nasser1245/Imona-Stand-Charger/README.md

# Imona-Stand-Charger
## 
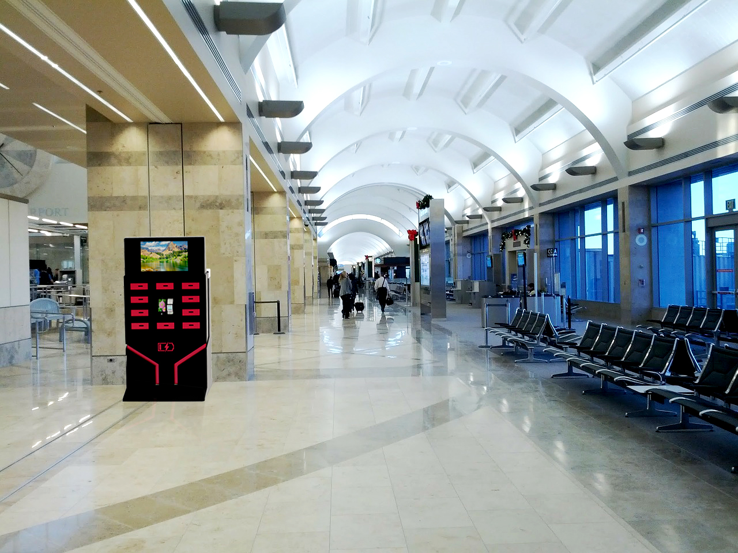
[picture p1: Brochure/123456789/2.jpg]
Imona Stand Charger
