nasser1245/Imona-Stand-Charger/Brochure/Text short.docx

کارا شارژ

دستگاهی برای شارژ امن و سریع گوشی در مکان های عمومی حس می شود. کارا شارژ یک دستگاه شارژ موبایل چند قفسه ای برای مکان های عمومی است. با کارا شارژ مشتریان و مراجعه کنندگان شما این امکان را پیدا می کنند که بدون دغدغه خاموش شدن گوشی شان به کار خود برسند و مطمئن باشند گوشی شان با اطلاعات ارزشمند ذخیره شده در آن در مکان امنی نگه داری می شود.

- احراز هویت مراجعه کنندگان با روش قدرتمند و امن شناسایی اثر انگشت
- امکان تعبیه دستگاه کارتخوان و اخذ هزینه شارژ

کارا شارژ برای چه جاهایی مناسب است

فرودگاه ها، ترمینال های مسافربری، تفرجگاه های بین راهی، مکان های زیارتی و سیاحتی، رستوران ها، مراکز فروش، سینما ها و تماشاخانه ها، باشگاه ها، بیمارستان ها و مراکز درمانی، ادارات و مراکز دولتی، هتل ها و مراکز اقامتی و ... از جمله مشتریان بالقوه کارا شارژ هستند.

ویژگی های کارا شارژ

طراحی منحصر به فرد که به محیط شما زیبایی خاصی می دهد.

بدنه فلزی مستحکم و ماندگار با رنگ الکترواستاتیک مقاوم در برابر خوردگی

قابلیت نگه داری و پشتیبانی بالا همراه با قفسه های ماژولار با قابلیت نصب آسان

ضد سرقت با درجه امنیتی بالا و قفل برقی داخلی مجزا به ازای هر قفسه

مکانیسم باز و بسته کردن اتوماتیک، همراه با درب بازشونده به داخل (ضد خرابکاری)

استفاده از دو جفت سیم جمع شونده به ازای هرقفسه قابل سفارش توسط مشتری (آیفون، اندروید، تایپ سی و ...)

قفل سیم شارژ با قابلیت تعویض آسان

قابلیت شارژ سریع با تکنولوژی Qualcomm Quick Charge 3.0

مکانیسم باز و بسته کردن سخت افزاری و نرم افزاری اضطراری قفسه ها توسط مسئول دستگاه

ضد آب و ضد گرد و خاک

LED های نشان دهنده وضعیت قفسه شارژ

تشخیص هویت با استفاده از سنسور اثر انگشت

باتری داخلی اضطراری

امکان کنترل و ارتباط از راه دور دستگاه با رابط اینترنتی

دوربین تعبیه شده با قابلیت ضبط تصاویر مراجعه کنندگان و ضبط ویدئو از محیط به صورت مدار بسته

گارانتی 18 ماهه و خدمات پس از فروش 5 ساله

ویژگی های قابل سفارش

امکان تعبیه صفحه نمایش جهت مصارف تبلیغاتی و اطلاع رسانی

امکان تعبیه پریز شارژ برای قفسه ها

امکان تعیین میزان هزینه شارژ و دریافت وجه با استفاده از دستگاه کارتخوان

امکان ارتباط با نرم افزار فروش یا نوبت دهی

خنک کنندگی مجزای هر قفسه با فن قدرتمند تعبیه شده برای بالا بردن راندمان شارژ (سفارشی)

امکان پرینت رسید گوشی و دریافت آن توسط رسید

مدل های دستگاه:

ایستاده

دیواری

رومیزی
