nasser1245/Imona-Stand-Charger/Brochure/text- new.docx

مکس شارژ چیست؟

با توجه به ظرفیت محدود باتری ها و پر رنگ شدن نقش تلفن های هوشمند در زندگی امروز نیاز به دستگاهی برای شارژ امن و سریع گوشی در مکان های عمومی حس می شود. مکس شارژ یک دستگاه شارژ موبایل چند قفسه ای برای مکان های عمومی است. با مکس شارژ مشتریان و مراجعه کنندگان شما این امکان را پیدا می کنند که بدون دغدغه خاموش شدن گوشی شان به کار خود برسند و مطمئن باشند گوشی شان با اطلاعات ارزشمند ذخیره شده در آن در مکان امنی نگه داری می شود. در صورت سفارش شما امکان تعبیه دستگاه کارتخوان و اخذ هزینه شارژ وجود دارد که می تواند به منبع درآمد خوبی برای محل کسب شما تبدیل شود.

احراز هویت مراجعه کنندگان

احراز هویت مراجعه کنندگان با روش قدرتمند و امن شناسایی اثر انگشت انجام می پذیرد. البته در صورت سفارش مشتری امکان احراز هویت با پرینت رسید وجود دارد. یک سیستم جانبی ضبط ویدئویی چهره نیز نیز به مسئول دستگاه کمک می کند در موارد نادر عدم تشخیص اثر انگشت؛ با تشخیص چهره مراجعه کننده نسبت به عودت تلفن همراه اقدام کند.

سیستم نرم افزاری قدرتمند آرشیو مراجعات و مدیریت از راه دور

یک سیستم جامع نرم افزاری آمار و تصاویر مراجه کنندگان، مدت زمان شارژ، ویدئوهای دوربین مدار بسته، مبلغ اخذ شده جهت شارژ و غیره را نگه داری و آرشیو می نماید و امکان گزارش گیری را به مسئول سیستم در صورت نیاز می دهد.

مکس شارژ برای چه جاهایی مناسب است؟

فرودگاه ها، ترمینال های مسافربری، تفرجگاه های بین راهی، اماکن های زیارتی و سیاحتی، رستوران ها، مراکز فروش، سینما ها و تماشاخانه ها، باشگاه ها، بیمارستان ها و مراکز درمانی، ادارات و مراکز دولتی، هتل ها و مراکز اقامتی و ... از جمله مشتریان بالقوه مکس شارژ هستند.

ویژگی های مکس شارژ

طراحی منحصر به فرد که به محیط شما زیبایی خاصی می دهد.

بدنه فلزی مستحکم و ماندگار با رنگ الکترواستاتیک مقاوم در برابر خوردگی

قابلیت نگه داری و پشتیبانی بالا همراه با قفسه های ماژولار با قابلیت نصب آسان

ضد سرقت با درجه امنیتی بالا و قفل برقی داخلی مجزا به ازای هر قفسه

مکانیسم باز و بسته کردن اتوماتیک، همراه با درب بازشونده به داخل (ضد خرابکاری)

استفاده از سه نوع رابط پرمصرف (اندرویید یا USB micro، لایتنینگ و USB type-c)

قابلیت شارژ با سیم شارژ گوشی و یا با پریز (شارژ گوشی)

نشانگر میزان شارژ به ازای هر اتصال

قفل سیم شارژ با قابلیت تعویض آسان

قابلیت شارژ سریع با تکنولوژی Qualcomm Quick Charge 3.0

مکانیسم باز و بسته کردن سخت افزاری و نرم افزاری اضطراری قفسه ها توسط مسئول دستگاه

تشخیص هویت با استفاده از سنسور اثر انگشت

باتری داخلی اضطراری

امکان کنترل و ارتباط از راه دور دستگاه با رابط اینترنتی

دوربین تعبیه شده با قابلیت ضبط تصاویر مراجعه کنندگان و ضبط ویدئو از محیط به صورت مدار بسته

گارانتی 18 ماهه و خدمات پس از فروش 5 ساله

ویژگی های قابل سفارش

امکان تعبیه صفحه نمایش جهت مصارف تبلیغاتی و اطلاع رسانی

امکان تعیین میزان هزینه شارژ و دریافت وجه با استفاده از دستگاه کارتخوان

خنک کنندگی مجزای هر قفسه با فن قدرتمند تعبیه شده برای بالا بردن راندمان شارژ

امکان پرینت رسید گوشی و دریافت آن توسط رسید

مدل های دستگاه:

ایستاده

دیواری

رومیزی

آدرس: تهران- چهارراه ولیعصر- جنب بازار کامپیوتر رضا- ساختمان 1504- طبقه 3- واحد 6

تلفن: 021-66402940

شرکت تجهیزات سها نوین
