nasser1245/Imona-Stand-Charger/Brochure/42x29.7-min.pdf

## و﹬︥_﹩\︀ی[︋︀_︨〉︀رش

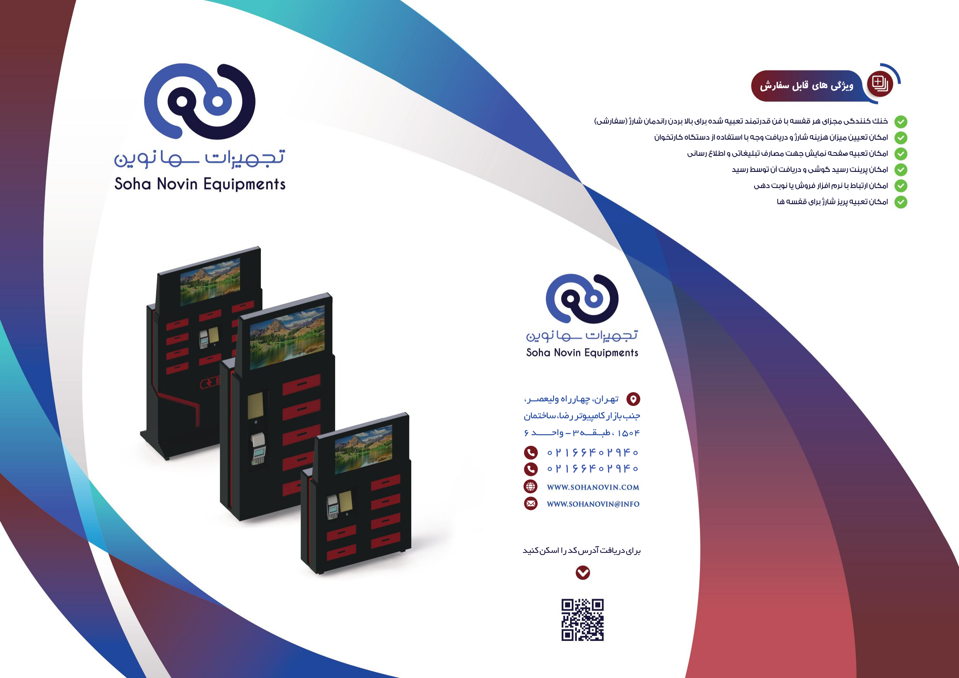
[picture p2: page 1]

### تهـران،چهـارراهولیعصــر، جنببازارکامپیوتررضا،ساختمان ،1504طبــقـــه-3واحــــــد6

02166402940
02166402940

براىدریافتآدرسکدرااسکنکنید

خنککنندگىمجزاىهرقفسهبافنقدرتمندتعبیهشدهبراىبالابردنراندمانشارژ(سفارشى) امکانتعیینمیزانهزینهشارژودریافتوجهبااستفادهازدستگاهکارتخوان امکانتعبیهصفحهنمای شجهتمصارفتبلیغاتىواطلاعرسانى امکانپرینترسیدگوشىودریافتآنتوسطرسید امکانارتباطبانرمافزارفرو شیانوبتدهى امکانتعبیهپریزشارژبراىقفسهها
