nasser1245/Imona-Stand-Charger/Brochure/02-01.jpg

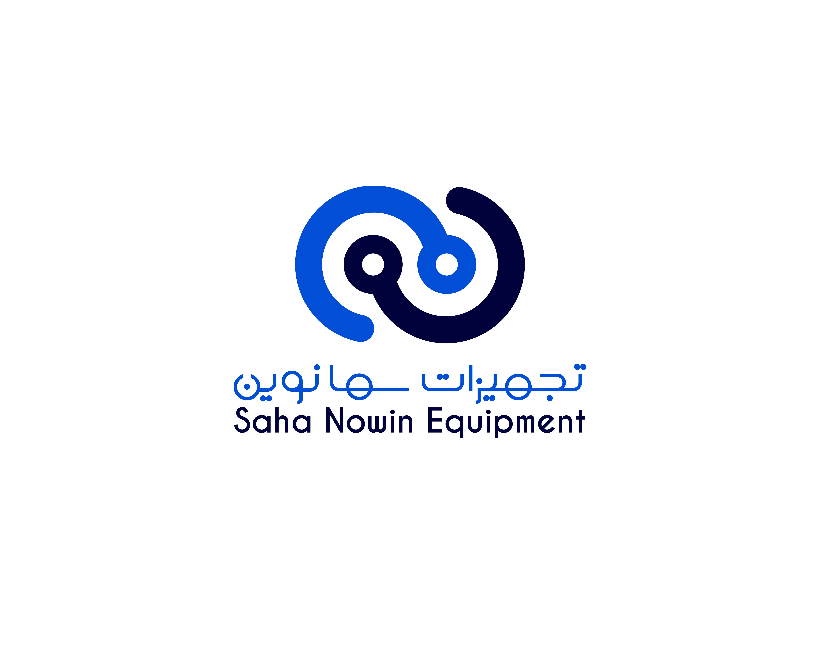
Brochure/02-01.jpg
