nasser1245/Imona-Stand-Charger/Brochure/00020.png

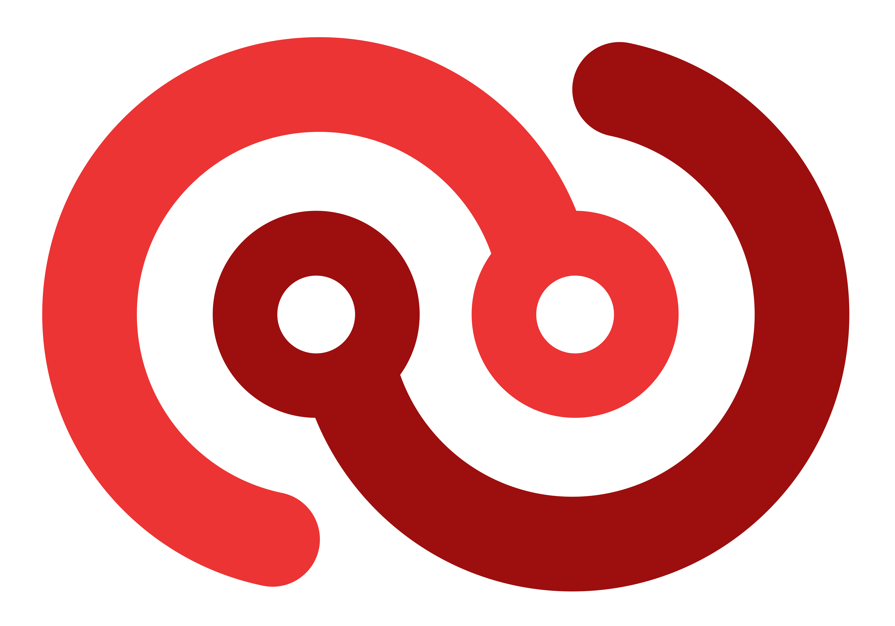
Brochure/00020.png
