nasser1245/Imona-Stand-Charger/Brochure/123456789/3.jpg

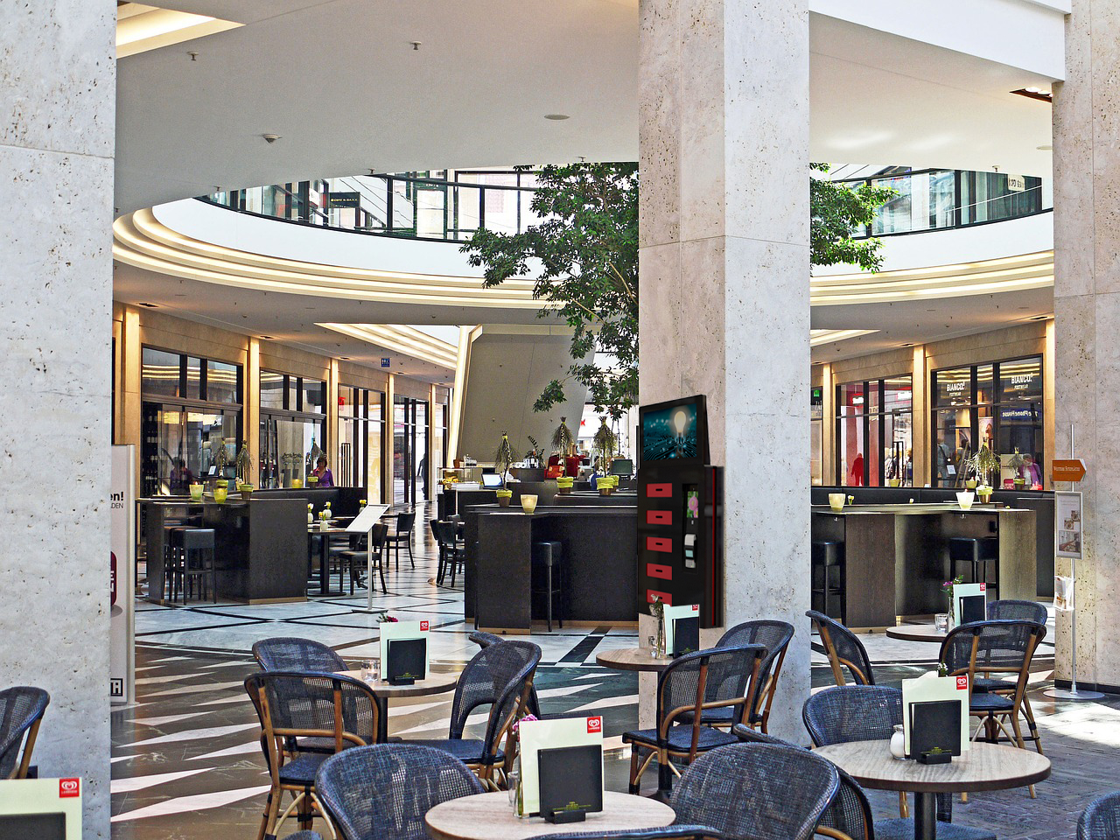
Brochure/123456789/3.jpg
