nasser1245/Imona-Stand-Charger/Brochure/123456789/4.jpg

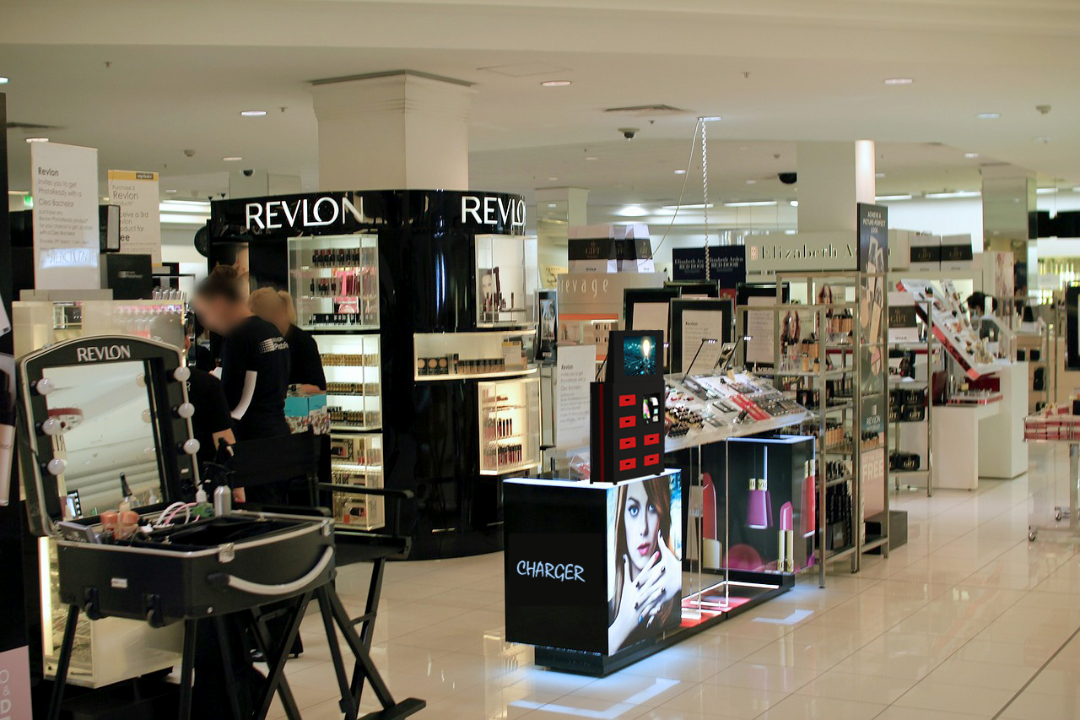
Brochure/123456789/4.jpg
