nasser1245/Imona-Stand-Charger/Brochure/airport-1659008_1280.jpg

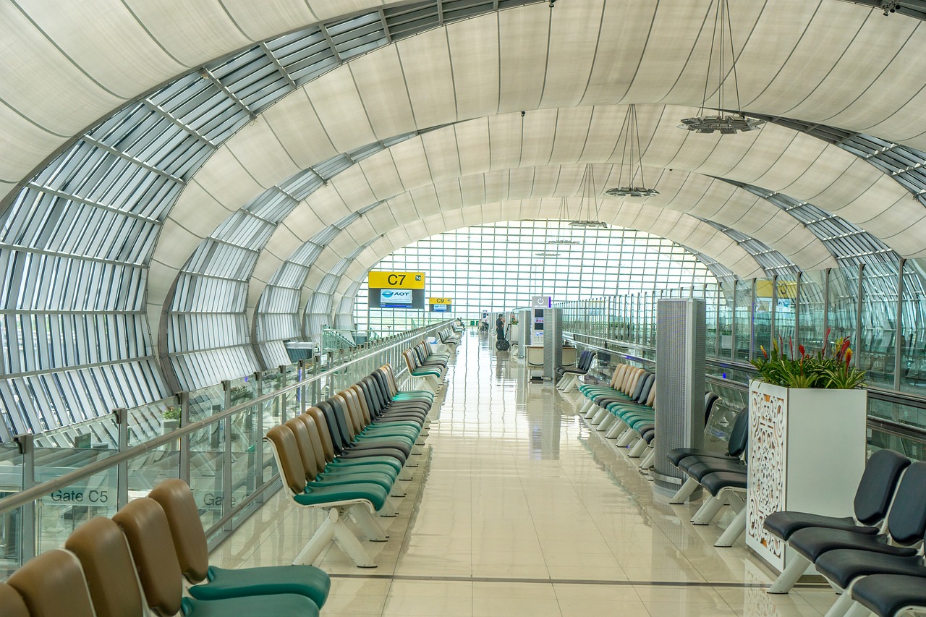
Brochure/airport-1659008_1280.jpg
