nasser1245/Imona-Stand-Charger/Brochure/airport-1807610_1280.jpg

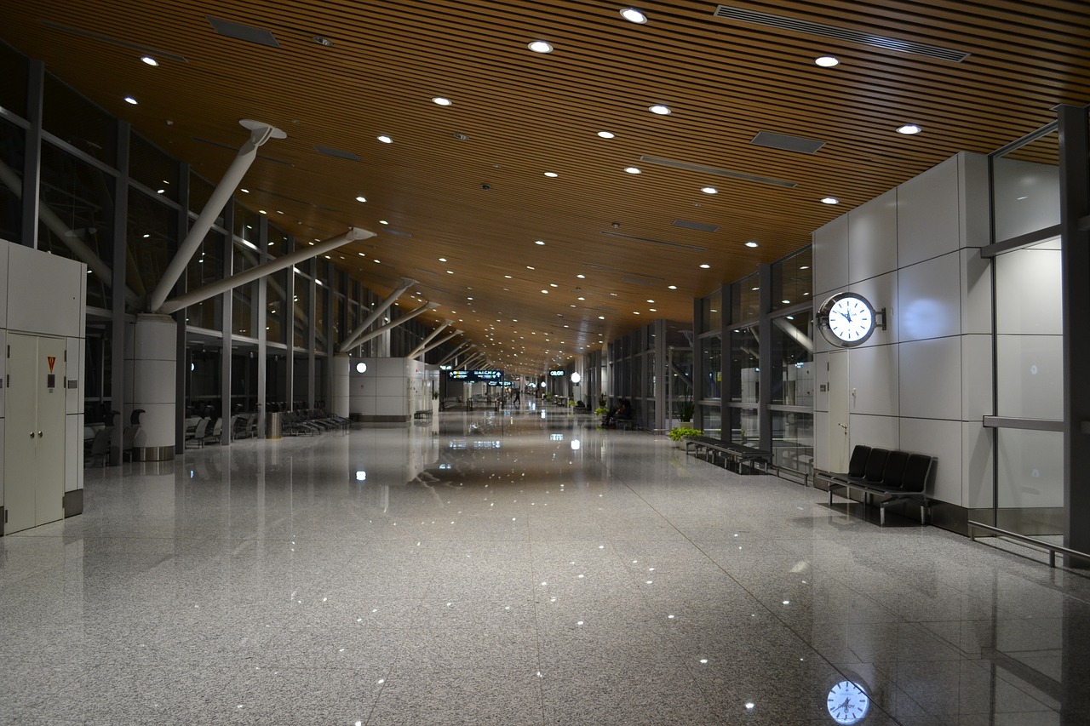
Brochure/airport-1807610_1280.jpg
