nasser1245/Imona-Stand-Charger/Brochure/baggage-hall-775540_1280.jpg

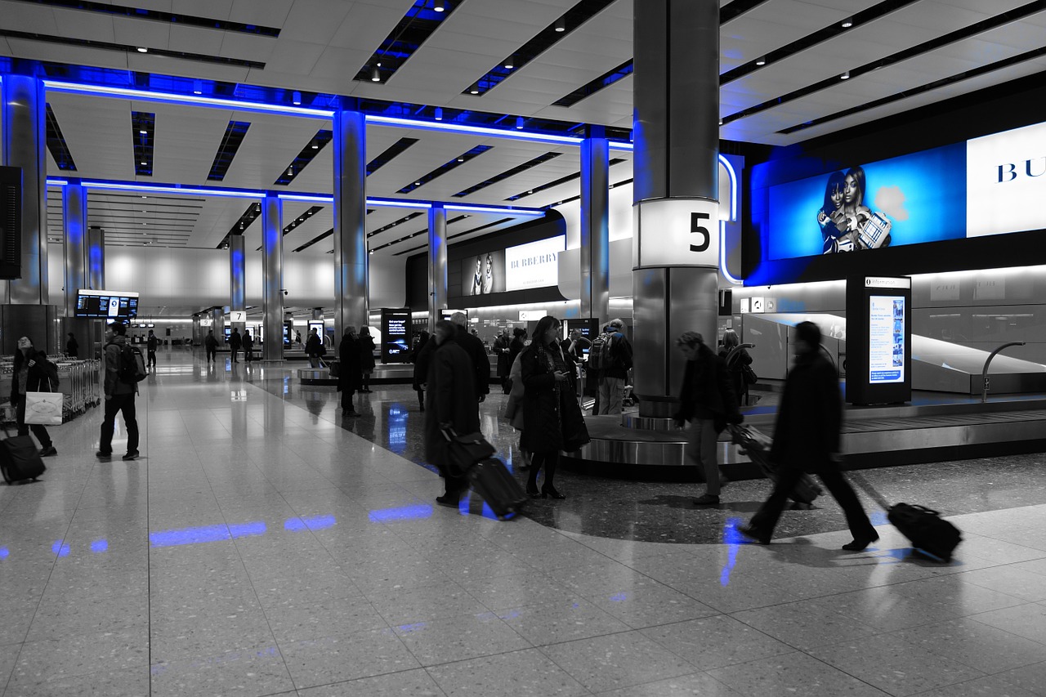
Brochure/baggage-hall-775540_1280.jpg
