nasser1245/Imona-Stand-Charger/Brochure/department-store-265135_1280.jpg

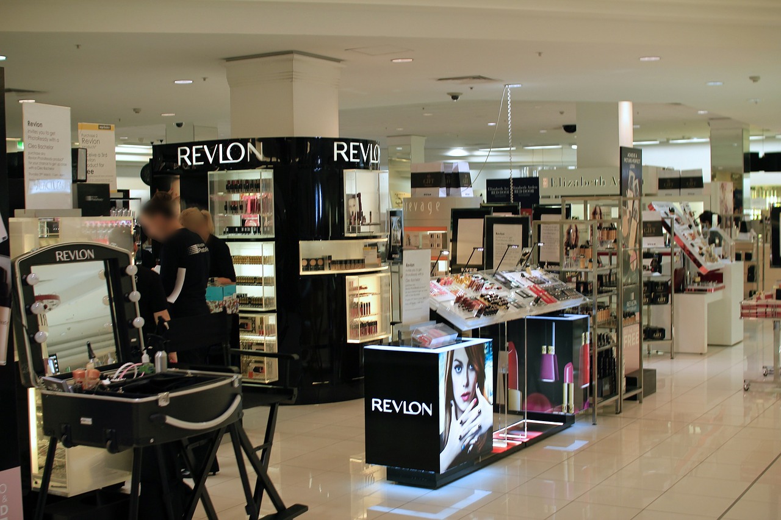
Brochure/department-store-265135_1280.jpg
