nasser1245/Imona-Stand-Charger/Brochure/galleon-1666084_1280.jpg

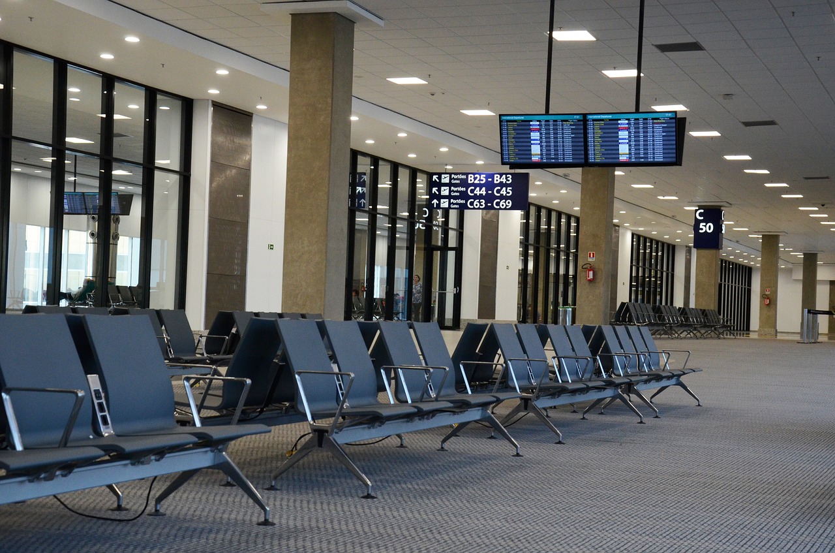
Brochure/galleon-1666084_1280.jpg
