nasser1245/Imona-Stand-Charger/Brochure/index1.png

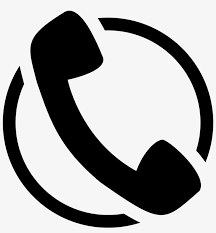
Brochure/index1.png
