nasser1245/Imona-Stand-Charger/Brochure/index.png

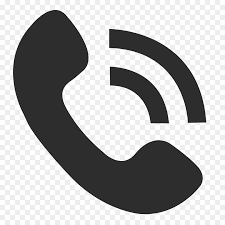
Brochure/index.png
