nasser1245/Imona-Stand-Charger/Brochure/mall-3157832_1280.jpg

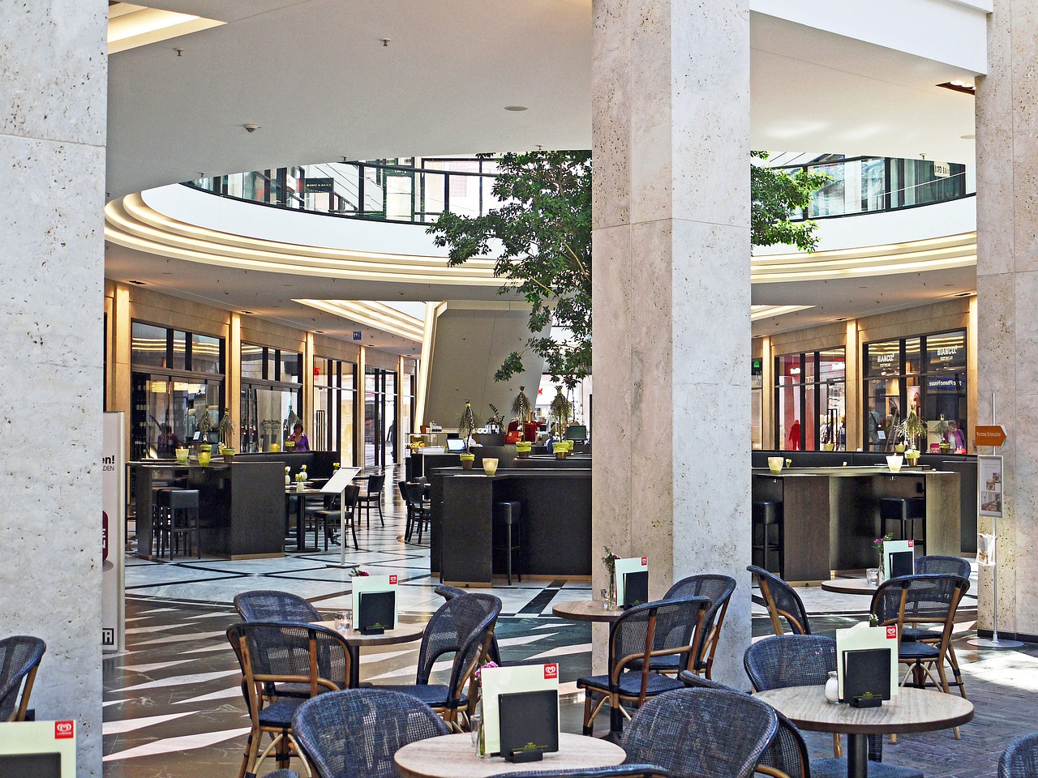
Brochure/mall-3157832_1280.jpg
