nasser1245/Imona-Stand-Charger/Brochure/new renders/stand1.png

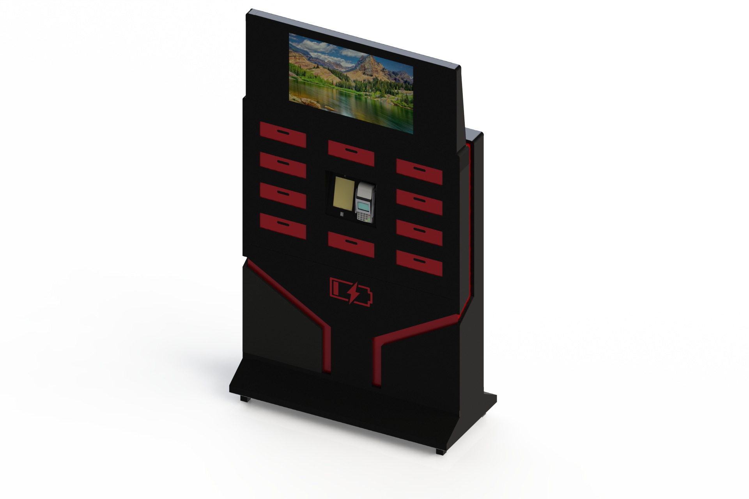
Brochure/new renders/stand1.png
