nasser1245/Imona-Stand-Charger/Brochure/new renders/stand2.png

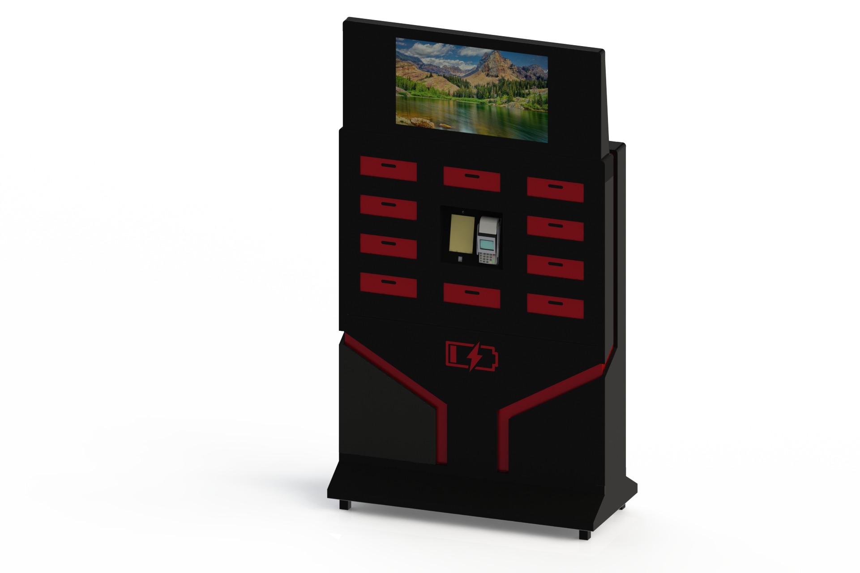
Brochure/new renders/stand2.png
