nasser1245/Imona-Stand-Charger/Brochure/new renders/stand3.png

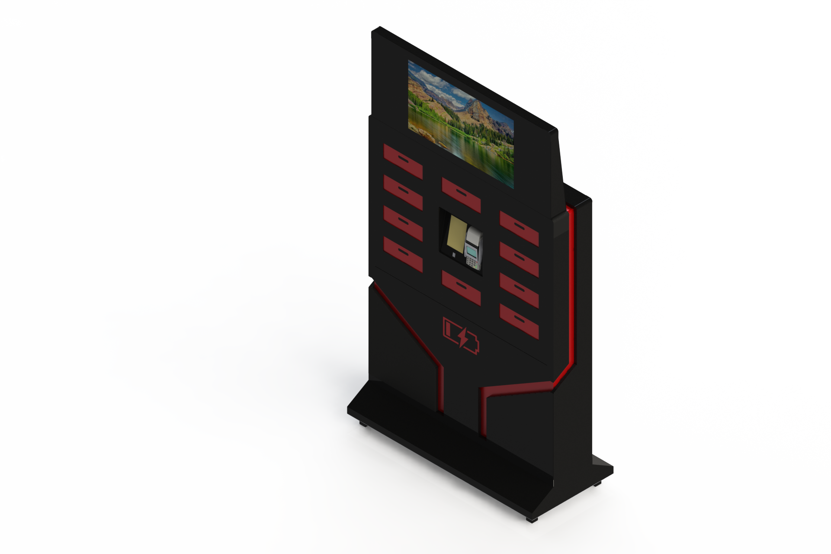
Brochure/new renders/stand3.png
