nasser1245/Imona-Stand-Charger/Brochure/new renders/stand4.png

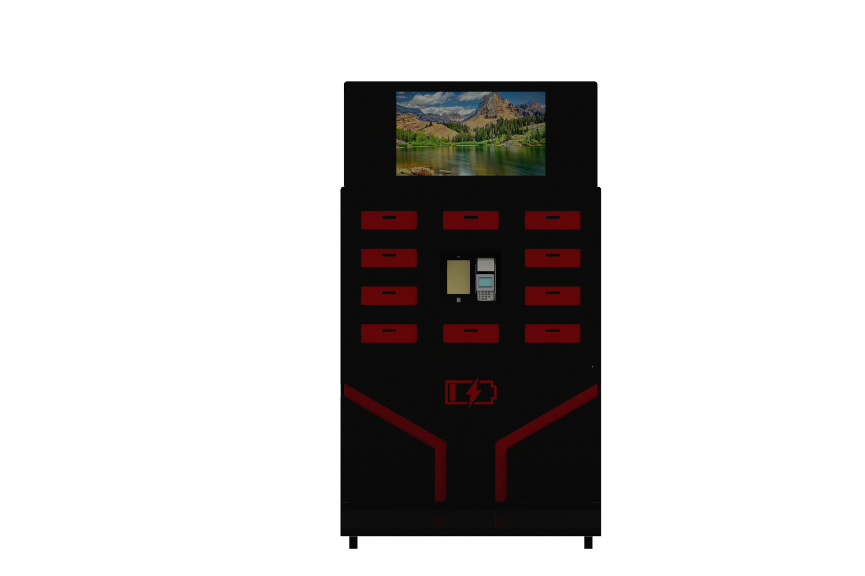
Brochure/new renders/stand4.png
