nasser1245/Imona-Stand-Charger/Brochure/new renders/standSimple1.png

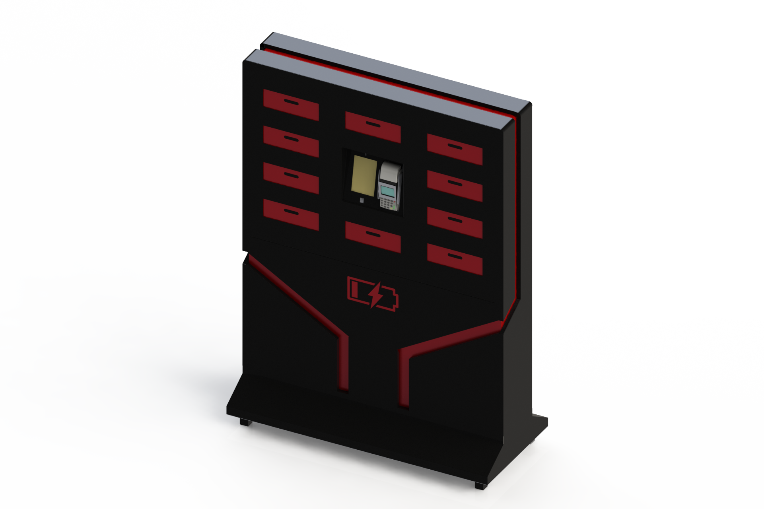
Brochure/new renders/standSimple1.png
