nasser1245/Imona-Stand-Charger/Brochure/new renders/standSimple3.png

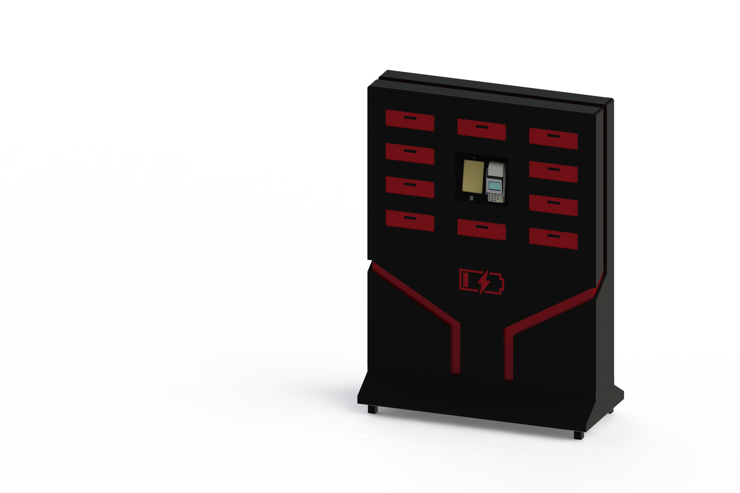
Brochure/new renders/standSimple3.png
