nasser1245/Imona-Stand-Charger/Brochure/new renders/standSimple4.png

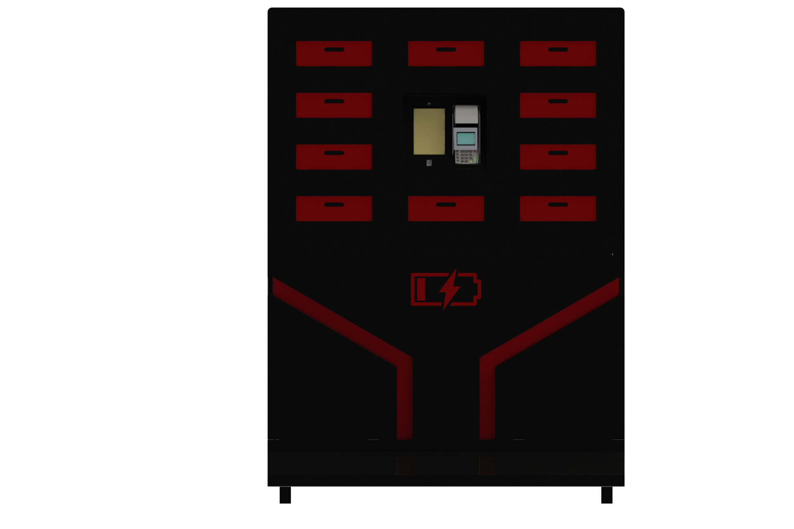
Brochure/new renders/standSimple4.png
