nasser1245/Imona-Stand-Charger/Brochure/new renders/table1.png

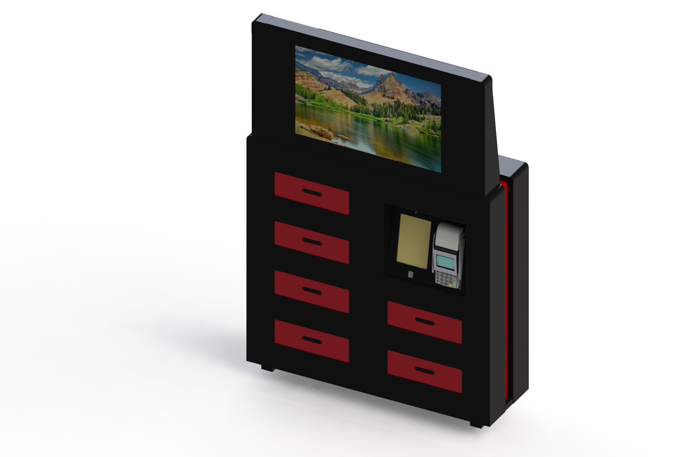
Brochure/new renders/table1.png
