nasser1245/Imona-Stand-Charger/Brochure/new renders/table2.png

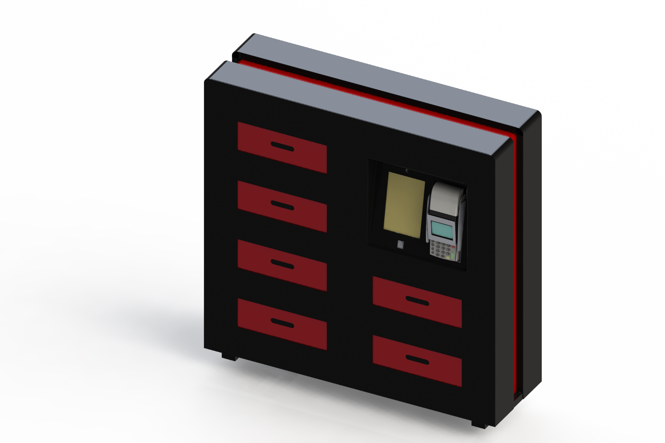
Brochure/new renders/table2.png
