nasser1245/Imona-Stand-Charger/Brochure/new renders/Untitled.JPG

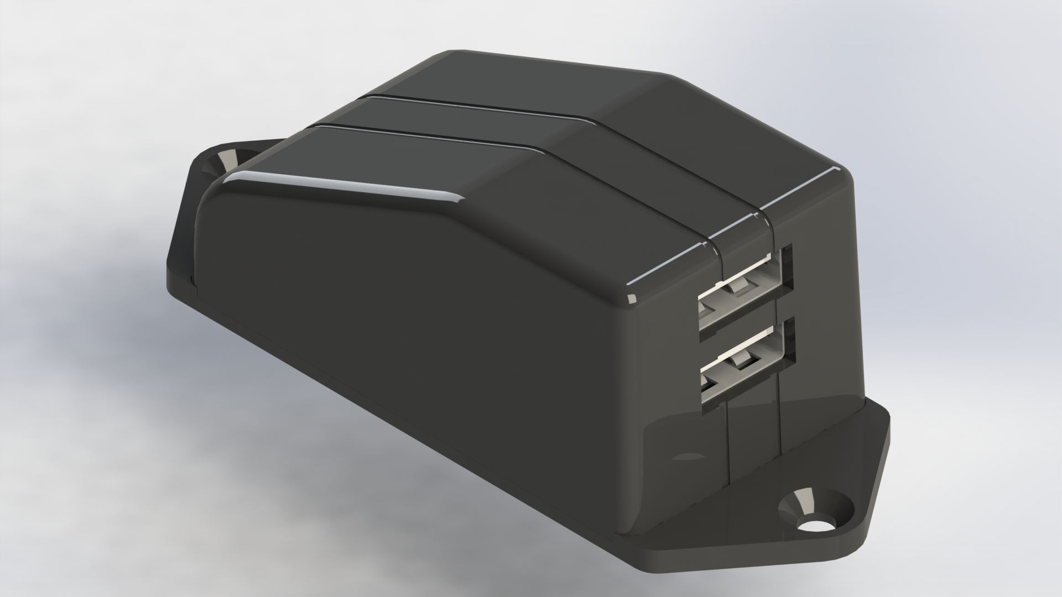
Brochure/new renders/Untitled.JPG
