nasser1245/Imona-Stand-Charger/Brochure/renders/1.JPG

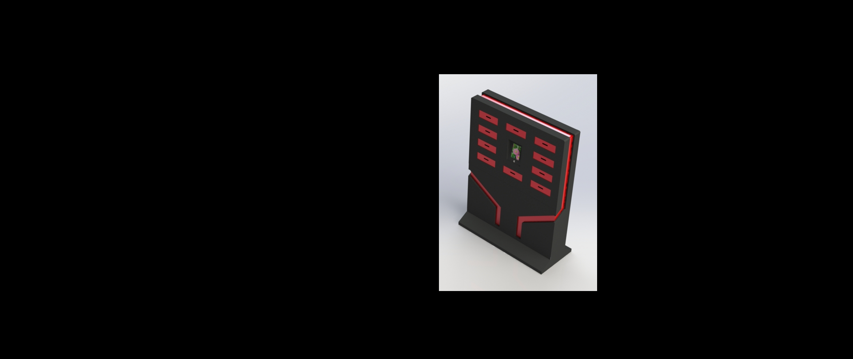
Brochure/renders/1.JPG
