nasser1245/Imona-Stand-Charger/Brochure/renders/b3.png

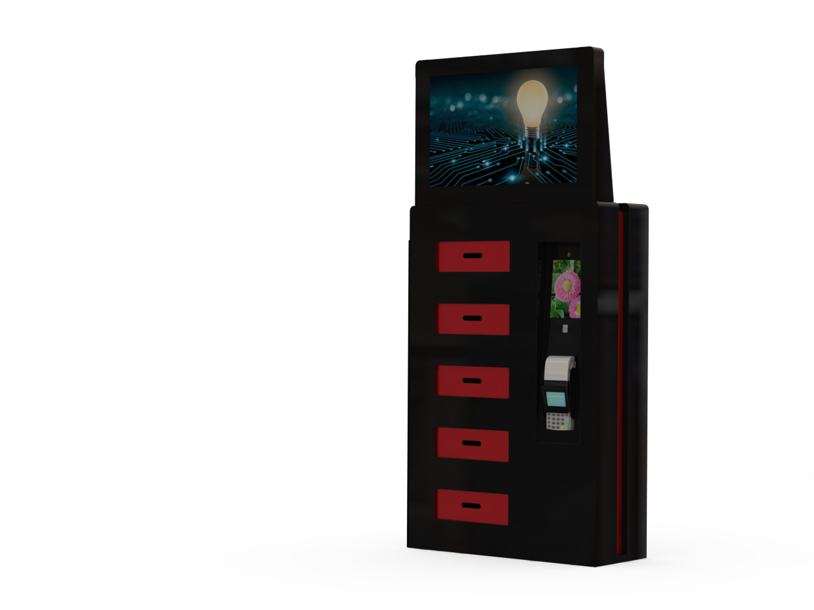
Brochure/renders/b3.png
