nasser1245/Imona-Stand-Charger/Brochure/renders/b4.png

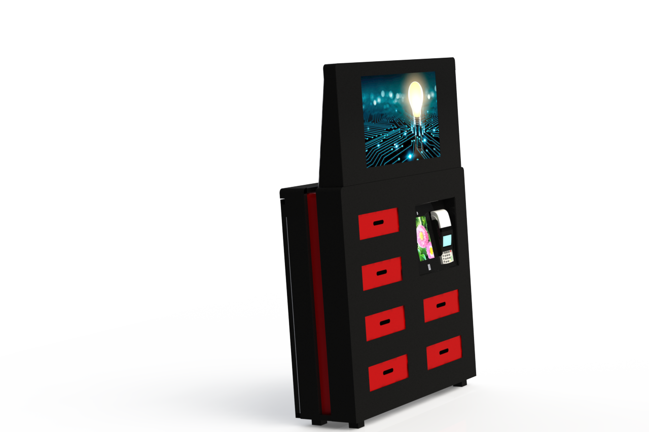
Brochure/renders/b4.png
