nasser1245/Imona-Stand-Charger/Brochure/renders/f1.JPG

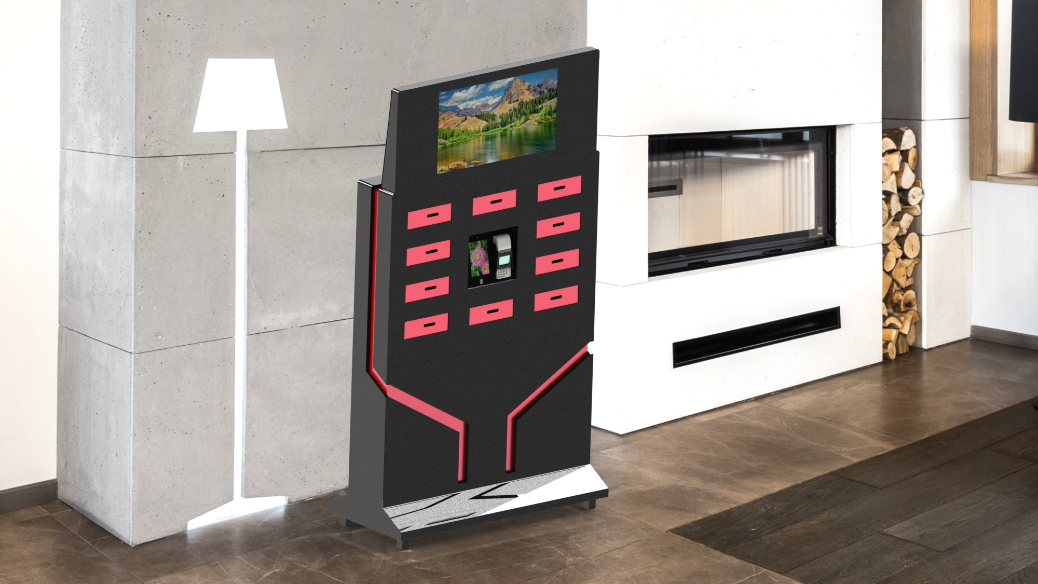
Brochure/renders/f1.JPG
