nasser1245/Imona-Stand-Charger/Brochure/renders/f2.JPG

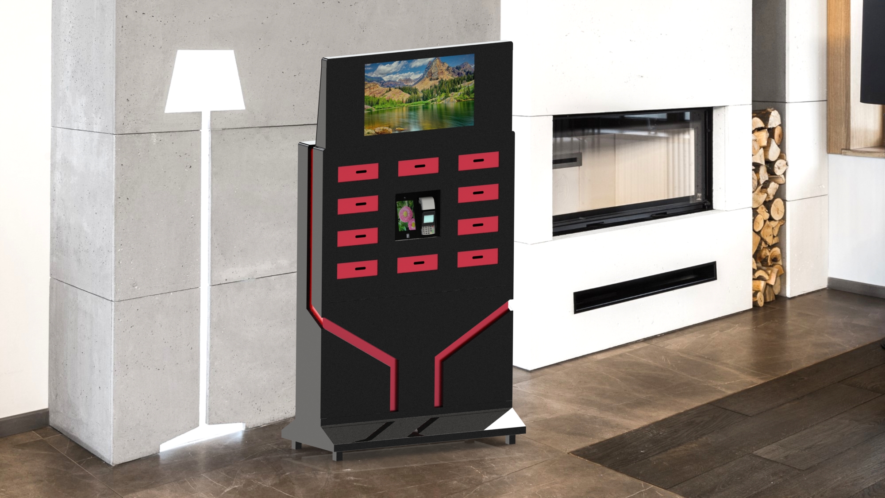
Brochure/renders/f2.JPG
