nasser1245/Imona-Stand-Charger/Brochure/renders/f3.JPG

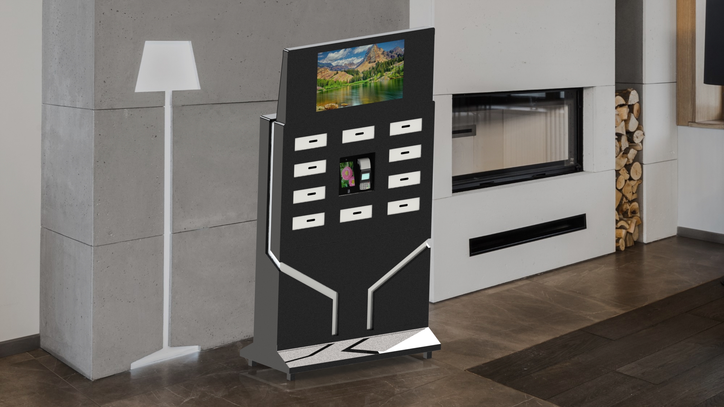
Brochure/renders/f3.JPG
