nasser1245/Imona-Stand-Charger/Brochure/renders/f4.JPG

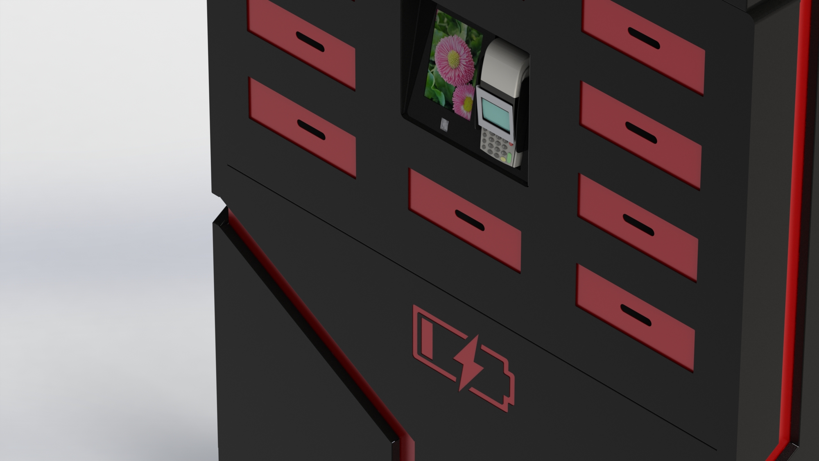
Brochure/renders/f4.JPG
