nasser1245/Imona-Stand-Charger/Brochure/renders/f5.JPG

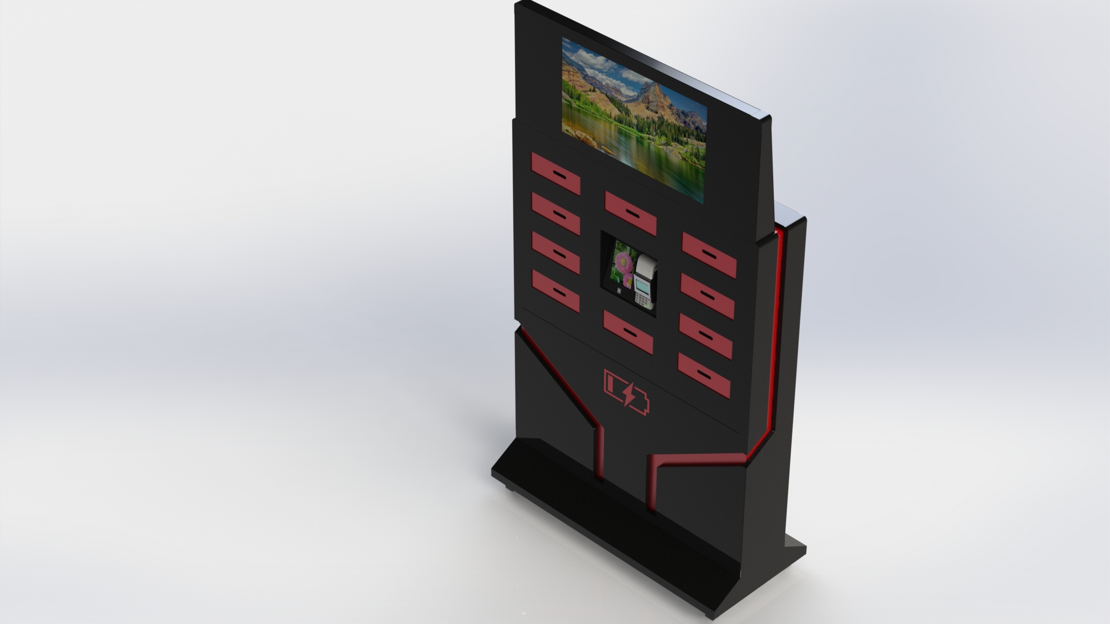
Brochure/renders/f5.JPG
