nasser1245/Imona-Stand-Charger/Brochure/renders/f6.JPG

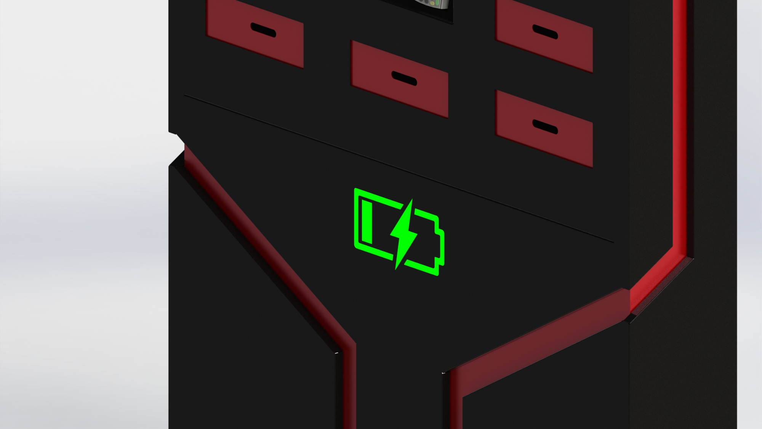
Brochure/renders/f6.JPG
