nasser1245/Imona-Stand-Charger/Brochure/renders/f7.png

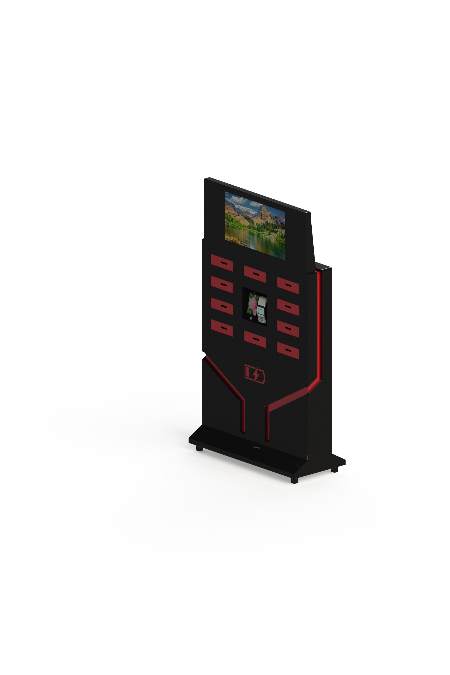
Brochure/renders/f7.png
