nasser1245/Imona-Stand-Charger/Brochure/renders/f8.png

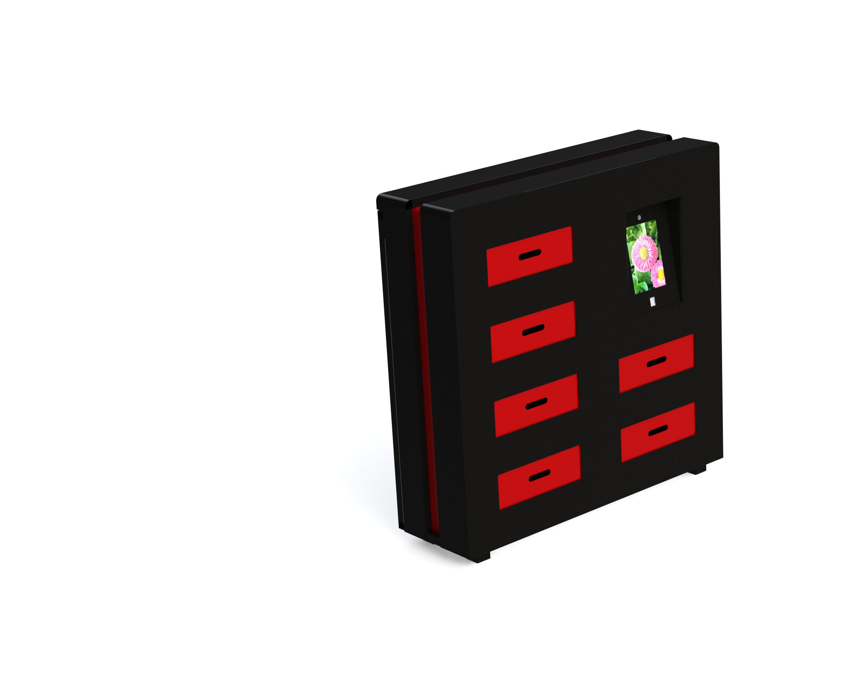
Brochure/renders/f8.png
