nasser1245/Imona-Stand-Charger/Brochure/renders/f9.png

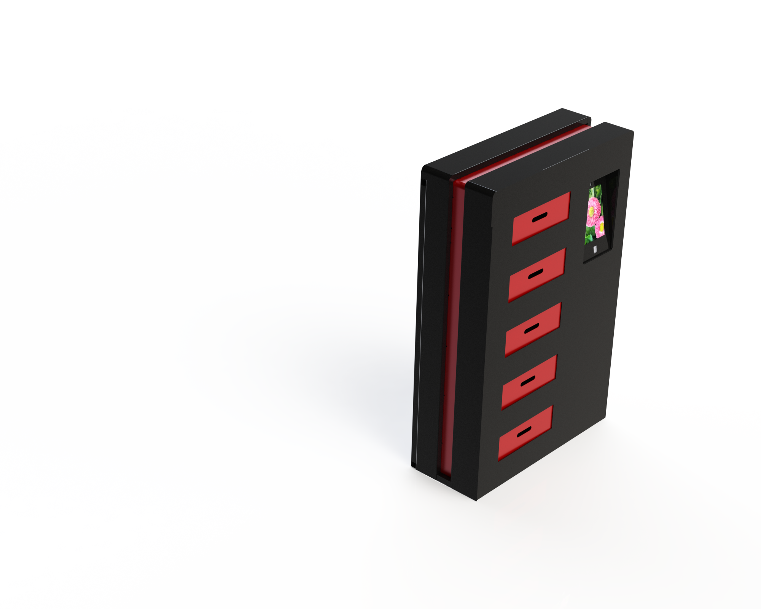
Brochure/renders/f9.png
