nasser1245/Imona-Stand-Charger/Brochure/renders/l-1.JPG

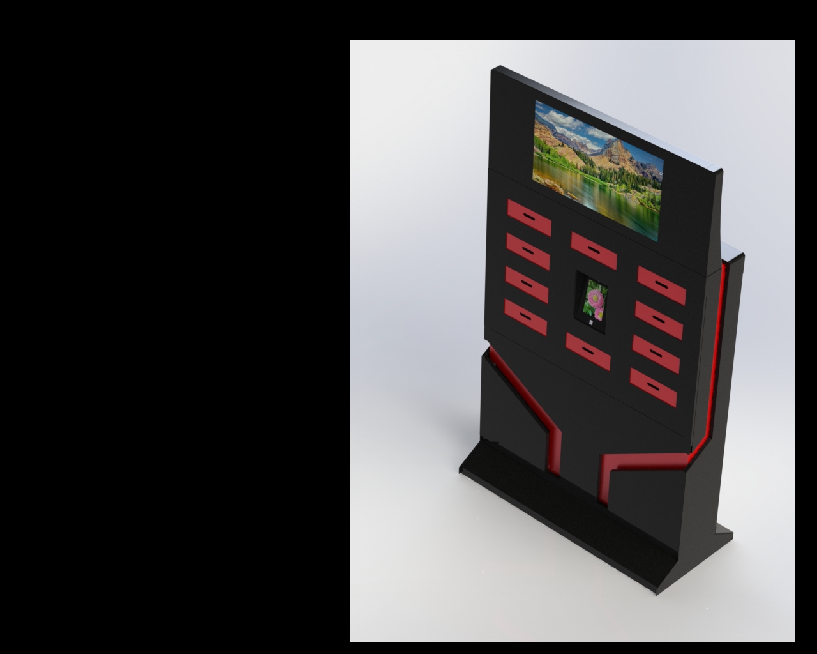
Brochure/renders/l-1.JPG
