nasser1245/Imona-Stand-Charger/Brochure/renders/l-2.JPG

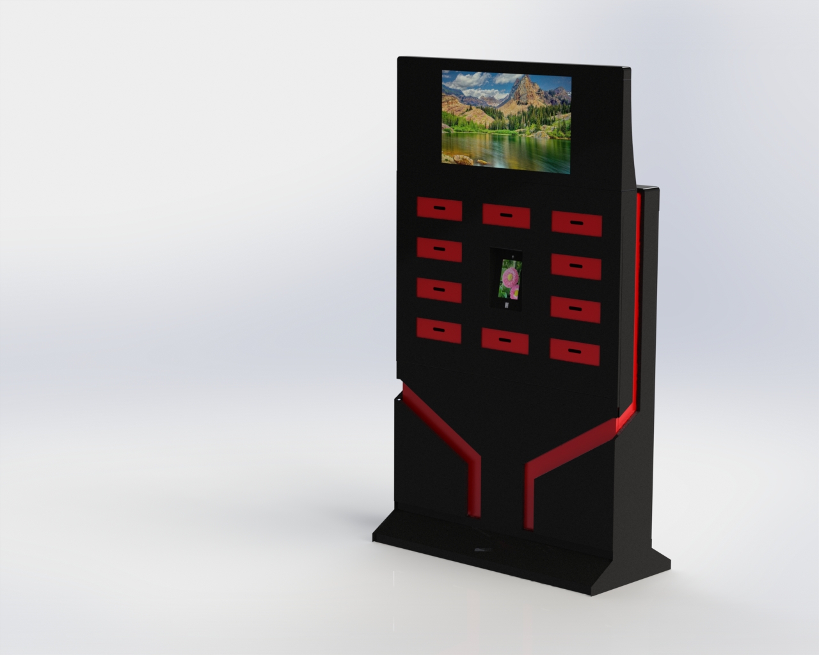
Brochure/renders/l-2.JPG
