nasser1245/Imona-Stand-Charger/Brochure/renders/l-3.JPG

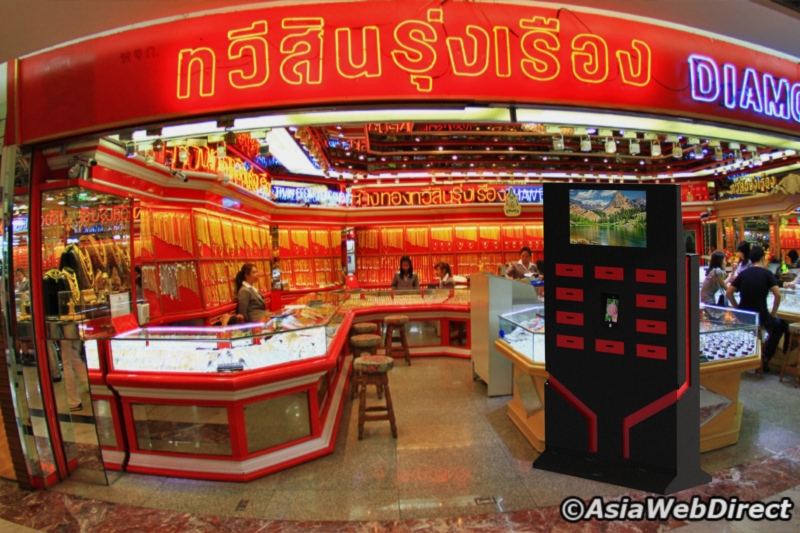
Brochure/renders/l-3.JPG
