nasser1245/Imona-Stand-Charger/Brochure/renders/Untitled.JPG

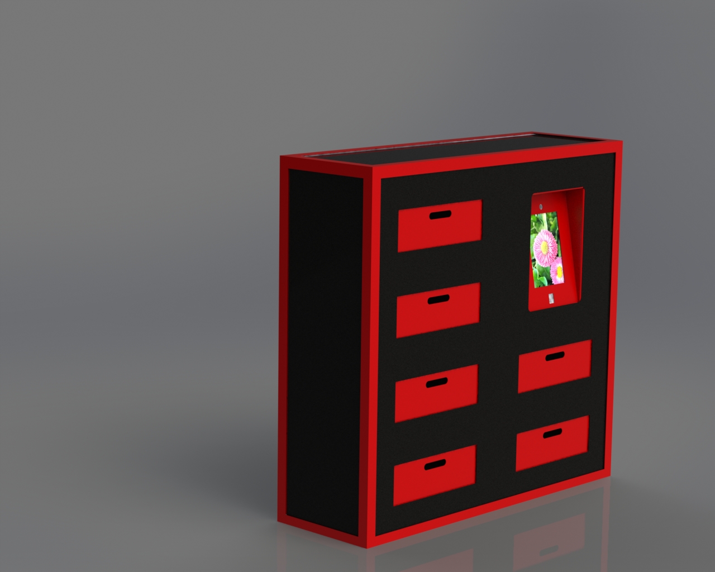
Brochure/renders/Untitled.JPG
