nasser1245/Imona-Stand-Charger/Brochure/renders/w12.JPG

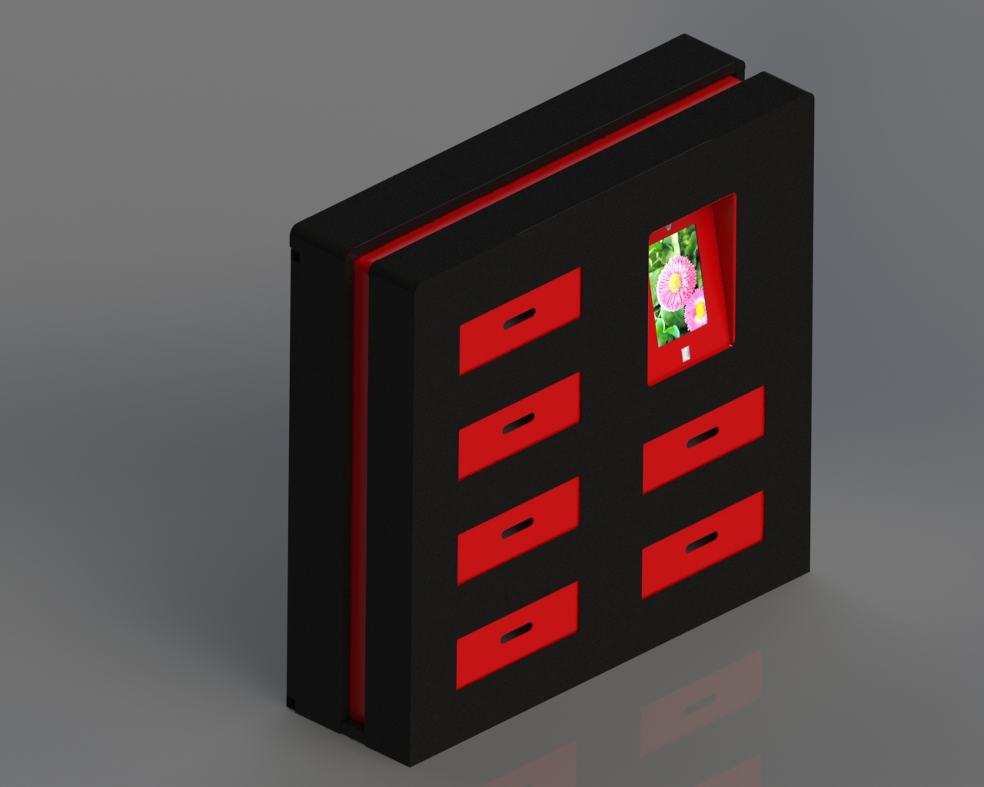
Brochure/renders/w12.JPG
