nasser1245/Imona-Stand-Charger/Brochure/renders/w-1.JPG

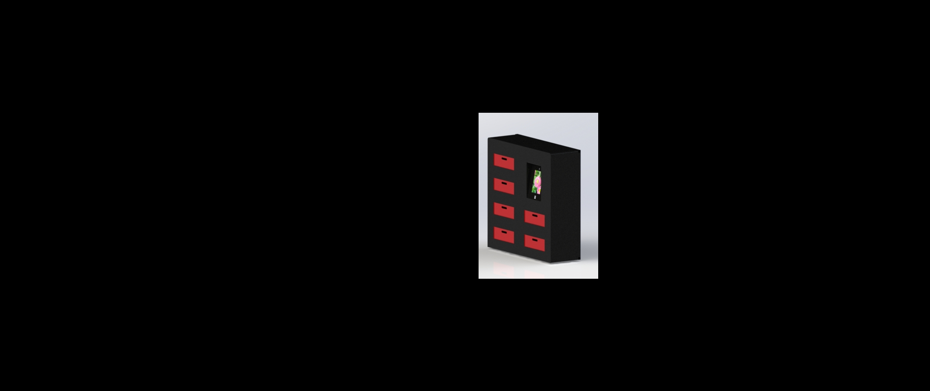
Brochure/renders/w-1.JPG
