nasser1245/Imona-Stand-Charger/Brochure/renders/w-2.JPG

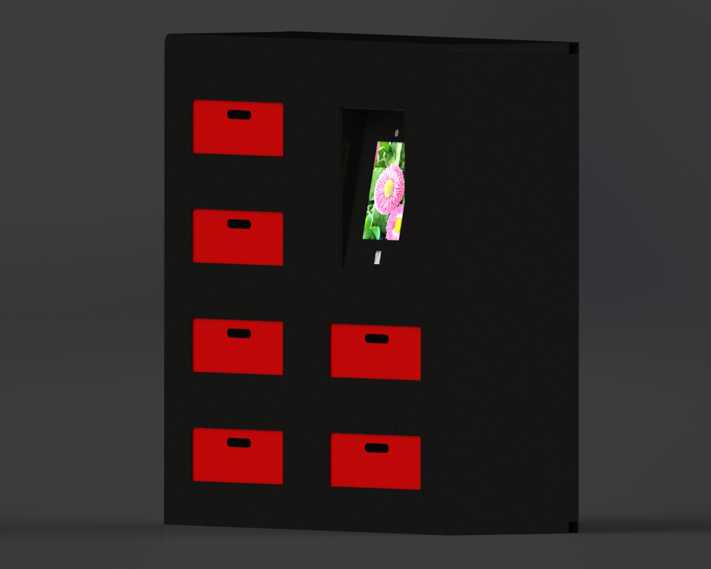
Brochure/renders/w-2.JPG
