nasser1245/Imona-Stand-Charger/Brochure/renders/w-3.JPG

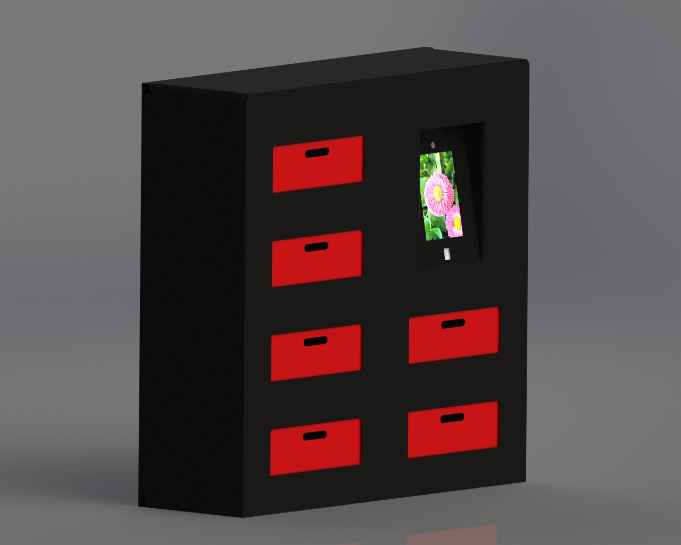
Brochure/renders/w-3.JPG
