nasser1245/Imona-Stand-Charger/Brochure/renders/w-4.JPG

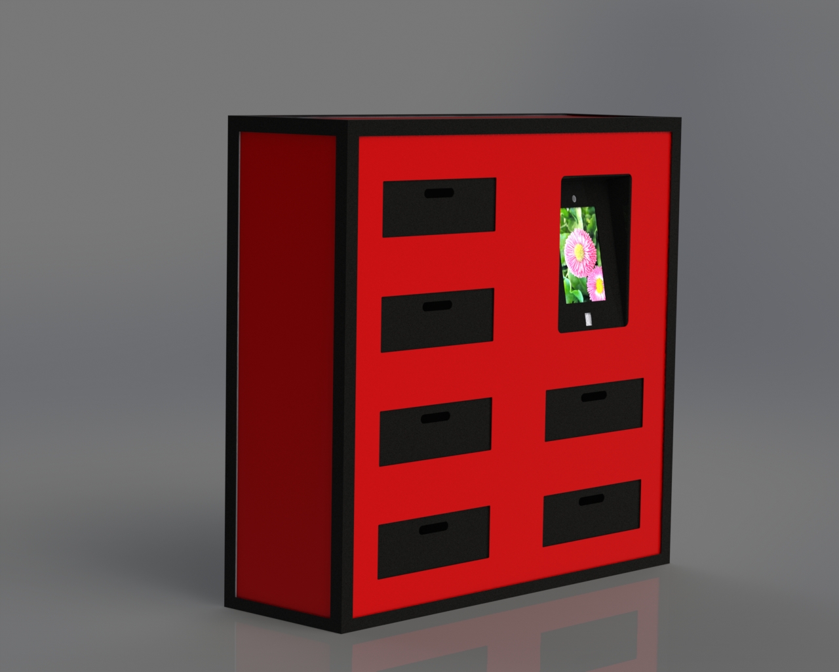
Brochure/renders/w-4.JPG
