nasser1245/Imona-Stand-Charger/Brochure/renders/w-5.JPG

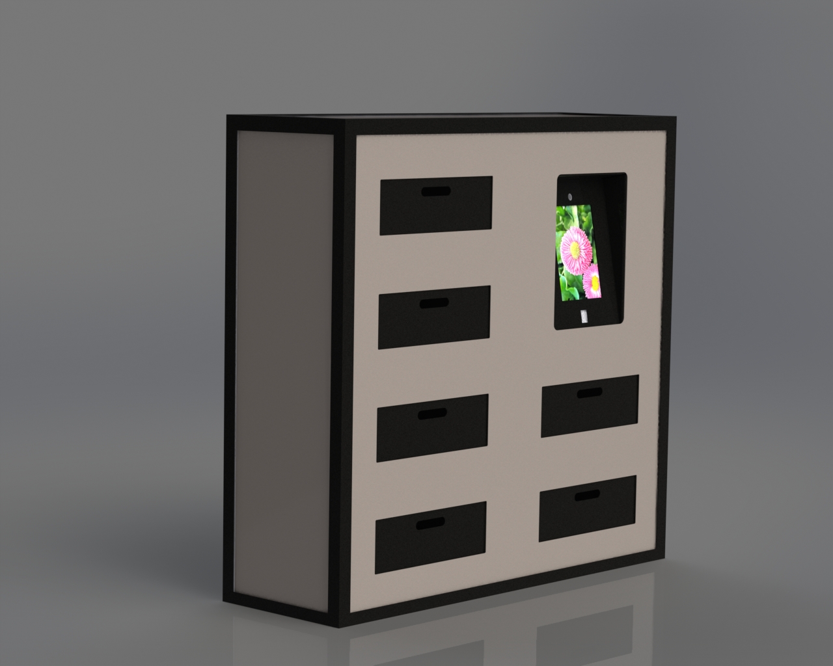
Brochure/renders/w-5.JPG
