nasser1245/Imona-Stand-Charger/Brochure/renders/w-6.JPG

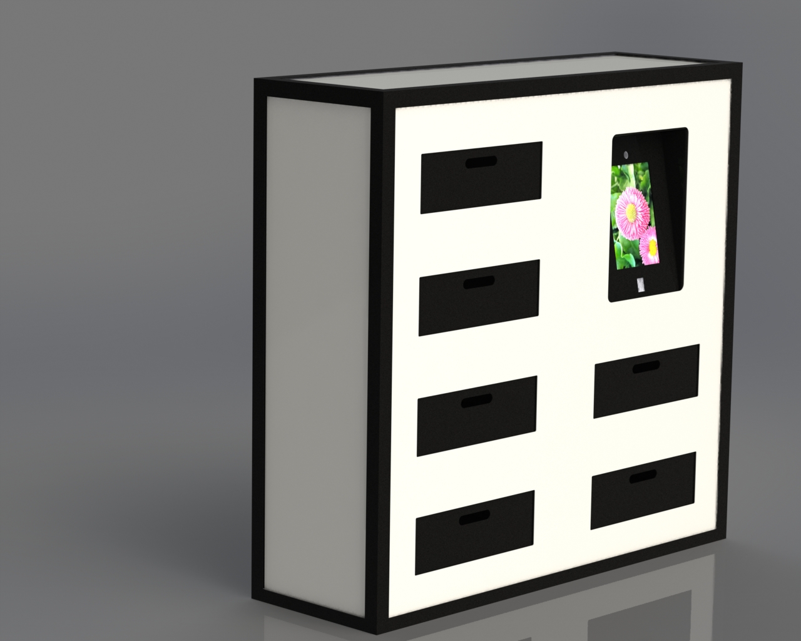
Brochure/renders/w-6.JPG
