nasser1245/Imona-Stand-Charger/Brochure/renders/w-7.JPG

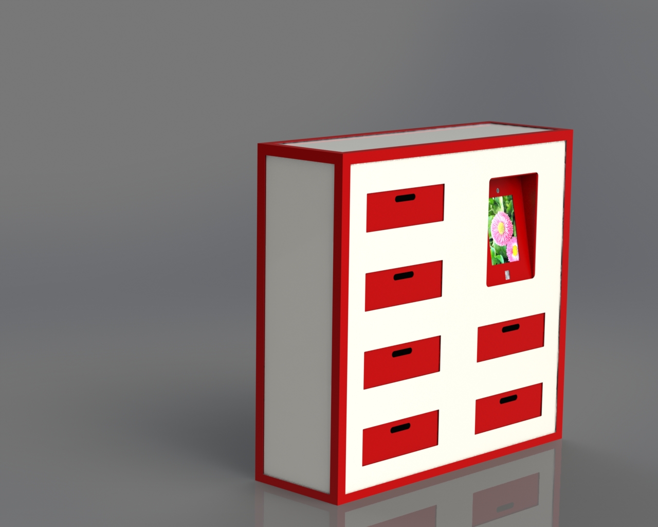
Brochure/renders/w-7.JPG
