nasser1245/Imona-Stand-Charger/Brochure/renders/w-8.JPG

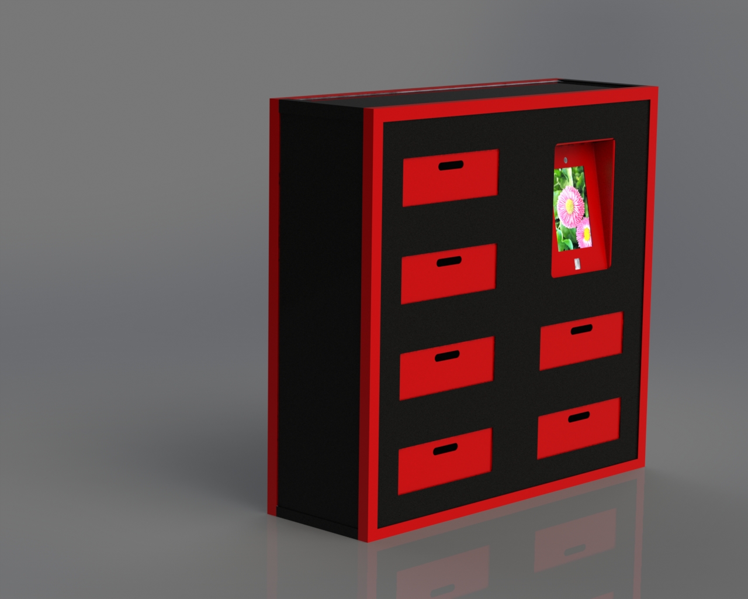
Brochure/renders/w-8.JPG
