nasser1245/Imona-Stand-Charger/Brochure/renders/w-9.JPG

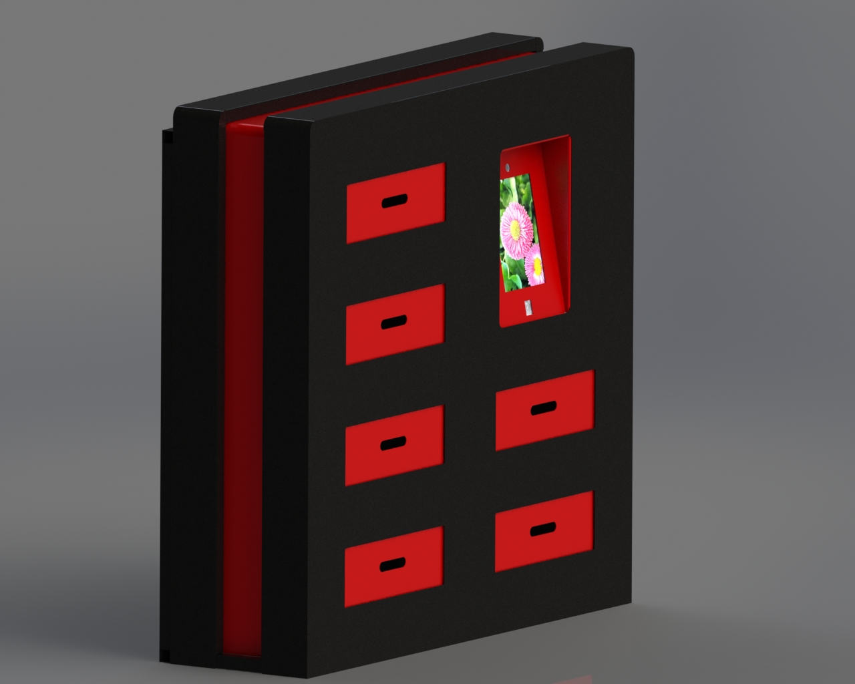
Brochure/renders/w-9.JPG
