nasser1245/Imona-Stand-Charger/Brochure/renders/w-13.JPG

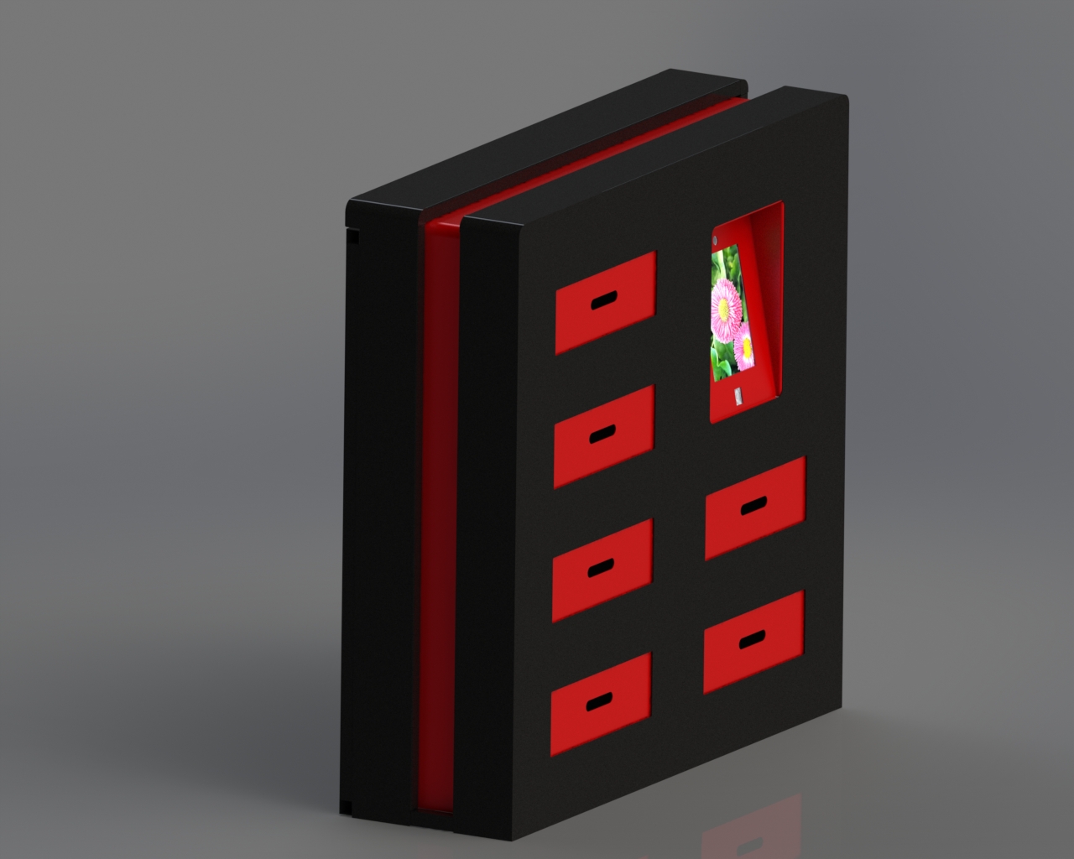
Brochure/renders/w-13.JPG
