nasser1245/Imona-Stand-Charger/Brochure/renders/w-14.JPG

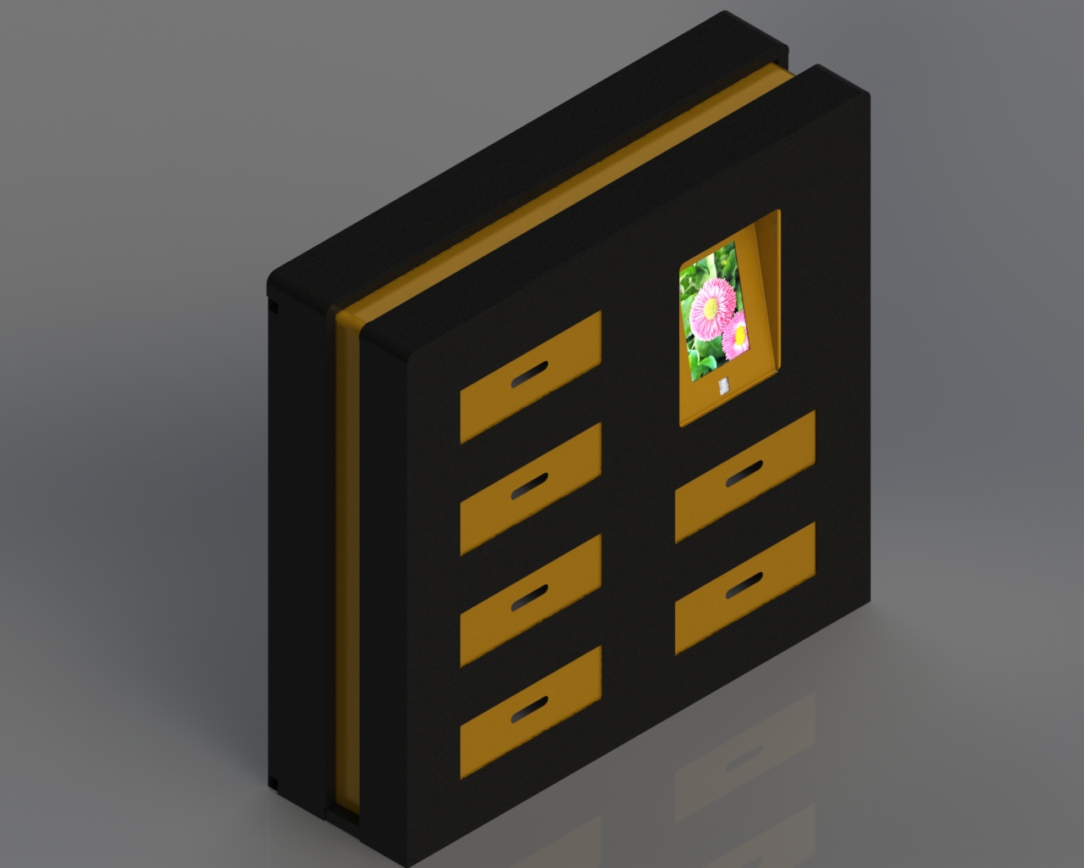
Brochure/renders/w-14.JPG
