nasser1245/Imona-Stand-Charger/Brochure/santa-ana-86680_1280.jpg

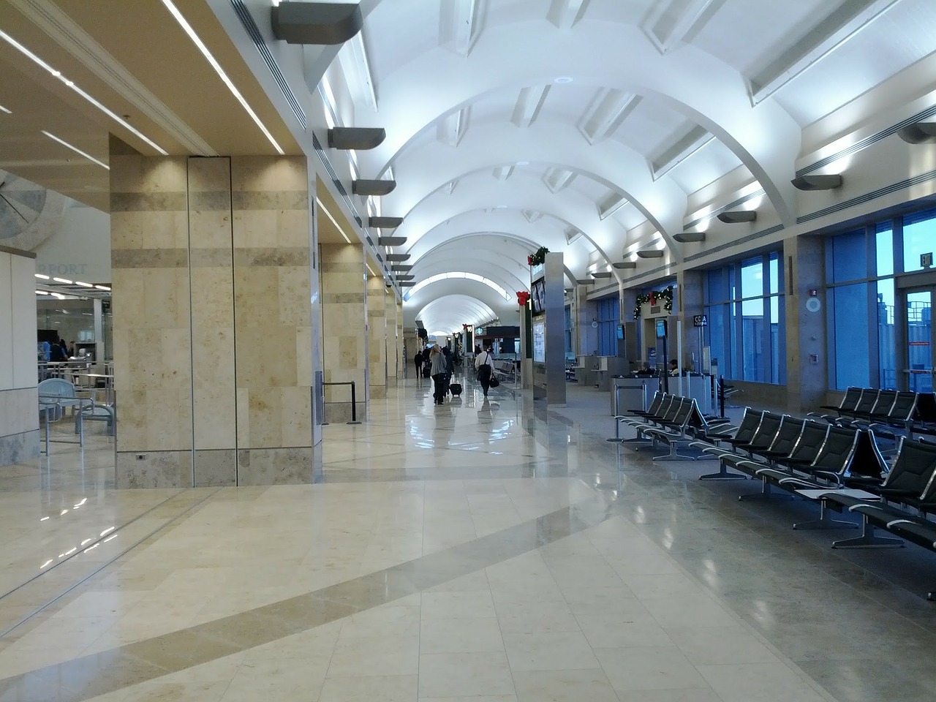
Brochure/santa-ana-86680_1280.jpg
