nasser1245/Imona-Stand-Charger/Brochure/waiting-room-548136_1280.jpg

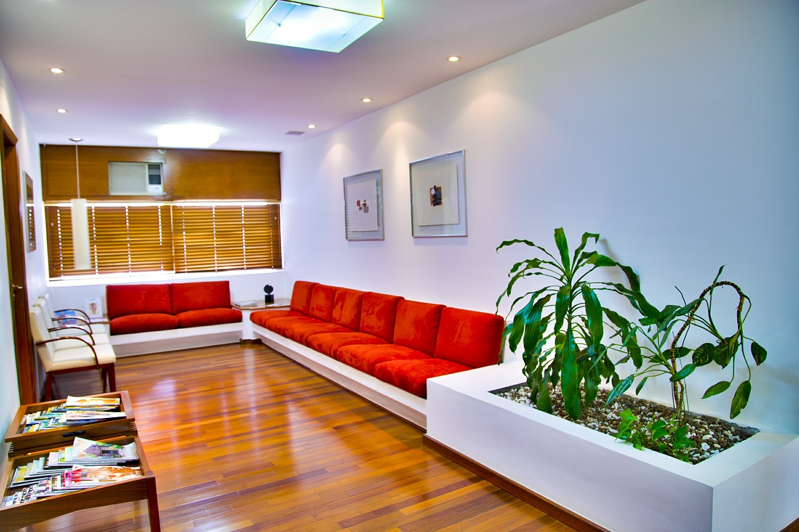
Brochure/waiting-room-548136_1280.jpg
