nasser1245/Imona-Stand-Charger/charger CODE/charge1.png

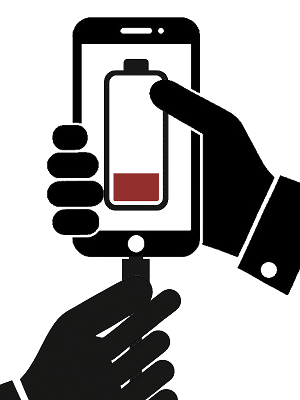
charger CODE/charge1.png
