nasser1245/Imona-Stand-Charger/charger CODE/charge-min.png

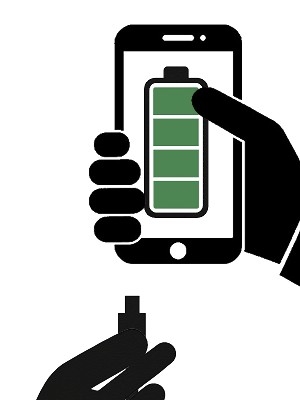
charger CODE/charge-min.png
