nasser1245/Imona-Stand-Charger/charger CODE/charge.gif

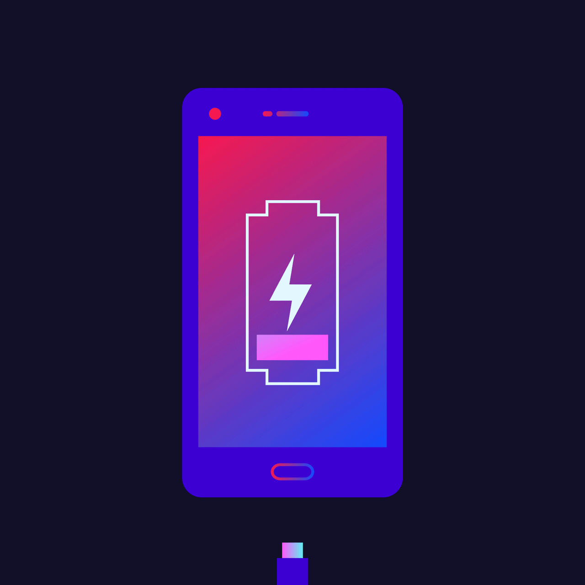
charger CODE/charge.gif
