nasser1245/Imona-Stand-Charger/charger CODE/giphy.gif

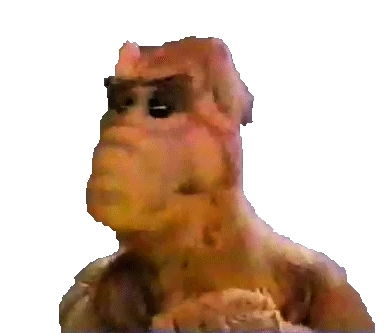
charger CODE/giphy.gif
