nasser1245/Imona-Stand-Charger/charger CODE/typec.jpg

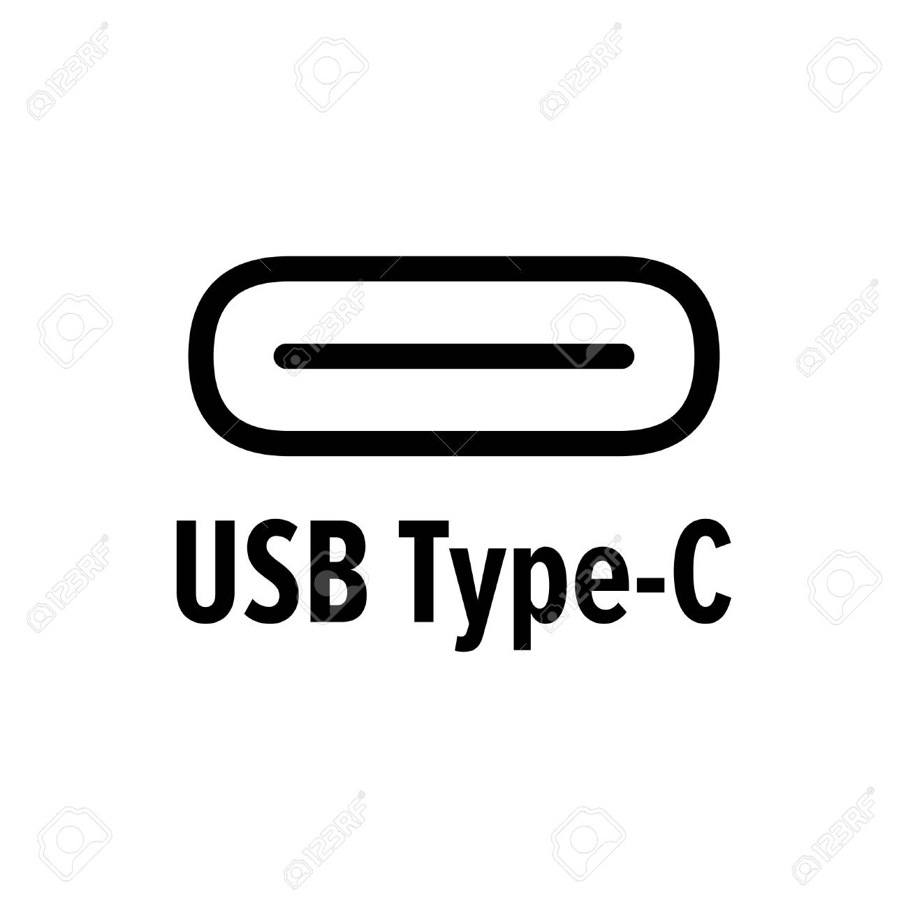
charger CODE/typec.jpg
