nasser1245/Imona-Stand-Charger/electroparts/ir sensor with led/ir sensor with capacitor.jpg

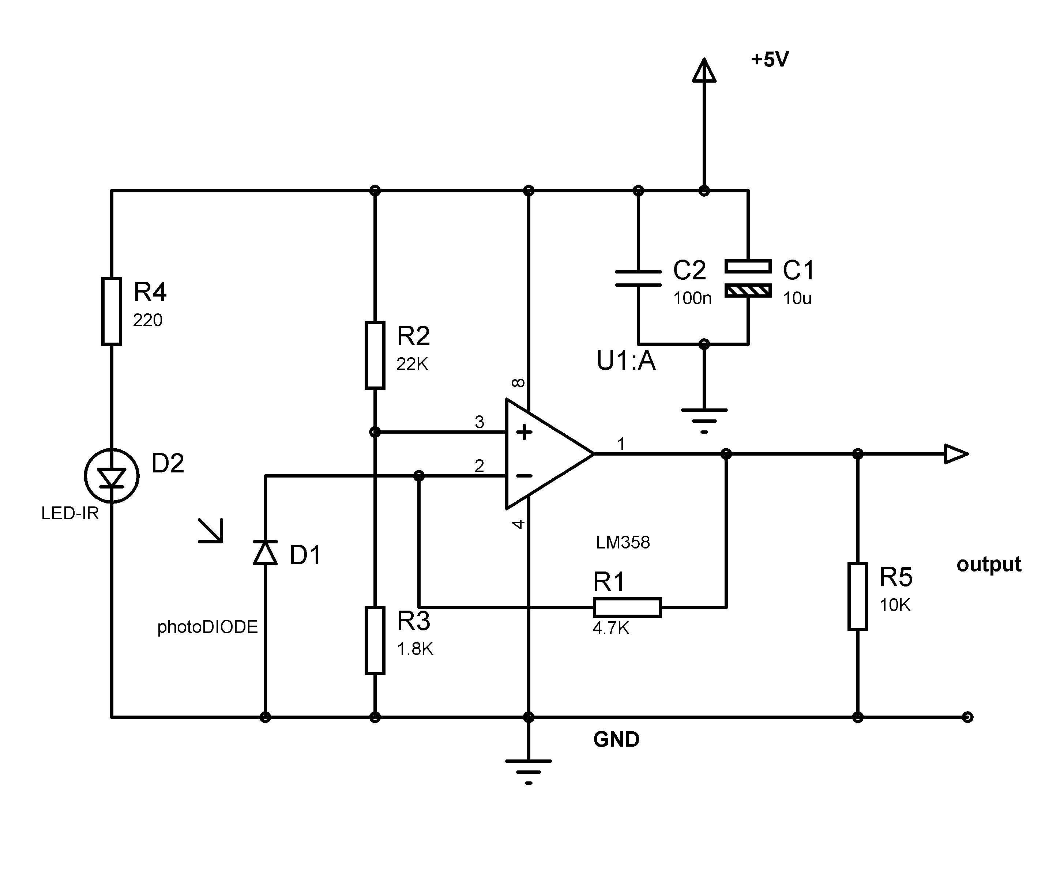
electroparts/ir sensor with led/ir sensor with capacitor.jpg
