nasser1245/Imona-Stand-Charger/electroparts/PhonePresent/Project Outputs for PhonePresent/PhonePresent-oldversion.xlsx

Comment | Description | Designator | Quantity
Cap | خازن 100nf پکیج 0805 | C1 | 1, SMD
LED1 | ال ای دی 3mm رنگ سبز | D1 | 1, DIP
ir1 | فرستنده مادون قرمز | I1 | 1, DIP
Header 3H | کانکتور پین گرد رایت، قسمت اریب به سمت سیگنال خروجی قرار میگیرد | P1 | 1, DIP
Photo NPN | گیرنده مادون قرمز که پایه هایش به طور عکس مونتاژ می شود | Q1 | 1, DIP
220 | مقاومت 220، پکیج 0805 | R1, R4 | 2, SMD
10K | مقاومت 10 کیلو، پکیج 0805 | R2 | 1, SMD
1K | مقاومت 1 کیلو، پکیج 0805 | R3 | 1, SMD
