nasser1245/Imona-Stand-Charger/electroparts/shelfControl/Project Outputs for shelfControl/shelfControl 5V.xlsx

Comment | Description | Designator | Quantity
R100 | مقاومت 100 اهم | R1, R3, R4, R7, R8, R12, R15, R20, R24 | 9
R430 | مقاومت 430 اهم | R2, R5, R6, R9, R10, R13, R17, R22, R26 | 9
R4k7 | مقاومت 4.7 کیلو اهم | R11, R16, R19, R23 | 4
R2k2 | مقاومت 2.2 کیلو اهم | R14, R18, R21, R25 | 4
ترانزیستور PHD45N03، پکیج TO-252 | ماسفت N-Channel | M1, M2, Q1, Q2, Q3, Q4, Q6, Q9, Q10 | 9
s9018 | ماسفت N-Channel، ولتاژ سنسورها را قطع و وصل می کند. | Q5, Q8, Q17, Q11 | 3
AMS1117-3.3 | رگولاتور 5 ولت به 3.3 ولت برای LED ها | Reg1, Reg2 | 2
AMS1117-2.5 | رگولاتور 5 ولت به 2.5 ولت برای LED ها | Reg3 | 1
خازن الکترولیت 10uf، قطر 4mm | طرف منفی به سمت بالا لحیم می شود. | C1, C4, C6 | 3
خازن الکترولیت 100uf، قطر 6.3mm | طرف منفی به سمت بالا لحیم می شود. | C2, C3, C5 | 3
دیود SM330 پکیج SMA، جریان 3 آمپر، 30 ولت | طرف منفی (خط دیود) در تمامی حالات به سمت بالا مونتاژ می شود. | D1, D2, D3, D4, D5, D6 | 6
کانکتور پاور 2 پین، قفل دار، مدل VH | باید به صورتی مونتاژ شود که سمت راست از پشت منفی و سمت چپ از پشت مثبت باشد. (توضیح در ادامه) | J1, J2, J3, J4, J5, J6, J7, J8, J9, J10, J11, J12 | 10
پین گرد 6 پین | برای سیگنال های کنترلی سنسور ها و LED ها. | P1 | 1
پین گرد 7 پین | سیگنال کنترلی شارژر ها، موتور، جریان سنج و فن | P2, P3, P4, P6 | 1
پین گرد 4 پین | خروجی shelf control به برد divisor | P5, P7 | 1
پین گرد 3 پین | خروجی پاور به سنسورها و ورودی سیگنال از سنسورها | P8, P9, P10 | 4
