nasser1245/Imona-Stand-Charger/electroparts/shelfControl/Project Outputs for shelfControl/shelfControl.xlsx

Comment | Description | Designator | Footprint | LibRef | Quantity
4mm Electrolytic-10nf | Electrolytic capacitor SMD 10 آµF 16 V 20 % _أک x L_ 4 mm x 5.8 mm Panasonic EEEFP1C100AR 1 pc_s_ | C1, C4, C6 | *CAP_EEE-FP1C100AR | EEE-FP1C100AR | 3
100uf | SVPC Series 16 V 100 uF أک 6.3 x 5.9 mm Surface Mount Polymer Aluminum Capacitor | C2, C3, C5 | *CAPAE0607X600N_16SVPC100M(Primary) | 16SVPC100M | 3
SM330A | SCHOTTKY RECTIFIER 2A; Voltage Vrrm: 60V; Diode Case Style: DO-214AC; Case Style: DO-214AC | D1, D2, D3, D4, D5, D6 | *DIOM5227X270N_S1M(Primary) | STPS2L60A | 6
6-1123723-2 | 3.96 EP HDR ASSY 2P_GREEN_ | J1, J2, J3, J4, J5, J6, J7, J8, J10, J12 | *TE_6-1123723-2 | 6-1123723-2 | 10
ACS712Measure | 3.96 EP HDR ASSY 2P_GREEN_ | J9, J11 | *TE_6-1123723-2 | 6-1123723-2 | 2
PHD45N03 | P-Channel 40 V 10.6 mOhm OptiMOSآ®-P2 Power-Transistor -PG-TO-252-3 | M1, M2, Q1, Q2, Q3, Q4, Q6, Q9, Q10 | *DPAK228P998X235-3N | IPD50P04P4L-11 | 9
Header 10 | Header, 10-Pin | P1 | HDR1X10 | Header 10 | 1
Header 2 | Header, 2-Pin | P2, P3, P4, P6 | HDR1X2 | Header 2 | 4
Header 4 | Header, 4-Pin | P5, P7 | HDR1X4 | Header 4 | 2
Header 3 | Header, 3-Pin | P8, P9, P10 | HDR1X3 | Header 3 | 3
s9018 | P-Channel MOSFET | Q5, Q8, Q17 | SOT-23_N | MOSFET-P | 3
s9012 | P-Channel MOSFET | Q11 | SOT-23_N | MOSFET-P | 1
R100 | Resistor | R1, R3, R4, R7, R8, R12, R15, R20, R24 | 6-0805_L | Res1 | 9
R430 | Resistor | R2, R5, R6, R9, R10, R13, R17, R22, R26 | 6-0805_L | Res1 | 9
R4k7 | Resistor | R11, R16, R19, R23 | 6-0805_L | Res1 | 4
R2k2 | Resistor | R14, R18, R21, R25 | 6-0805_L | Res1 | 4
AMS1117-3.3 | P-Channel MOSFET, Externally Terminated Substrate | Reg1, Reg2 | SOT223_N | MOSFET-P4 | 2
AMS1117-2.5 | P-Channel MOSFET, Externally Terminated Substrate | Reg3 | SOT223_N | MOSFET-P4 | 1
