nasser1245/Imona-Stand-Charger/electroparts/fast charger/Project Outputs for FastCharge/FastCharge1.xlsx

Comment | Description | Designator | Quantity
470uF | فاصله پین ها 5 | C1, C2 | 2, DIP
100nF | پکیج 0805 | C3, C4, C5, C6 | 4, SMD
S1M | دیود سه آمپر پکیج SMA | D1 | 1, SMD
کانکتور پاور | فاصله پایه ها 3.96 | J1 | 1, DIP
33uH | سلف 33 میکروهانری که از پشت مونتاژ می شود | L1 | 1, SMD
2k2 | مقاومت 2.2 کیلو اهم 1 درصد | R1, R5 | 2, SMD
33k | مقاومت 33 کیلو اهم 1 درصد | R2 | 1, SMD
1k | مقاومت 1 کیلو اهم 1 درصد | R3 | 1, SMD
100k | مقاومت 100 کیلو اهم 1 درصد | R4 | 1, SMD
38k3 | مقاومت 38.3 کیلو اهم 1 درصد | R6 | 1, SMD
10k | مقاومت 10 کیلو اهم 2 درصد | R7, R8 | 2, SMD
LM2596-ADJ | رگولاتور LM2596 قابل تنظیم | U1 | 1, DIP
CHY103 | آی سی chy103 که با ولتاژ های ورودی مشخص ولتاژ خروجی را تغییر می دهد. | U2 | 1, SMD
USB | کانکتور usb-a نوع رایت | USB-Type-A | 1, DIP
