nasser1245/Imona-Stand-Charger/electroparts/MicroSwitch/Project Outputs for MicroSwitch/MicroSwitch.xlsx

Comment | Description | Designator | Quantity
MicroSwitch | میکرو سوییچ، پین وسطی خروجی است، | J1 | 1, DIP
Header 3 | کانکتور پین گرد، رایت | P1 | 1, DIP
10K | مقاومت 10کیلو، پکیج 0805 | R1 | 1, SMD
