nasser1245/Imona-Stand-Charger/electroparts/SchmitOpto/Project Outputs for SchmitOpto/SchmitOpto.xlsx

Comment | Description | Designator | Quantity
Cap | خازن 100nf، پکیج 0805 | C1 | 1, SMD
ITR9606 | اپتوکانتر فرستنده گیرنده مادون قرمز که روی پشت برد مونتاژ می شود | I1 | 1, DIP
Header 3H | کانکتور پین گرد رایت | P1 | 1, DIP
220 | مقاومت 220 اهم | R1 | 1, SMD
10K | مقاومت 10 کیلو اهم | R2 | 1, SMD
1K | مقاومت یک کیلو اهم | R3 | 1, SMD
