nasser1245/Imona-Stand-Charger/models/stand version-6mm/stand version.SLDASM

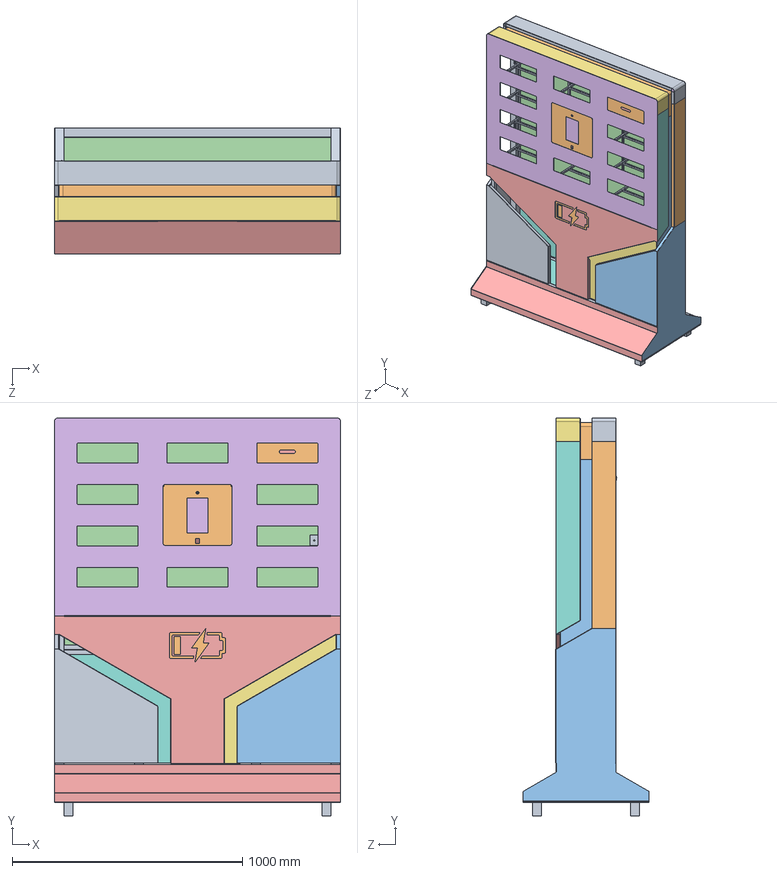
[picture p61: CAD file, 2024-04-19]
models/stand version-6mm/stand version.SLDASM
1244.0 x 1728.5 x 548.6 mm
bottom housing
door
door shaft
Sensor, IR, Arduino Type, Flying Fish MH-B
ir sensor plex1
ir sensor plex2
ir top plexi
spacer6mm
spacer x 4
wire locker x 2
behind led holder
lens x 3
side bearing x 2
bearing lock x 2
top
middle wall
plastic pipe
plastic washer x 2
pan head cross recess screw_iso
catch
lock indicator
M5 nut
e-external retaining ring_ai
side proximity sensor
top cover
spacer sensor x 2
casted main gearbox
spur-small-c
wormgear-main-c
worm-shaft-c
spur1-c
spur shaft-c
optocounter x 2
plexencoderfinal1
rivet nut x 4
plexi keeper
f plexi
b plexi
led heatsink
stack coupling milled
spring pin
bearing out washer x 2
lock coupling machined
spring end holder
adxl345
DeadLock
D2F-01L1
board holder top
profile x 99
top cover big R
side cover
front bottom surface
front top surface
top surface
side surface
side surface back
side surface bottom
edge wrapper
front cover
lock
