nasser1245/Imona-Stand-Charger/models/StandV2/profiles/Width main thick bottom front.SLDPRT

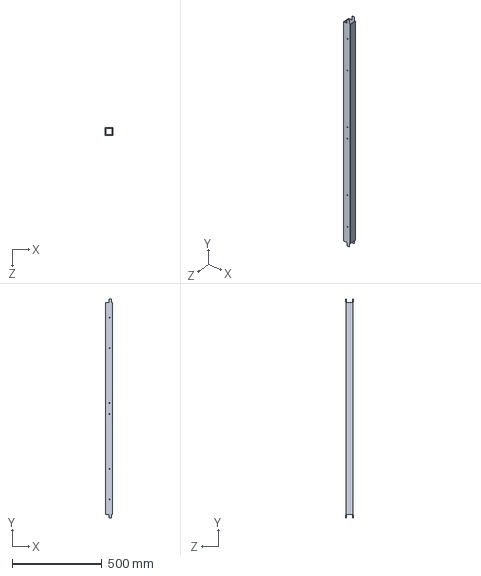
[picture p62: CAD file, 2024-04-19]
models/StandV2/profiles/Width main thick bottom front.SLDPRT
40.0 x 1220.0 x 40.0 mm
