nasser1245/Imona-Stand-Charger/models/StandV2/profiles/height main thick front topR.SLDPRT

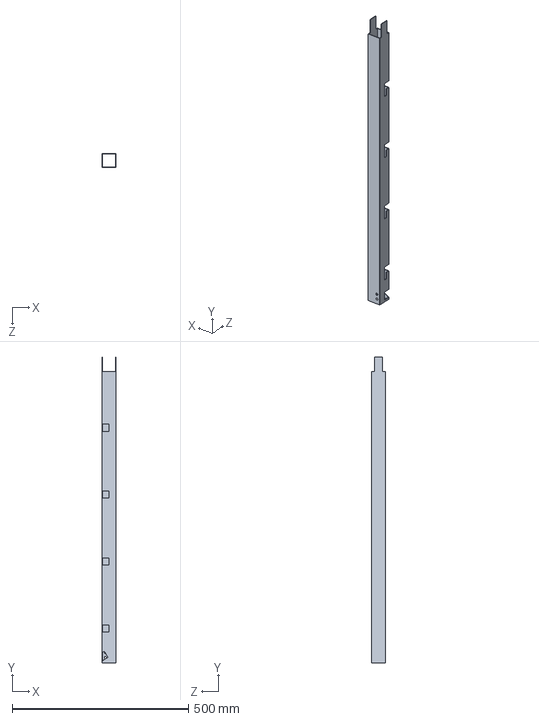
[picture p64: CAD file, 2024-04-19]
models/StandV2/profiles/height main thick front topR.SLDPRT
40.0 x 869.0 x 40.0 mm
