nasser1245/Imona-Stand-Charger/models/stand version/stand version- chassis.SLDASM

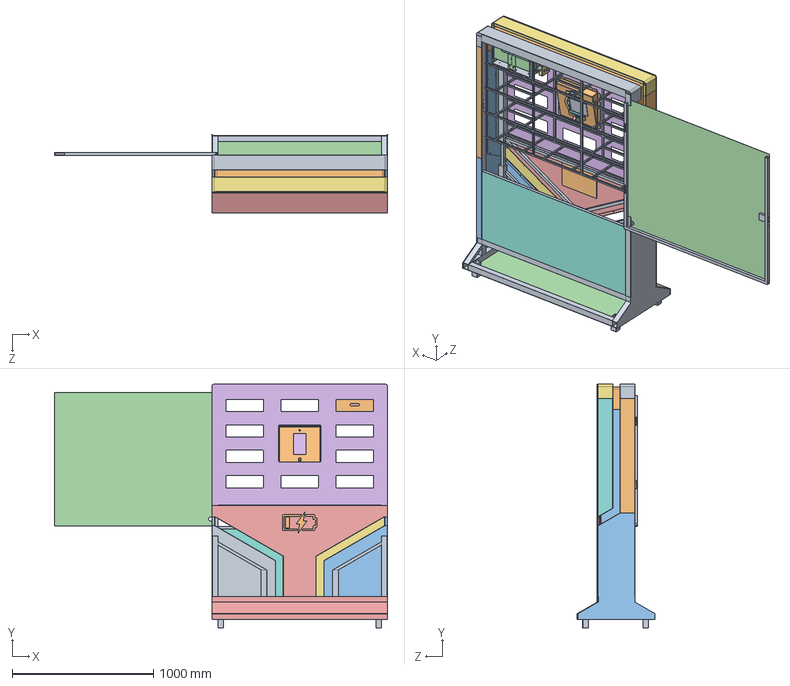
[picture p65: CAD file, 2024-04-19]
models/stand version/stand version- chassis.SLDASM
2360.0 x 1728.5 x 553.7 mm
profile x 99
User Library-Bisagra oculta-1_Pasador fijo x 2
User Library-Bisagra oculta-1_Cuerpo bisagra oculta x 2
User Library-Bisagra oculta-1_Pasador movil x 2
User Library-Bisagra oculta-1_Pieza accionamiento bisagra x 16
User Library-Bisagra oculta-1_Pasador central bisagra
lock
infrastructure surface simple
camera
fingerprint mount
fingerprint
innolux lcd
lcd frame
back belt x 2
boards pad
