nasser1245/Imona-Stand-Charger/models/StandV2/profiles/Height main lock.SLDPRT

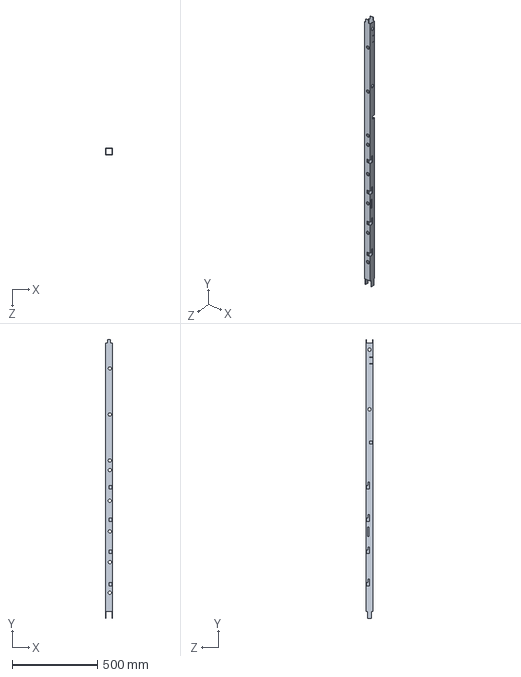
[picture p66: CAD file, 2024-04-19]
models/StandV2/profiles/Height main lock.SLDPRT
40.0 x 1637.5 x 40.0 mm
