nasser1245/Imona-Stand-Charger/models/StandV2/profiles/height main thick front top.SLDPRT

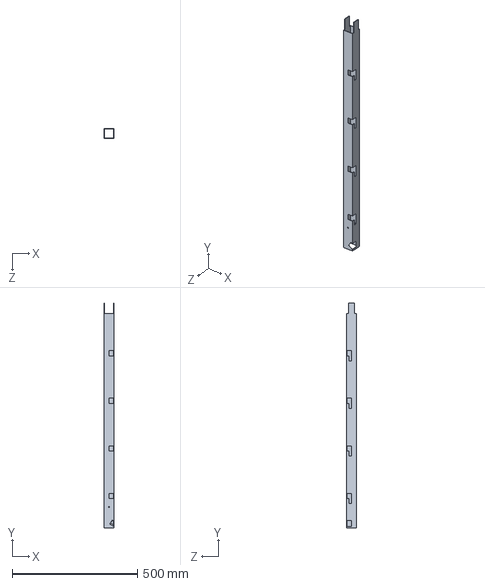
[picture p67: CAD file, 2024-04-19]
models/StandV2/profiles/height main thick front top.SLDPRT
40.0 x 899.0 x 40.0 mm
