nasser1245/Imona-Stand-Charger/models/StandV2/profiles/Height main thick front bottom right.SLDPRT

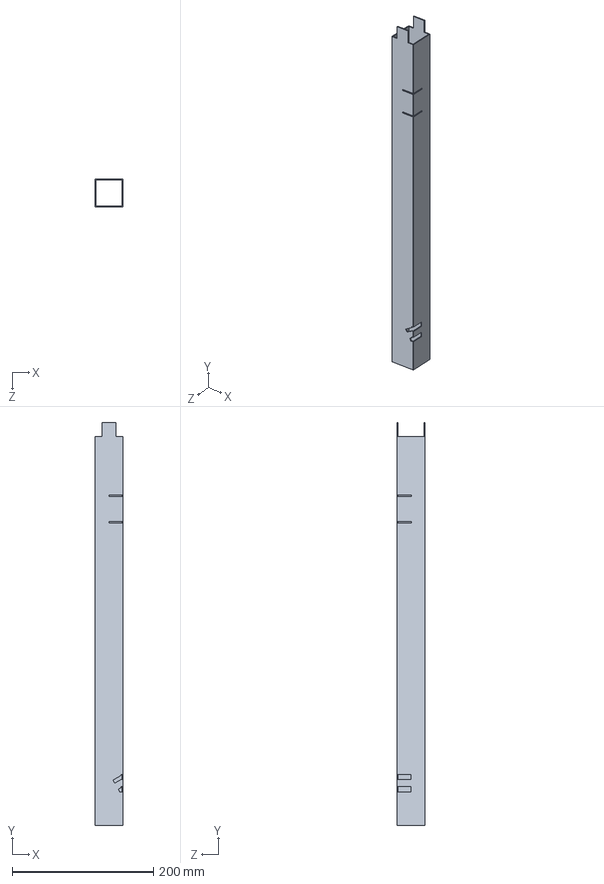
[picture p68: CAD file, 2024-04-19]
models/StandV2/profiles/Height main thick front bottom right.SLDPRT
40.0 x 571.0 x 40.0 mm
