nasser1245/Imona-Stand-Charger/models/wall version/wall version.SLDASM

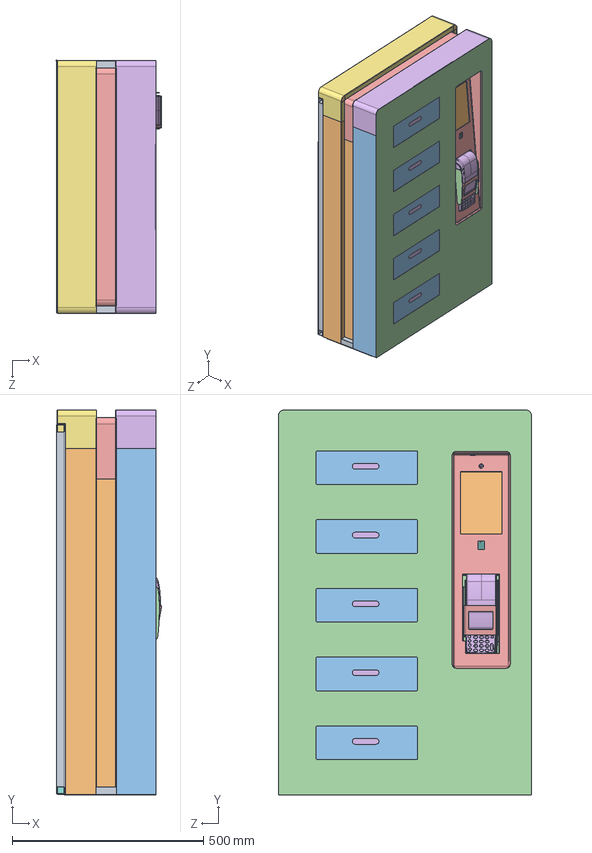
[picture p69: CAD file, 2024-04-19]
models/wall version/wall version.SLDASM
276.1 x 1007.7 x 663.4 mm
profile wall x 47
bottom housing x 5
door x 5
door shaft x 5
Sensor, IR, Arduino Type, Flying Fish MH-B x 5
ir sensor plex1 x 5
ir sensor plex2 x 5
ir top plexi x 5
spacer6mm x 5
spacer x 20
wire locker x 10
behind led holder x 5
lens x 15
side bearing x 10
bearing lock x 10
top x 6
middle wall x 6
plastic pipe x 6
plastic washer x 12
pan head cross recess screw_iso x 6
catch x 6
lock indicator x 6
M5 nut x 6
e-external retaining ring_ai x 6
side proximity sensor x 6
top cover x 5
spacer sensor x 10
casted main gearbox x 5
spur-small-c x 5
wormgear-main-c x 5
worm-shaft-c x 5
spur1-c x 5
spur shaft-c x 5
optocounter x 10
plexencoderfinal1 x 5
rivet nut x 20
plexi keeper x 5
f plexi x 5
b plexi x 5
led heatsink x 5
stack coupling milled x 5
spring pin x 5
bearing out washer x 10
lock coupling machined x 5
spring end holder x 5
adxl345 x 5
DeadLock x 5
D2F-01L1 x 5
board holder top x 5
side cover-w x 2
bottom cover-w
back cover
top cover big-w
top surface front
top surface back-w
side surface back-W
side surface front-W
edge wrapper-w x 3
User Library-Bisagra oculta-1_Pasador fijo x 2
User Library-Bisagra oculta-1_Cuerpo bisagra oculta x 2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
