nasser1245/Imona-Stand-Charger/library parts/POS Solenoid Lock/Solenoid Lock.SLDASM

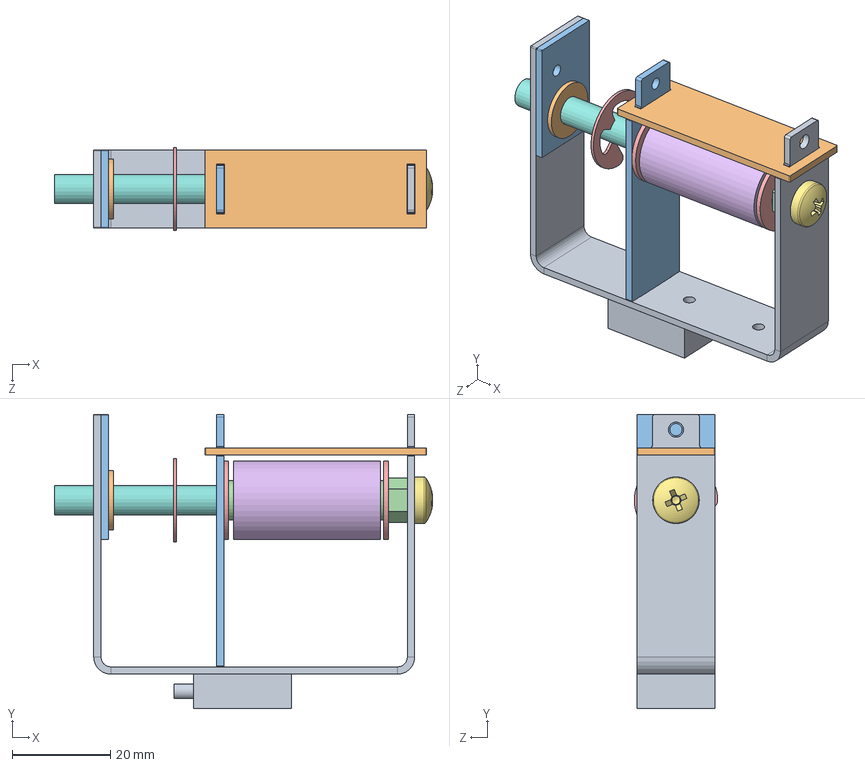
[picture p70: CAD file, 2024-04-19]
library parts/POS Solenoid Lock/Solenoid Lock.SLDASM
77.1 x 60.0 x 17.0 mm
top
middle wall
plastic pipe
plastic washer x 2
winding
pan head cross recess screw_iso
catch
backspring plastic
catch bush
M5 nut
e-external retaining ring_ai
