nasser1245/Imona-Stand-Charger/models/table version/table version.SLDASM

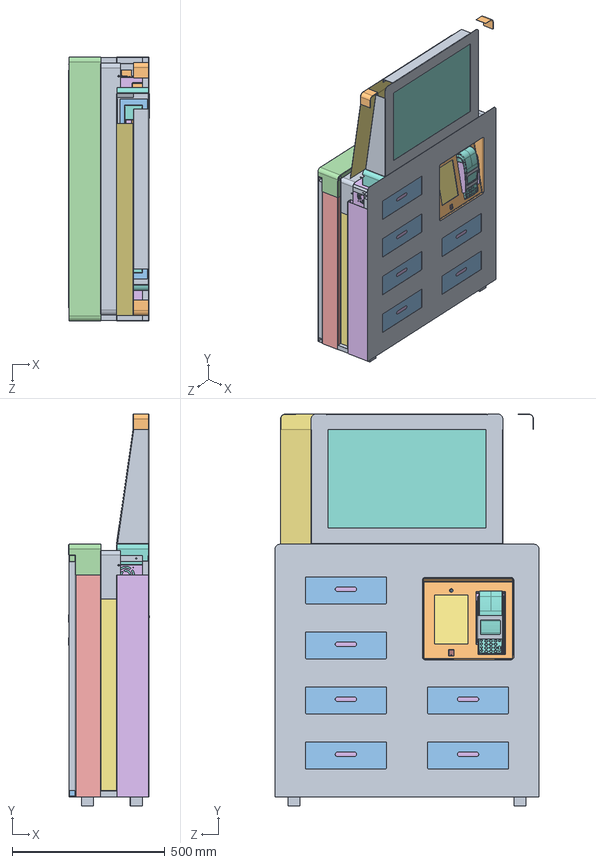
[picture p71: CAD file, 2024-04-19]
models/table version/table version.SLDASM
264.6 x 1282.7 x 863.4 mm
profile table x 53
bottom housing x 6
door x 6
door shaft x 6
Sensor, IR, Arduino Type, Flying Fish MH-B x 6
ir sensor plex1 x 6
ir sensor plex2 x 6
ir top plexi x 6
spacer6mm x 6
spacer x 24
wire locker x 12
behind led holder x 6
lens x 18
side bearing x 12
bearing lock x 12
top x 7
middle wall x 7
plastic pipe x 7
plastic washer x 14
pan head cross recess screw_iso x 7
catch x 7
lock indicator x 7
M5 nut x 7
e-external retaining ring_ai x 7
side proximity sensor x 7
top cover x 6
spacer sensor x 12
casted main gearbox x 6
spur-small-c x 6
wormgear-main-c x 6
worm-shaft-c x 6
spur1-c x 6
spur shaft-c x 6
optocounter x 12
plexencoderfinal1 x 6
rivet nut x 24
plexi keeper x 6
f plexi x 6
b plexi x 6
led heatsink x 6
stack coupling milled x 6
spring pin x 6
bearing out washer x 12
lock coupling machined x 6
spring end holder x 6
adxl345 x 6
DeadLock x 6
D2F-01L1 x 6
board holder top x 6
bottom cover-w
back cover
User Library-Bisagra oculta-1_Pasador fijo x 2
User Library-Bisagra oculta-1_Cuerpo bisagra oculta x 2
User Library-Bisagra oculta-1_Pasador movil x 2
User Library-Bisagra oculta-1_Pieza accionamiento bisagra x 16
User Library-Bisagra oculta-1_Pasador central bisagra
top cover big-T
side surface front-T
side surface back-T
top surface back-T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
