nasser1245/Imona-Stand-Charger/models/stand version/stand version.SLDASM

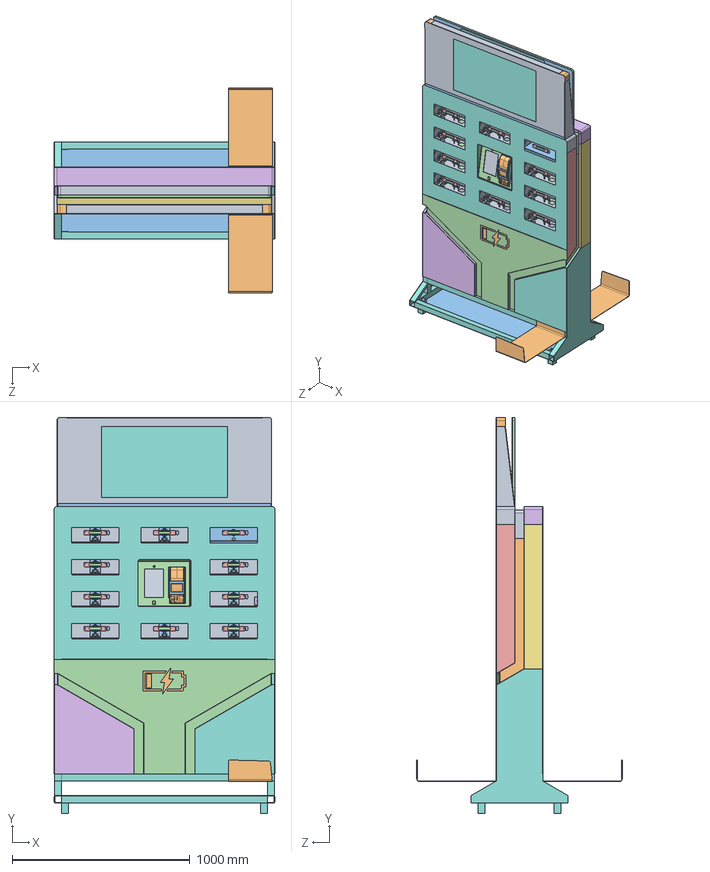
[picture p72: CAD file, 2024-04-19]
models/stand version/stand version.SLDASM
1244.0 x 2230.5 x 1156.0 mm
bottom housing x 10
door shaft x 10
Sensor, IR, Arduino Type, Flying Fish MH-B x 10
ir sensor plex1 x 10
ir sensor plex2 x 10
ir top plexi x 10
spacer6mm x 10
spacer x 40
wire locker x 20
behind led holder x 10
lens x 30
side bearing x 20
bearing lock x 20
top x 11
middle wall x 11
plastic pipe x 11
plastic washer x 22
pan head cross recess screw_iso x 11
catch x 11
lock indicator x 11
M5 nut x 11
e-external retaining ring_ai x 11
side proximity sensor x 11
top cover x 10
spacer sensor x 20
spur-small-c x 10
wormgear-main-c x 10
worm-main-c x 10
worm-shaft-c x 10
spur1-c x 10
spur shaft-c x 10
optocounter x 20
plexencoderfinal1 x 10
rivet nut x 40
plexi keeper x 10
f plexi x 10
b plexi x 10
led heatsink x 10
stack coupling milled x 10
spring pin x 10
bearing out washer x 20
lock coupling machined x 10
spring end holder x 10
adxl345 x 10
DeadLock x 10
D2F-01L1 x 10
board holder top x 10
profile x 100
top cover big R
side cover x 2
bottom cover
front bottom surface
side surface
top surface back
side surface back x 2
side surface bottom
back cover
bottom surface x 2
edge wrapper x 3
front cover x 2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
