nasser1245/Imona-Stand-Charger/models/StandV2/profiles/Width main thick bottom.SLDPRT

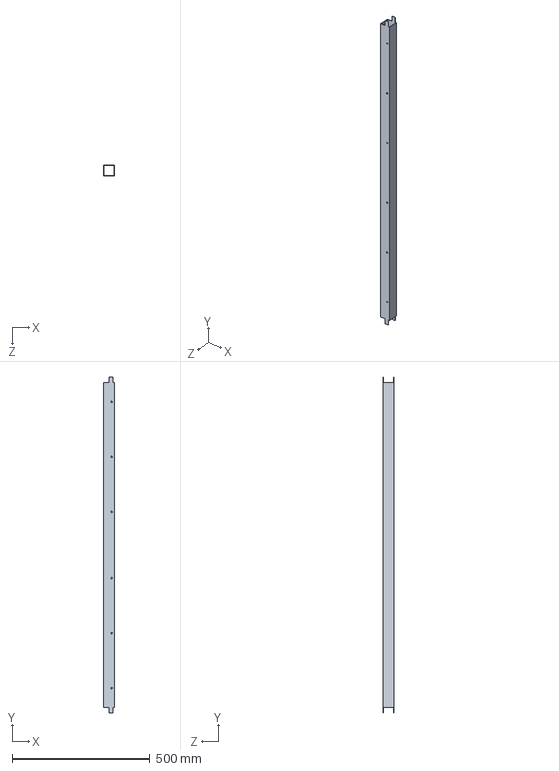
[picture p73: CAD file, 2024-04-19]
models/StandV2/profiles/Width main thick bottom.SLDPRT
40.0 x 1220.0 x 40.0 mm
