nasser1245/Imona-Stand-Charger/models/StandV2/profiles/width main thick.SLDPRT

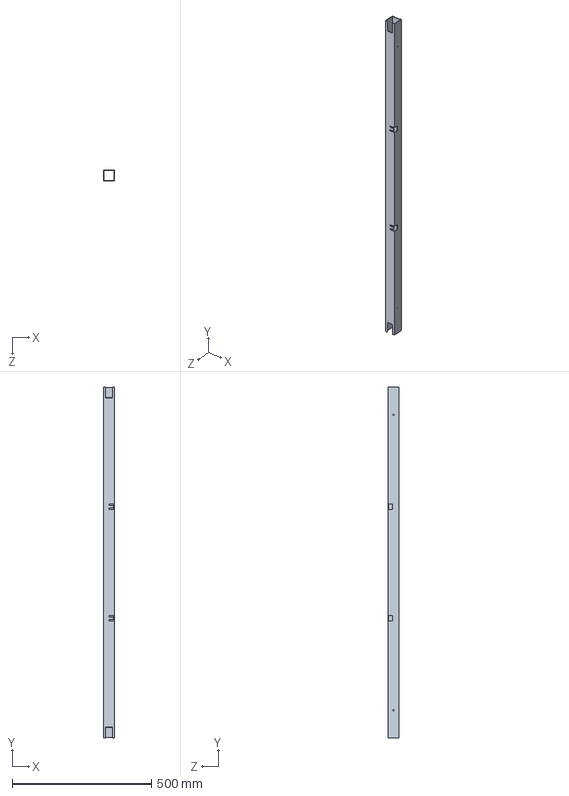
[picture p74: CAD file, 2024-04-19]
models/StandV2/profiles/width main thick.SLDPRT
40.0 x 1260.0 x 40.0 mm
