nasser1245/Imona-Stand-Charger/library parts/POS Solenoid Lock/winding.SLDPRT

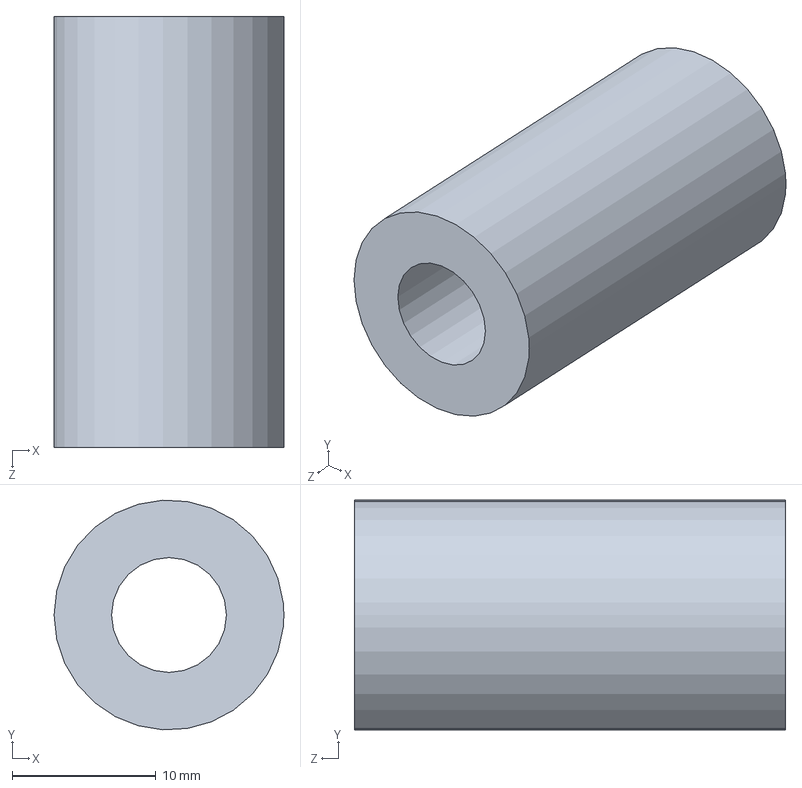
[picture p75: CAD file, 2024-04-19]
library parts/POS Solenoid Lock/winding.SLDPRT
16.0 x 16.0 x 30.0 mm
