nasser1245/Imona-Stand-Charger/library parts/side proximity sensor-straight.SLDPRT

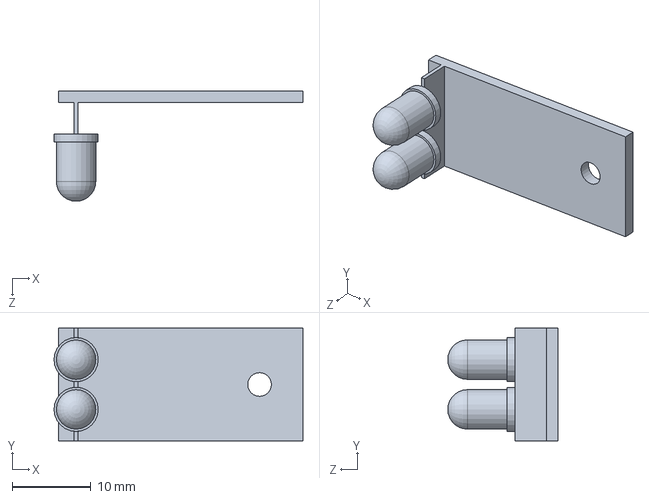
[picture p76: CAD file, 2024-04-19]
library parts/side proximity sensor-straight.SLDPRT
31.5 x 14.3 x 14.0 mm
