nasser1245/Imona-Stand-Charger/models/stand version-6mm/bottom cover.SLDPRT

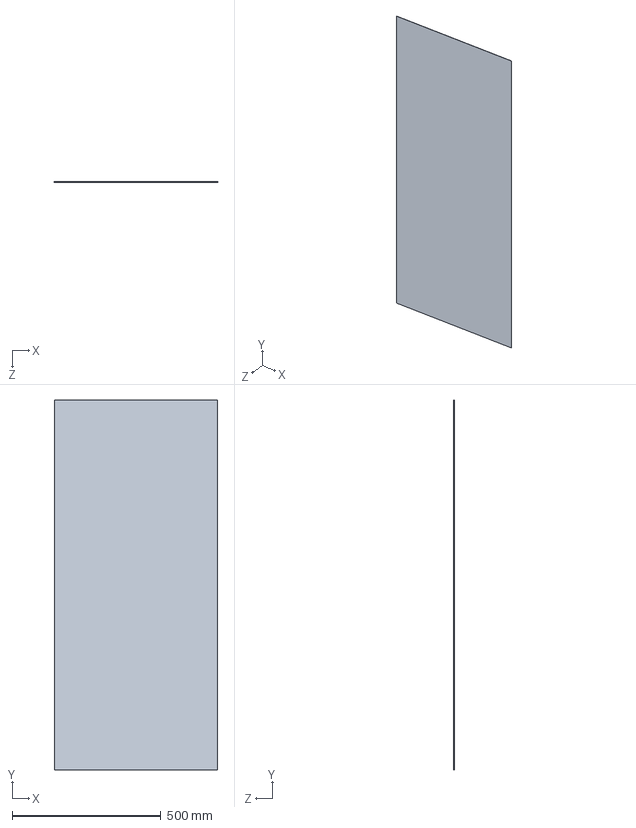
[picture p77: CAD file, 2024-04-19]
models/stand version-6mm/bottom cover.SLDPRT
548.6 x 1243.0 x 1.00 mm
