nasser1245/Imona-Stand-Charger/models/stand version/front cover.SLDPRT

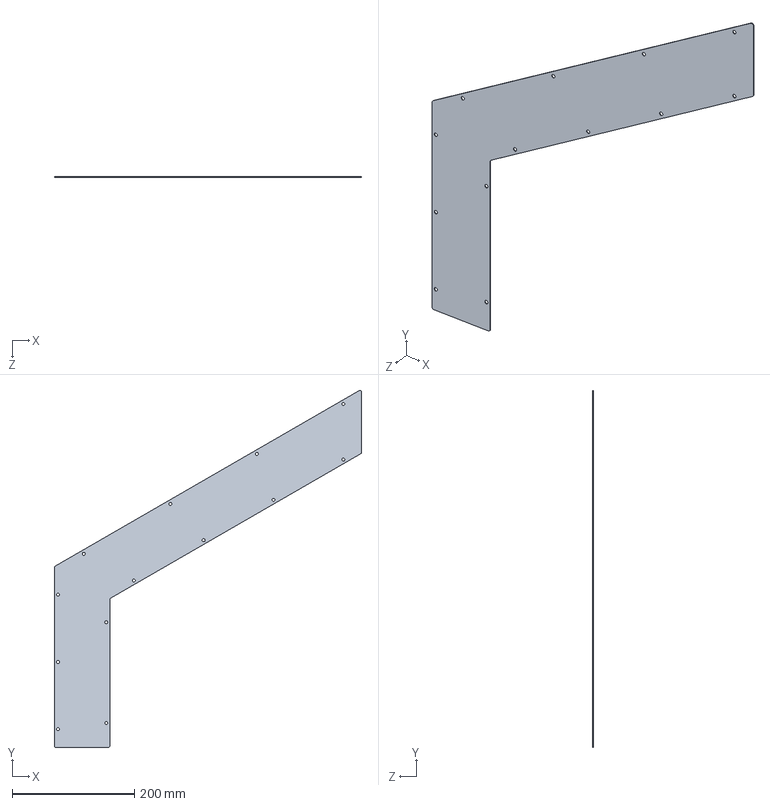
[picture p78: CAD file, 2024-04-19]
models/stand version/front cover.SLDPRT
503.0 x 584.2 x 1.00 mm
