nasser1245/Imona-Stand-Charger/models/StandV2/profiles/below door height.SLDPRT

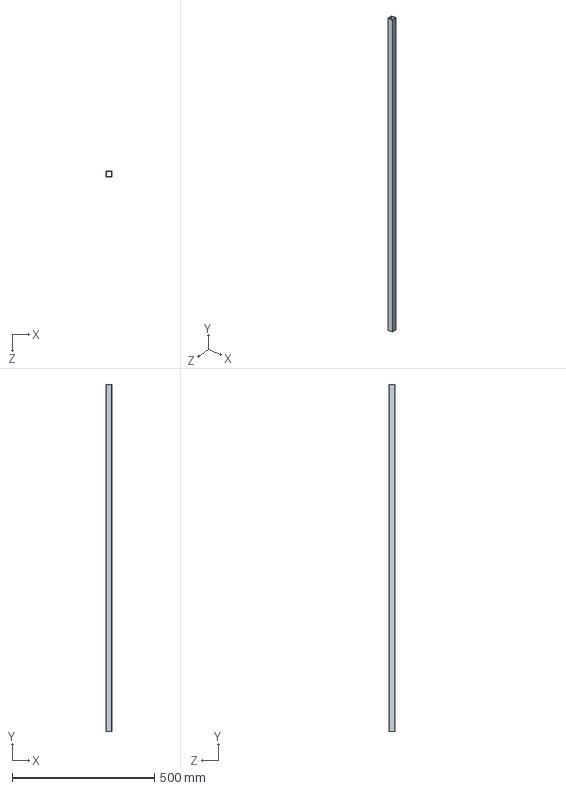
[picture p79: CAD file, 2024-04-19]
models/StandV2/profiles/below door height.SLDPRT
20.0 x 1220.0 x 20.0 mm
