nasser1245/Imona-Stand-Charger/models/StandV2/side wheel support.SLDPRT

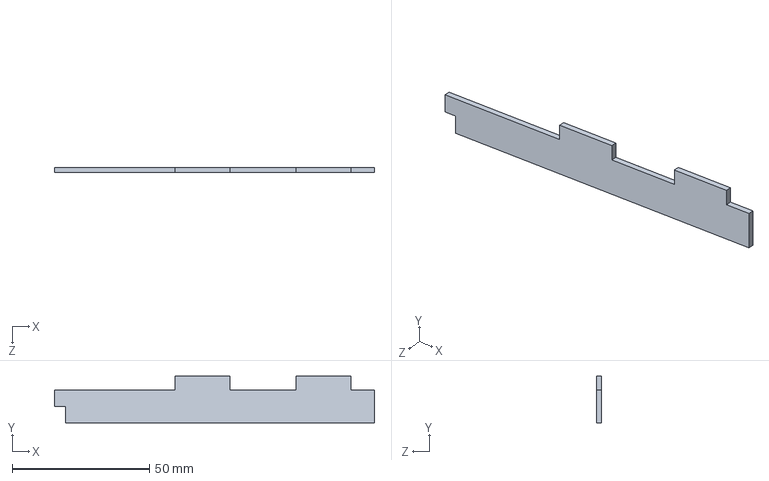
[picture p80: CAD file, 2024-04-19]
models/StandV2/side wheel support.SLDPRT
116.7 x 17.0 x 2.00 mm
