nasser1245/Imona-Stand-Charger/models/table version/side cover-T.SLDPRT

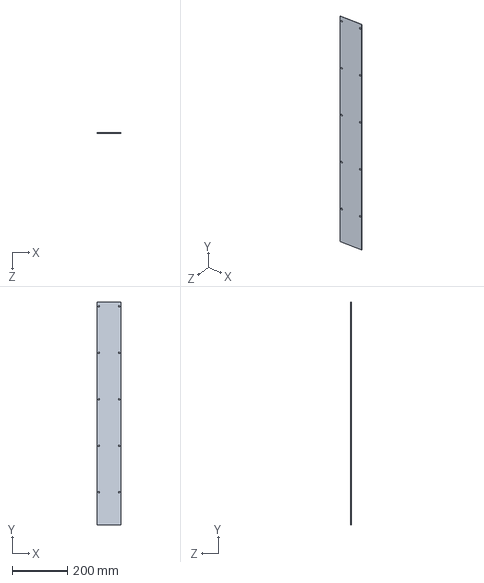
[picture p81: CAD file, 2024-04-19]
models/table version/side cover-T.SLDPRT
85.0 x 806.5 x 0.7 mm
