nasser1245/Imona-Stand-Charger/models/wall version/back cover.SLDPRT

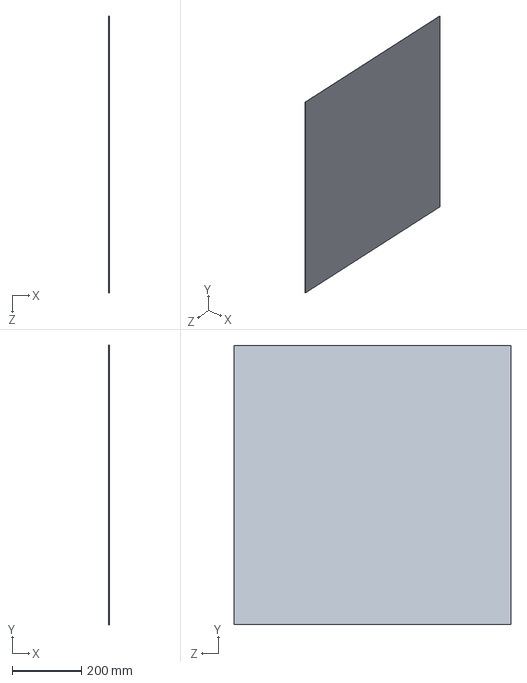
[picture p82: CAD file, 2024-04-19]
models/wall version/back cover.SLDPRT
0.7 x 808.4 x 801.7 mm
