nasser1245/Imona-Stand-Charger/library parts/POS Solenoid Lock/middle wall.SLDPRT

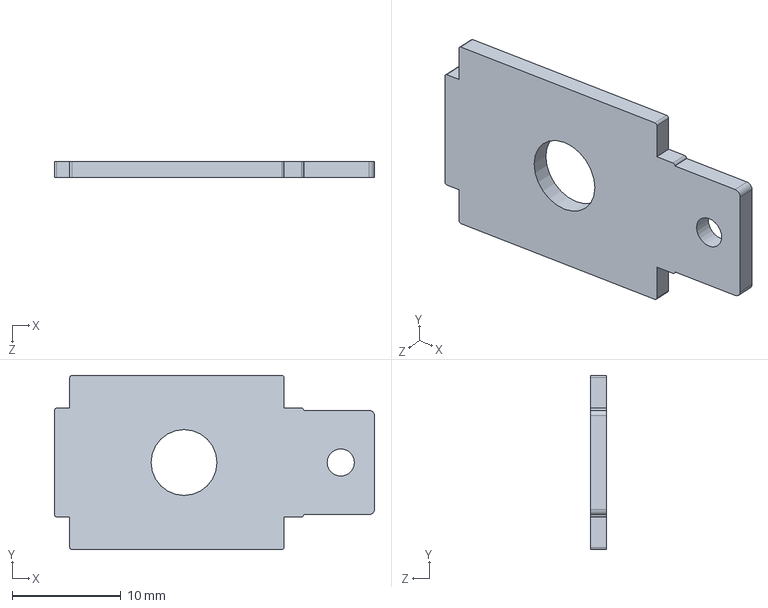
[picture p83: CAD file, 2024-04-19]
library parts/POS Solenoid Lock/middle wall.SLDPRT
29.4 x 16.0 x 1.50 mm
