nasser1245/Imona-Stand-Charger/models/stand version/side surface.SLDPRT

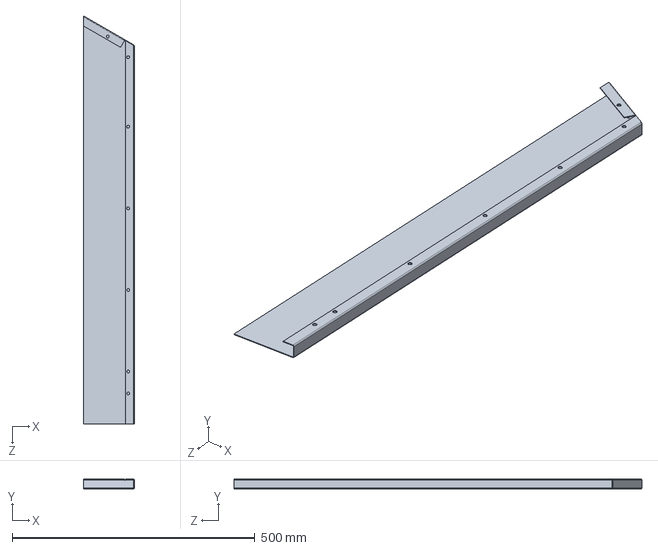
[picture p84: CAD file, 2024-04-19]
models/stand version/side surface.SLDPRT
105.0 x 20.0 x 839.9 mm
