nasser1245/Imona-Stand-Charger/models/StandV2/side surface backRL.SLDPRT

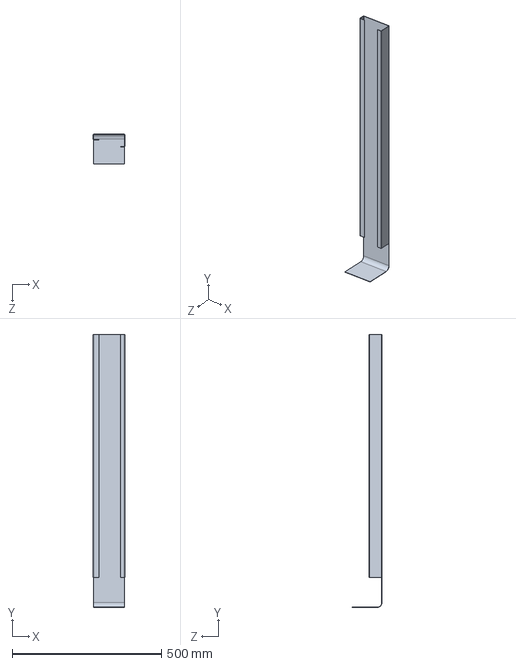
[picture p85: CAD file, 2024-04-19]
models/StandV2/side surface backRL.SLDPRT
106.0 x 914.0 x 100.0 mm
