nasser1245/Imona-Stand-Charger/models/table version/side surface back-T-v2.SLDPRT

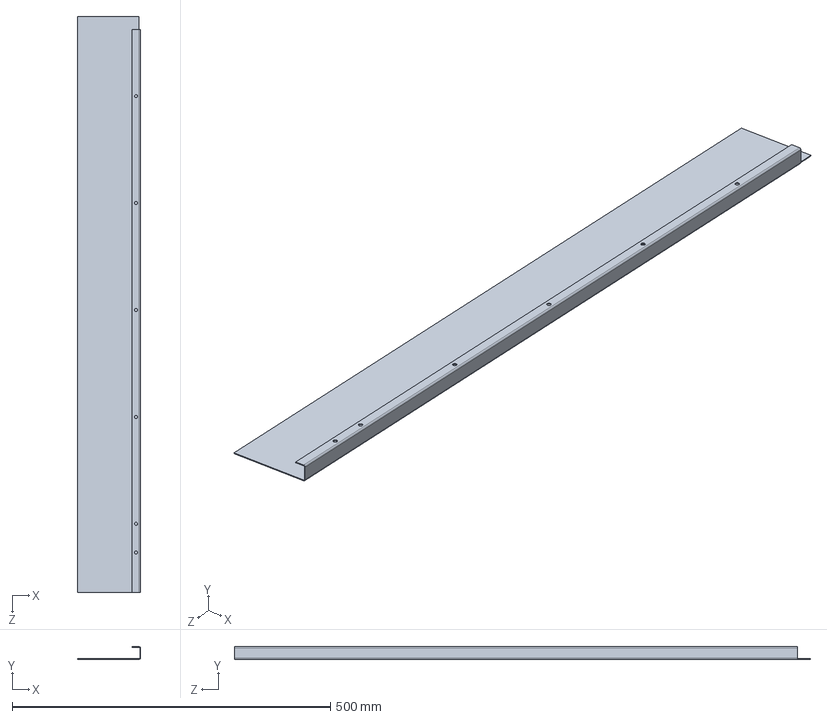
[picture p86: CAD file, 2024-04-19]
models/table version/side surface back-T-v2.SLDPRT
99.0 x 20.0 x 905.2 mm
