nasser1245/Imona-Stand-Charger/models/wall version/side surface front-W-v2.SLDPRT

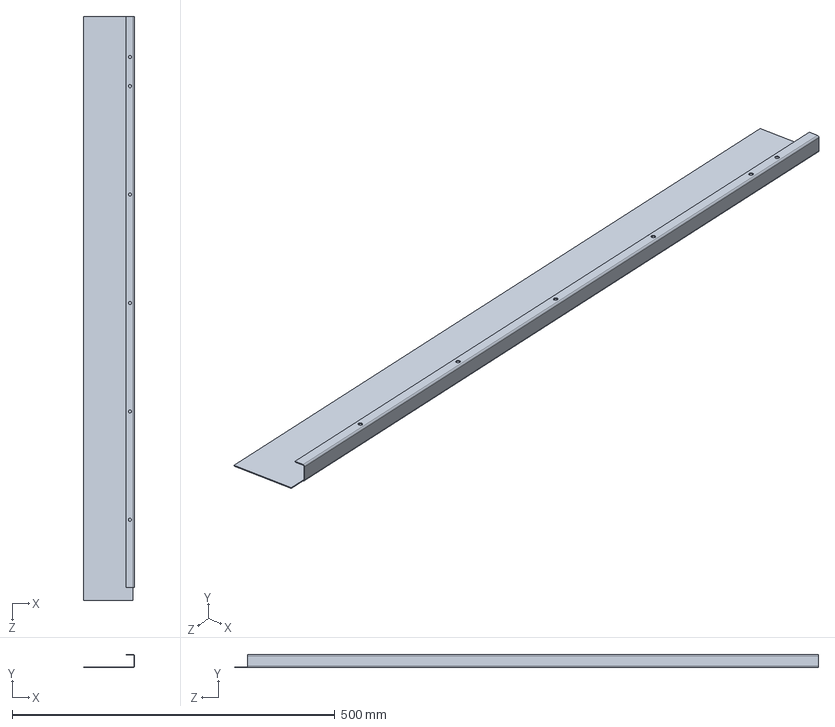
[picture p87: CAD file, 2024-04-19]
models/wall version/side surface front-W-v2.SLDPRT
79.0 x 20.0 x 905.2 mm
