nasser1245/Imona-Stand-Charger/library parts/camera.SLDPRT

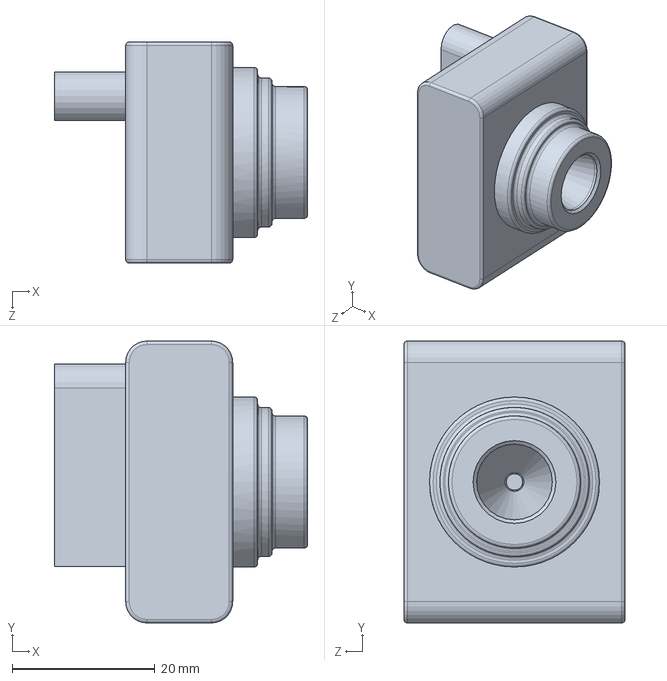
[picture p88: CAD file, 2024-04-19]
library parts/camera.SLDPRT
35.5 x 39.5 x 31.0 mm
