nasser1245/Imona-Stand-Charger/library parts/POS Solenoid Lock/lock indicator.SLDPRT

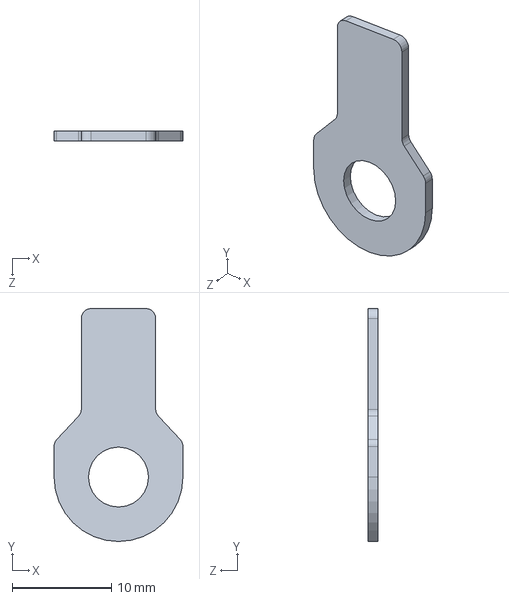
[picture p89: CAD file, 2024-04-19]
library parts/POS Solenoid Lock/lock indicator.SLDPRT
13.0 x 23.5 x 1.00 mm
