nasser1245/Imona-Stand-Charger/models/stand version-6mm/back cover.SLDPRT

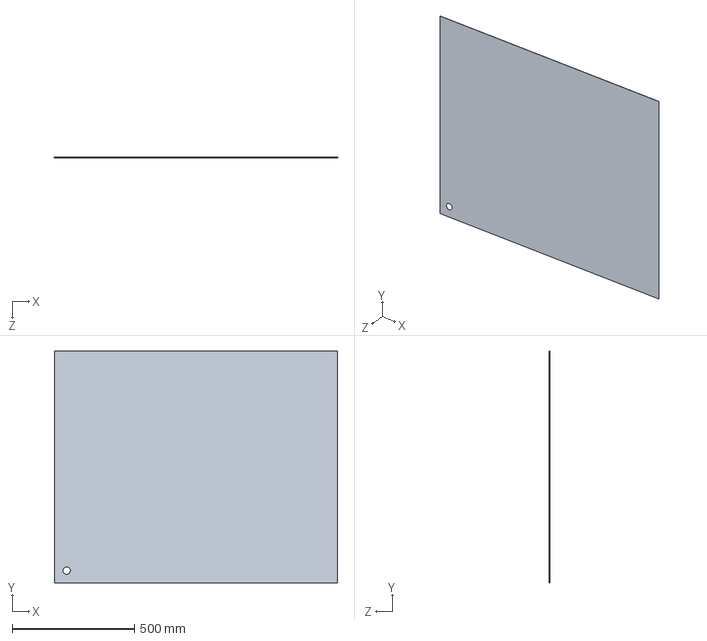
[picture p90: CAD file, 2024-04-19]
models/stand version-6mm/back cover.SLDPRT
1156.0 x 947.0 x 1.00 mm
