nasser1245/Imona-Stand-Charger/models/StandV2/edge side.SLDPRT

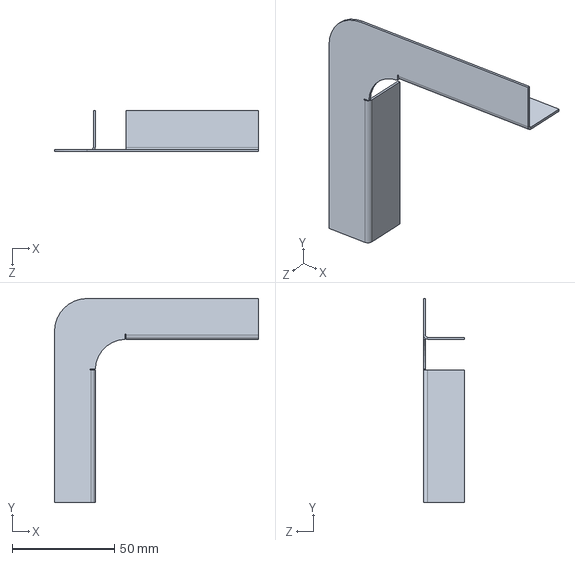
[picture p91: CAD file, 2024-04-19]
models/StandV2/edge side.SLDPRT
100.0 x 100.0 x 20.0 mm
