nasser1245/Imona-Stand-Charger/models/table version/front top surface-T.SLDPRT

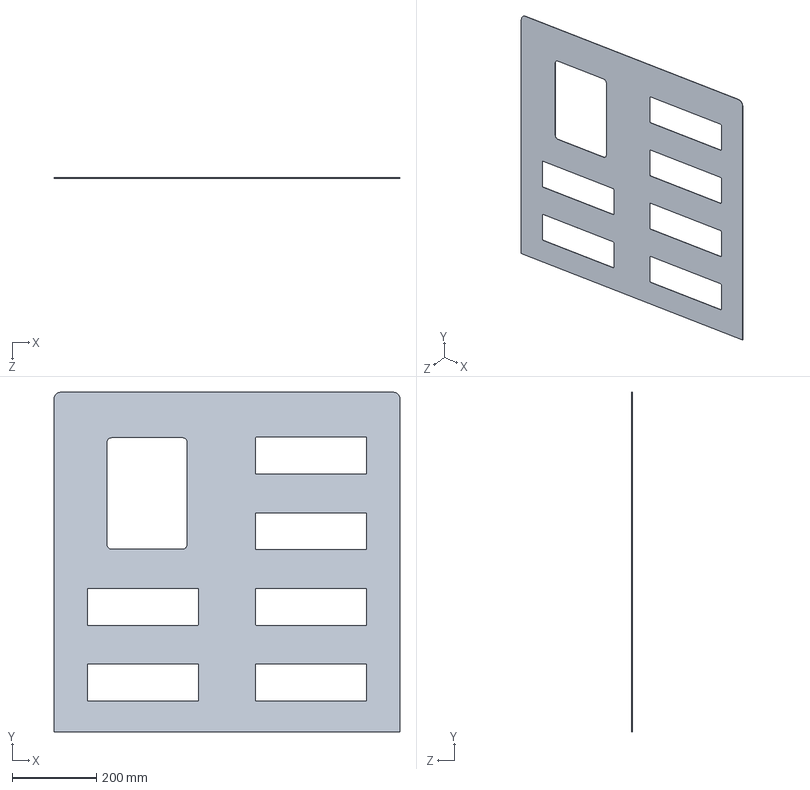
[picture p92: CAD file, 2024-04-19]
models/table version/front top surface-T.SLDPRT
823.4 x 808.4 x 1.00 mm
