nasser1245/Imona-Stand-Charger/models/wall version/top wrapper.SLDPRT

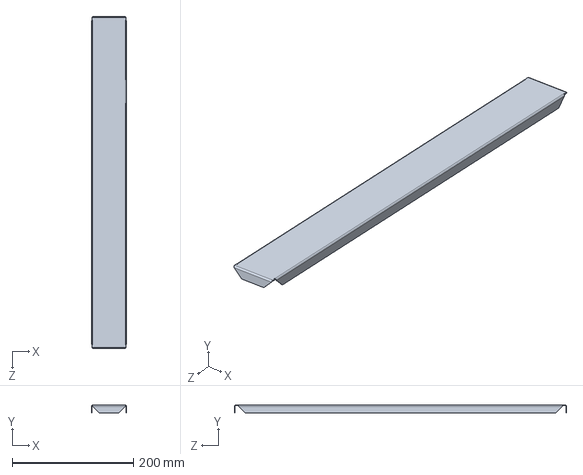
[picture p93: CAD file, 2024-04-19]
models/wall version/top wrapper.SLDPRT
58.0 x 13.0 x 548.0 mm
