nasser1245/Imona-Stand-Charger/library parts/dc motor.sldprt

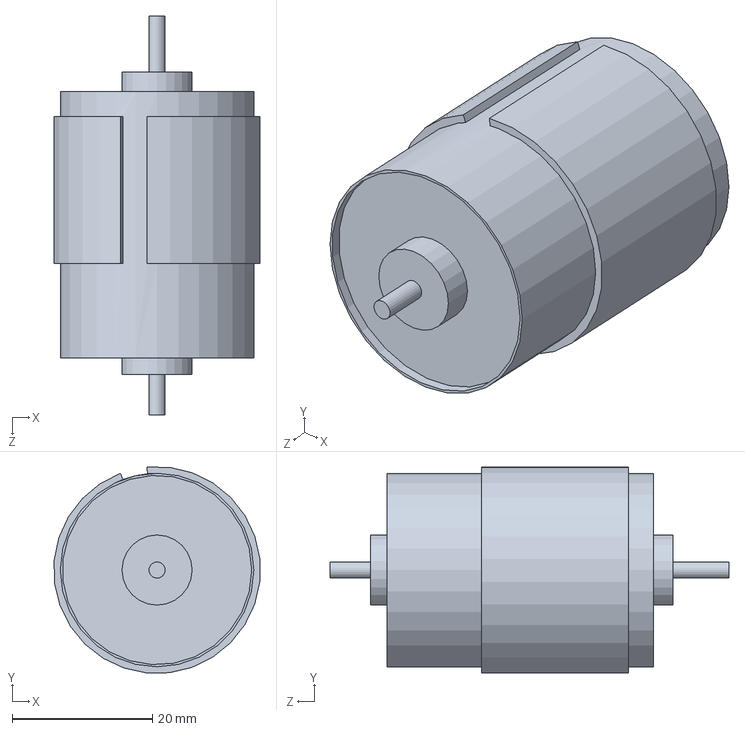
[picture p94: CAD file, 2024-04-19]
library parts/dc motor.sldprt
29.3 x 29.3 x 56.9 mm
