nasser1245/Imona-Stand-Charger/library parts/POS Solenoid Lock/plastic pipe.SLDPRT

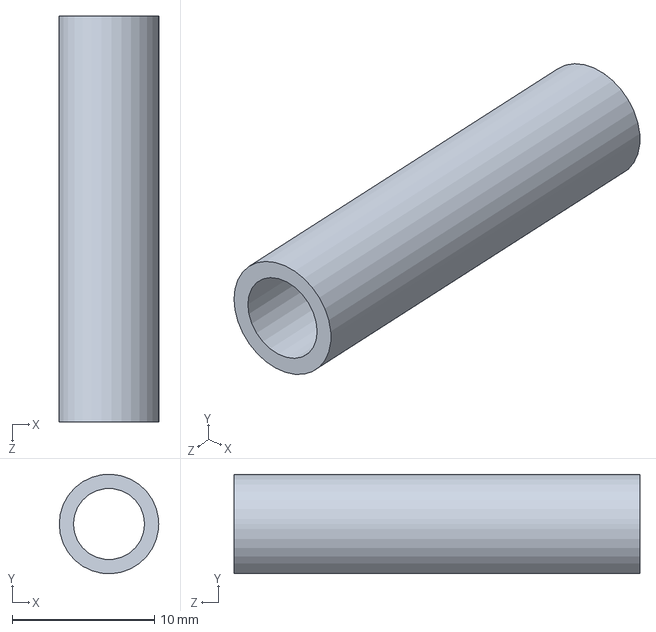
[picture p95: CAD file, 2024-04-19]
library parts/POS Solenoid Lock/plastic pipe.SLDPRT
7.00 x 6.99 x 28.6 mm
