nasser1245/Imona-Stand-Charger/models/stand version-6mm/top surface.SLDPRT

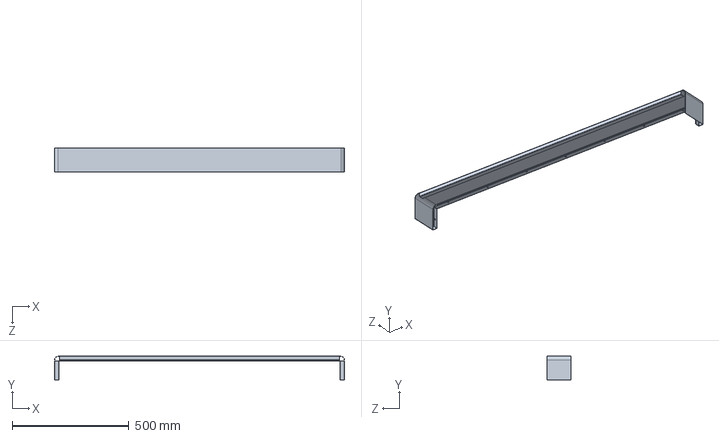
[picture p96: CAD file, 2024-04-19]
models/stand version-6mm/top surface.SLDPRT
1244.0 x 101.0 x 105.0 mm
