nasser1245/Imona-Stand-Charger/models/stand version/profile.SLDPRT

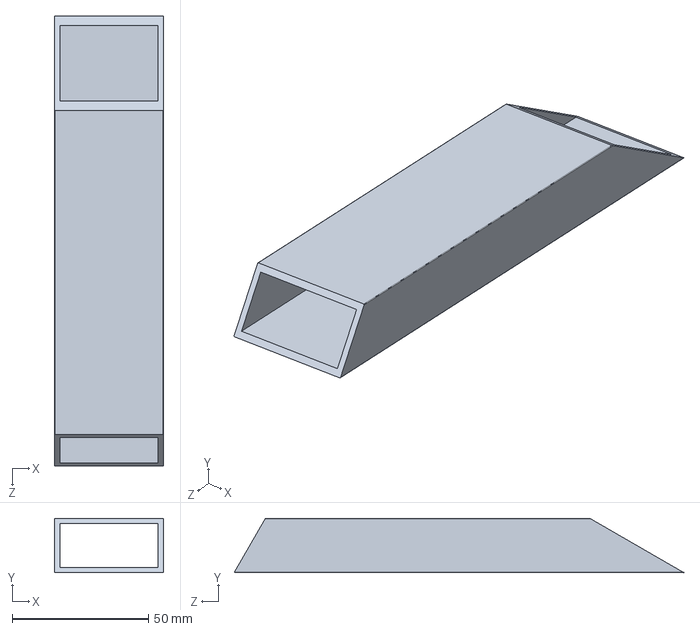
[picture p97: CAD file, 2024-04-19]
models/stand version/profile.SLDPRT
40.0 x 20.0 x 165.4 mm
