nasser1245/Imona-Stand-Charger/models/StandV2/bottom surfaceB.SLDPRT

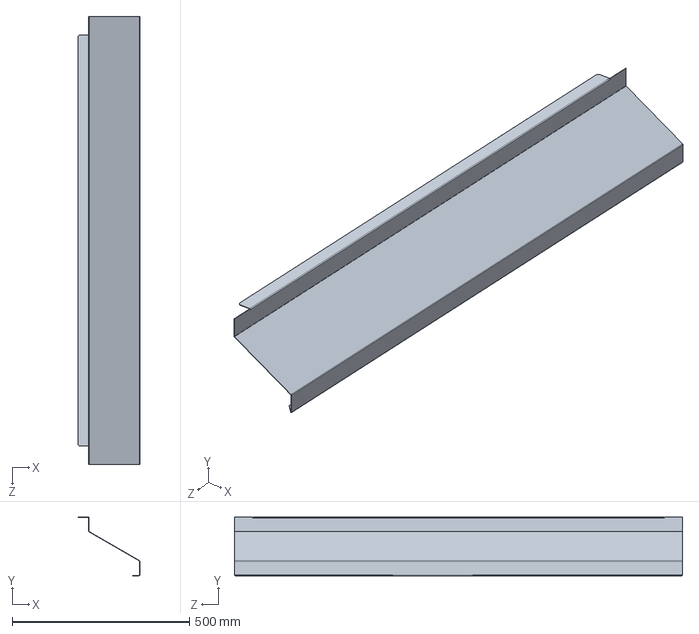
[picture p98: CAD file, 2024-04-19]
models/StandV2/bottom surfaceB.SLDPRT
174.3 x 164.9 x 1263.0 mm
