nasser1245/Imona-Stand-Charger/models/table version/top surface LCD.SLDPRT

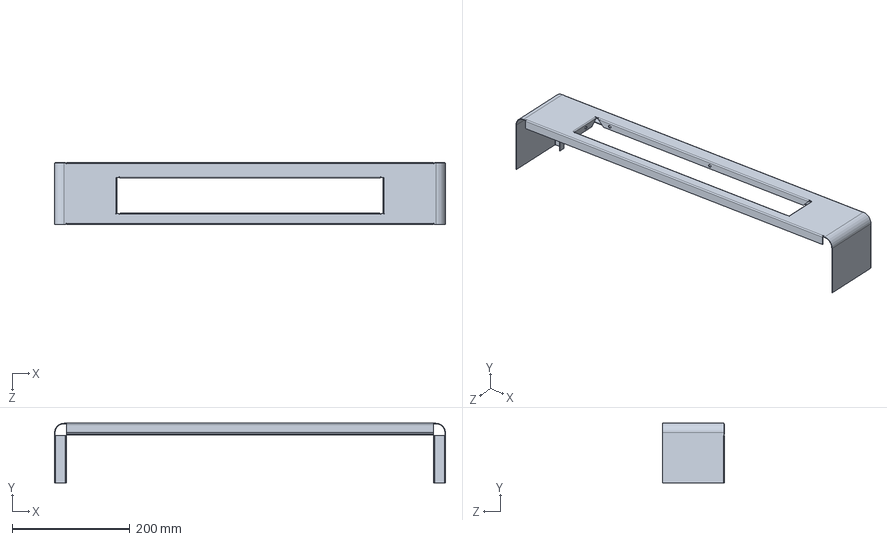
[picture p99: CAD file, 2024-04-19]
models/table version/top surface LCD.SLDPRT
663.4 x 101.0 x 105.0 mm
