nasser1245/Imona-Stand-Charger/models/wall version/front top surface-w-card.SLDPRT

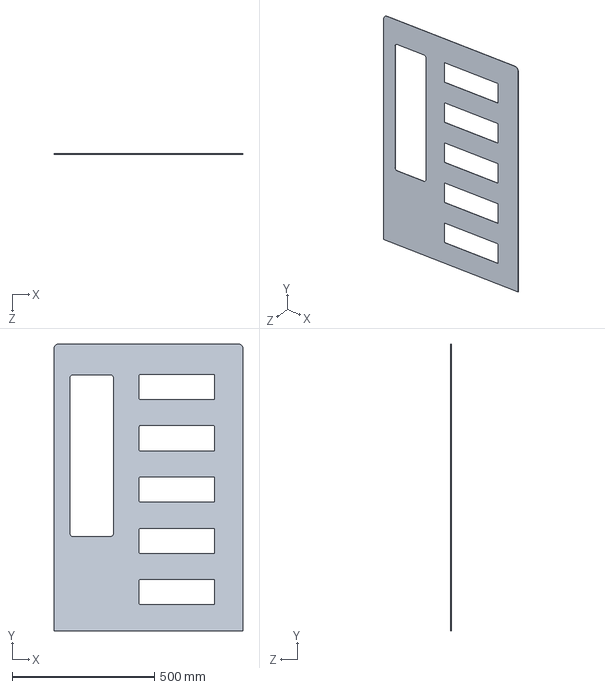
[picture p100: CAD file, 2024-04-19]
models/wall version/front top surface-w-card.SLDPRT
663.4 x 1007.7 x 1.00 mm
