nasser1245/Imona-Stand-Charger/library parts/fingerprint.SLDPRT

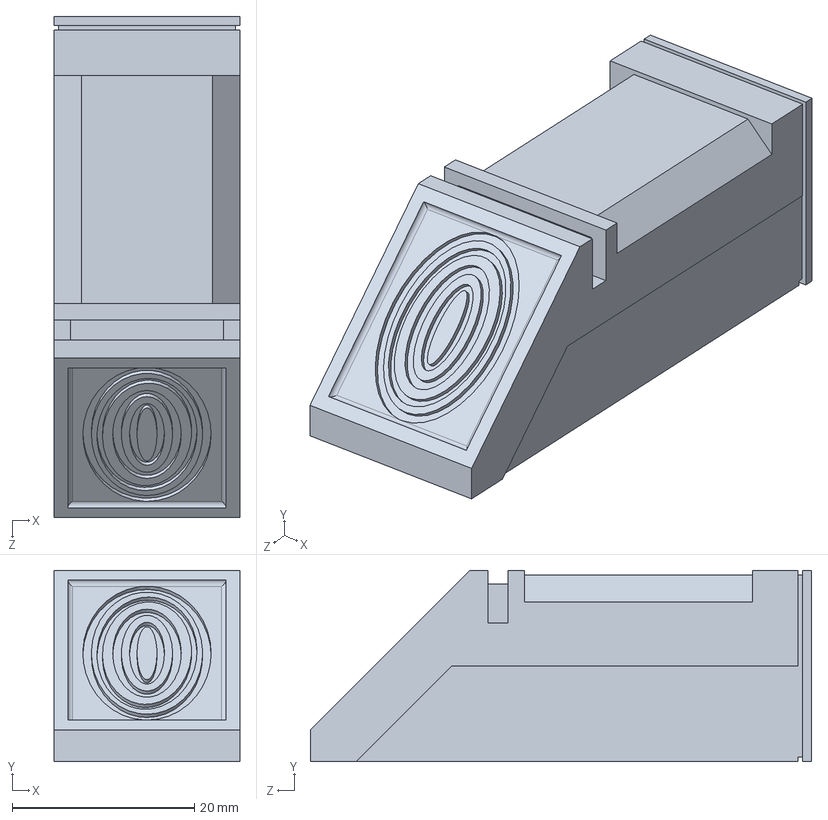
[picture p101: CAD file, 2024-04-19]
library parts/fingerprint.SLDPRT
20.4 x 21.0 x 55.0 mm
