nasser1245/Imona-Stand-Charger/models/stand version-6mm/side cover.SLDPRT

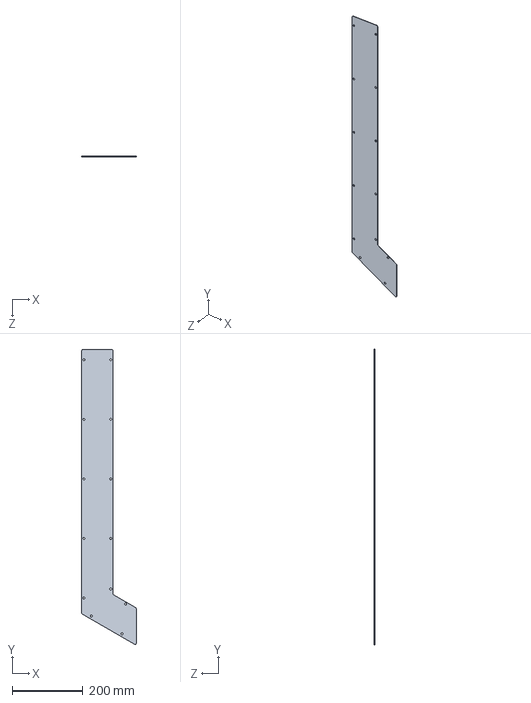
[picture p102: CAD file, 2024-04-19]
models/stand version-6mm/side cover.SLDPRT
154.0 x 832.6 x 1.00 mm
