nasser1245/Imona-Stand-Charger/models/stand version/top wrapper.SLDPRT

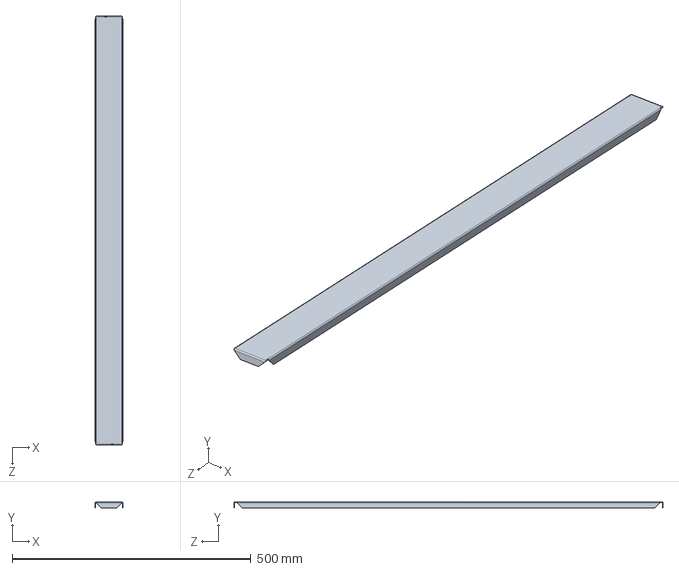
[picture p103: CAD file, 2024-04-19]
models/stand version/top wrapper.SLDPRT
58.0 x 13.0 x 898.0 mm
