nasser1245/Imona-Stand-Charger/models/StandV2/front bottom surface1.SLDPRT

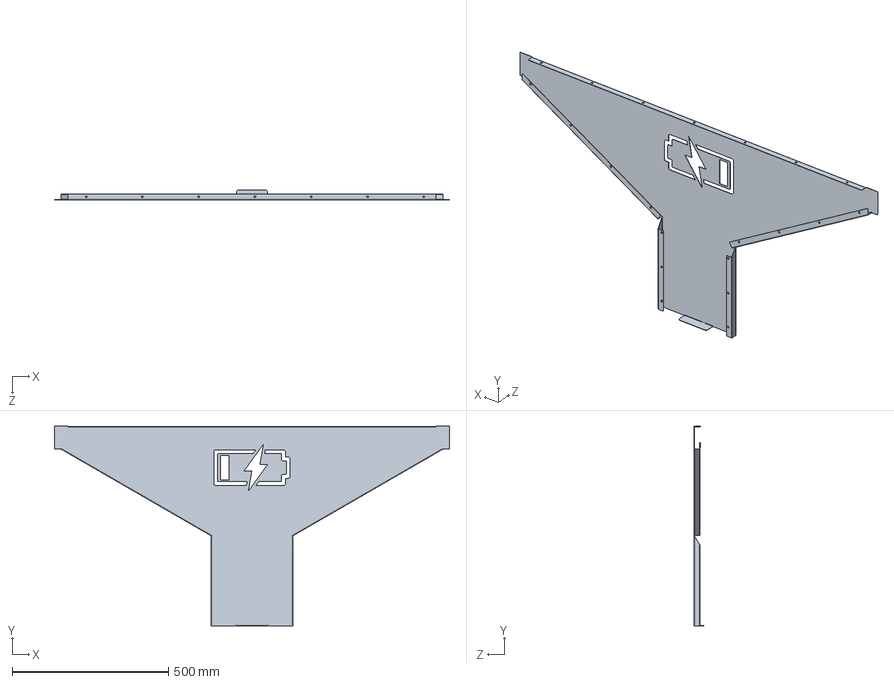
[picture p104: CAD file, 2024-04-19]
models/StandV2/front bottom surface1.SLDPRT
1263.0 x 639.0 x 31.0 mm
