nasser1245/Imona-Stand-Charger/models/StandV2/profiles/bottom center down heightR.SLDPRT

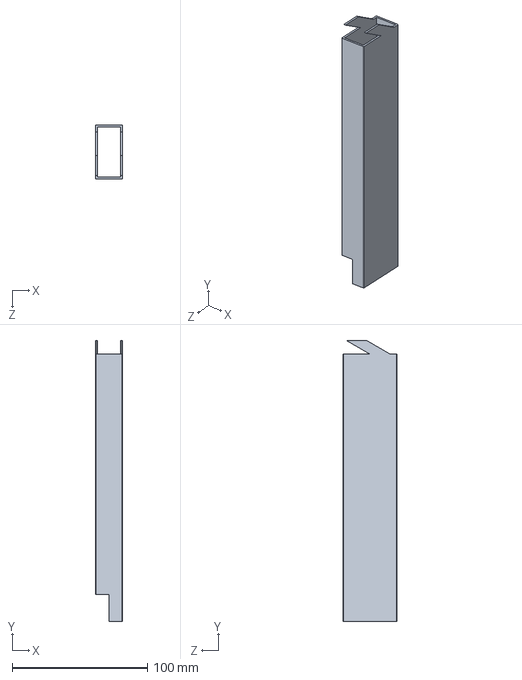
[picture p105: CAD file, 2024-04-19]
models/StandV2/profiles/bottom center down heightR.SLDPRT
20.0 x 208.0 x 40.0 mm
