nasser1245/Imona-Stand-Charger/library parts/POS lock tight.SLDPRT

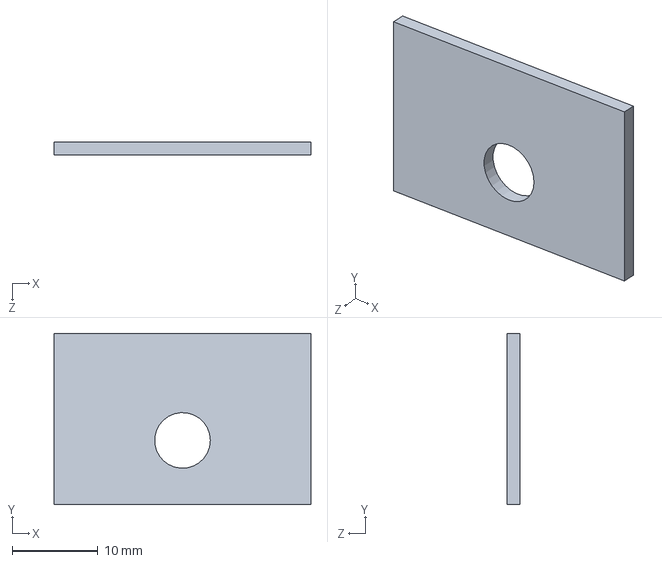
[picture p106: CAD file, 2024-04-19]
library parts/POS lock tight.SLDPRT
30.0 x 20.0 x 1.50 mm
