nasser1245/Imona-Stand-Charger/library parts/POS Solenoid Lock/backspring plastic.SLDPRT

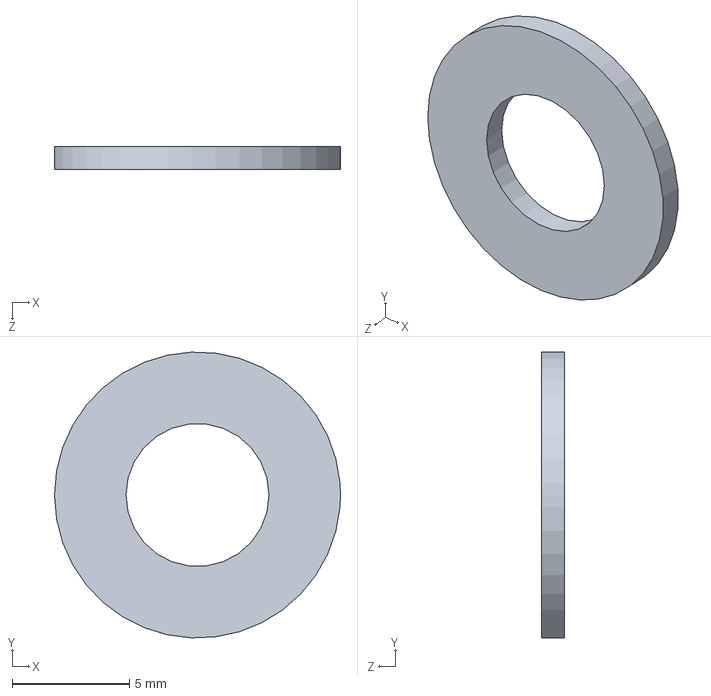
[picture p107: CAD file, 2024-04-19]
library parts/POS Solenoid Lock/backspring plastic.SLDPRT
12.2 x 12.2 x 1.00 mm
