nasser1245/Imona-Stand-Charger/models/stand version-6mm/side surface bottom.SLDPRT

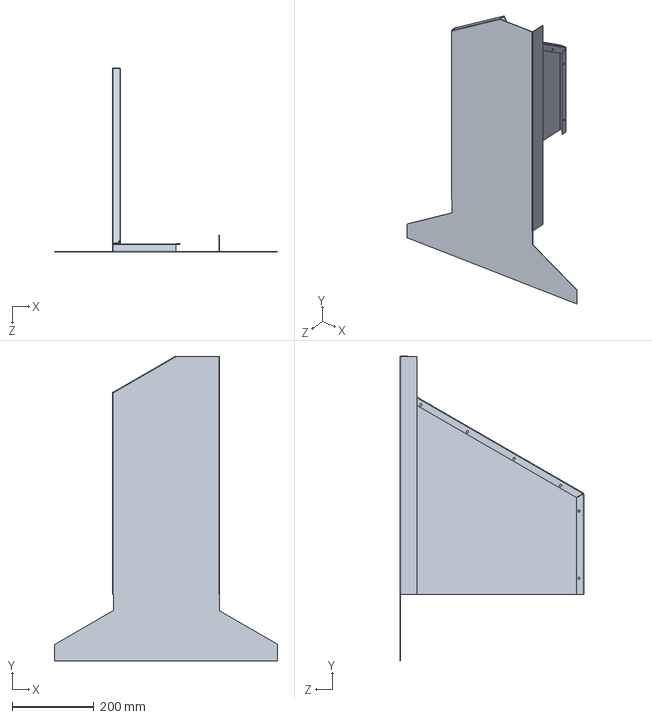
[picture p108: CAD file, 2024-04-19]
models/stand version-6mm/side surface bottom.SLDPRT
547.7 x 748.2 x 451.0 mm
