nasser1245/Imona-Stand-Charger/models/stand version/front top surface.SLDPRT

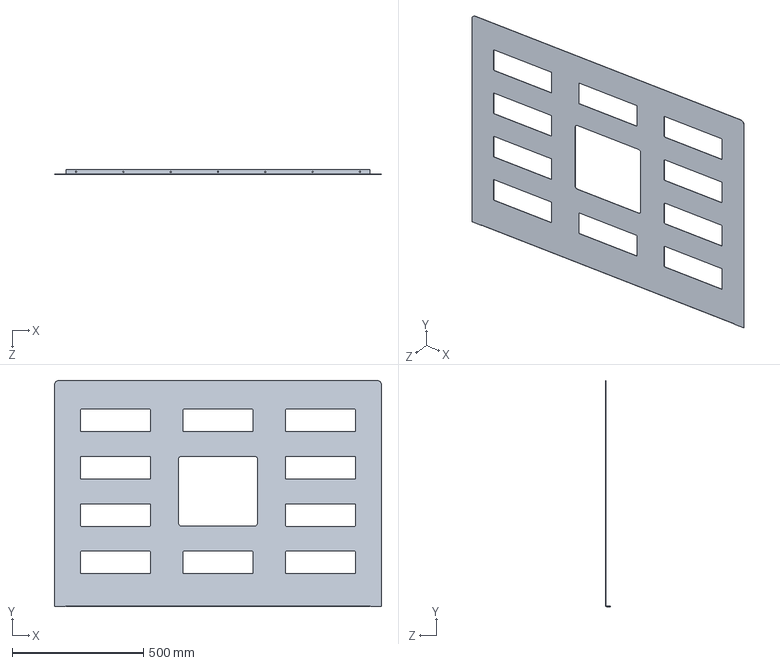
[picture p109: CAD file, 2024-04-19]
models/stand version/front top surface.SLDPRT
1244.0 x 860.0 x 19.0 mm
