nasser1245/Imona-Stand-Charger/models/StandV2/profiles/middle width sub.SLDPRT

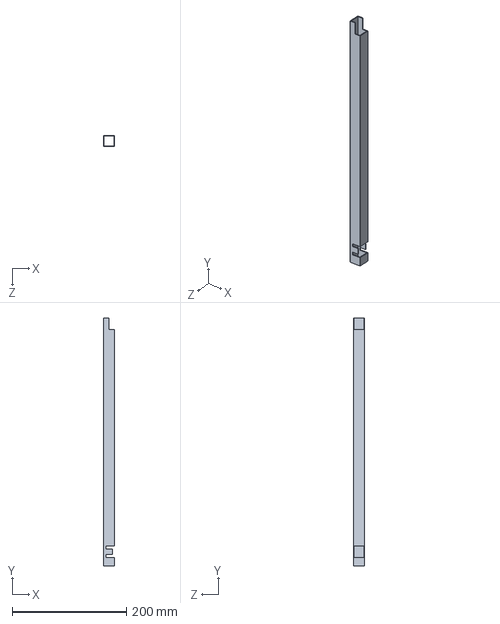
[picture p111: CAD file, 2024-04-19]
models/StandV2/profiles/middle width sub.SLDPRT
20.0 x 435.0 x 20.0 mm
