nasser1245/Imona-Stand-Charger/models/table version/edge wrapper-w.SLDPRT

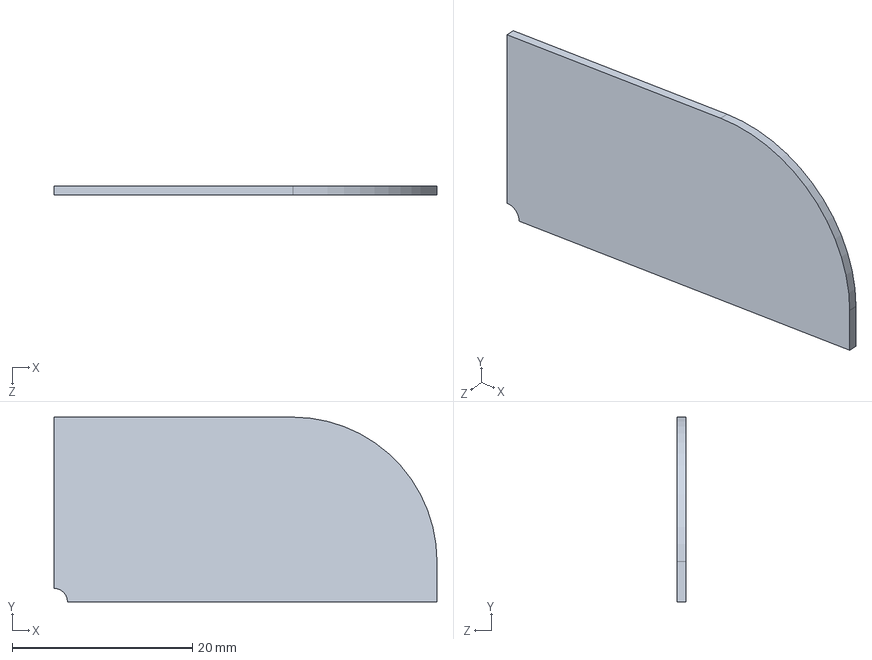
[picture p112: CAD file, 2024-04-19]
models/table version/edge wrapper-w.SLDPRT
42.5 x 20.5 x 1.00 mm
