nasser1245/Imona-Stand-Charger/models/wall version/side surface front-W.SLDPRT

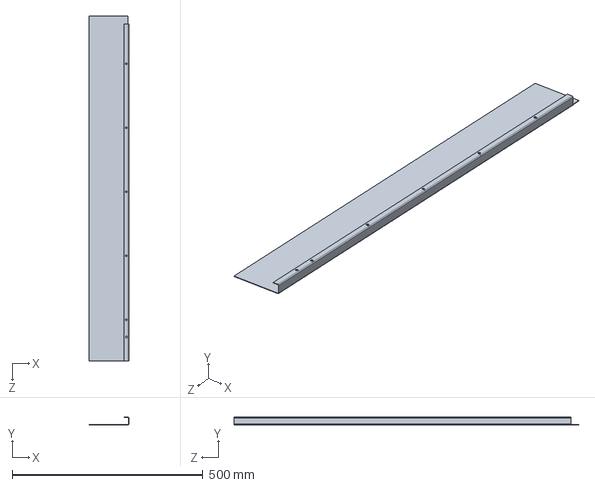
[picture p113: CAD file, 2024-04-19]
models/wall version/side surface front-W.SLDPRT
105.0 x 20.0 x 905.2 mm
