nasser1245/Imona-Stand-Charger/library parts/lock.SLDPRT

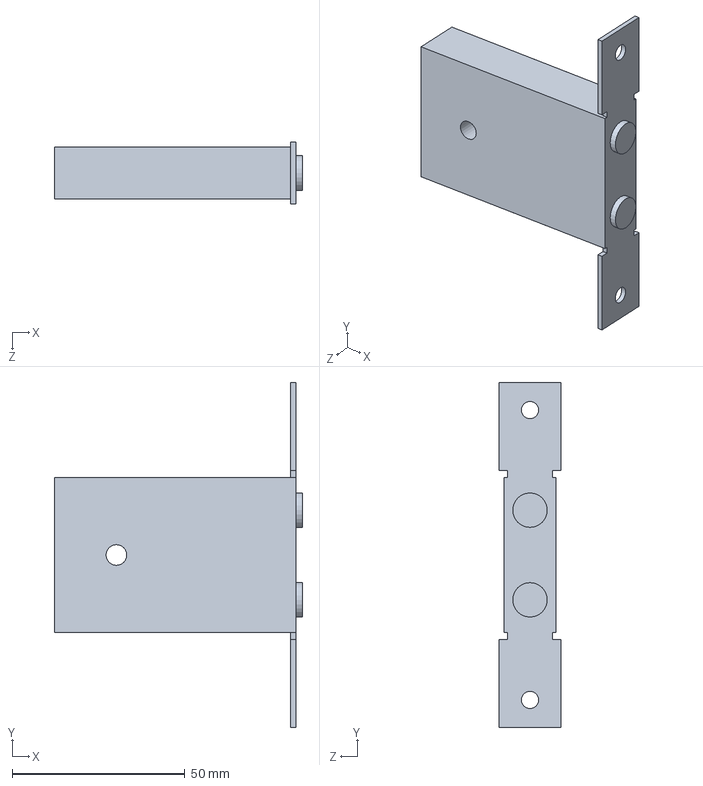
[picture p114: CAD file, 2024-04-19]
library parts/lock.SLDPRT
72.0 x 100.0 x 18.0 mm
