nasser1245/Imona-Stand-Charger/library parts/POS Solenoid Lock/top.SLDPRT

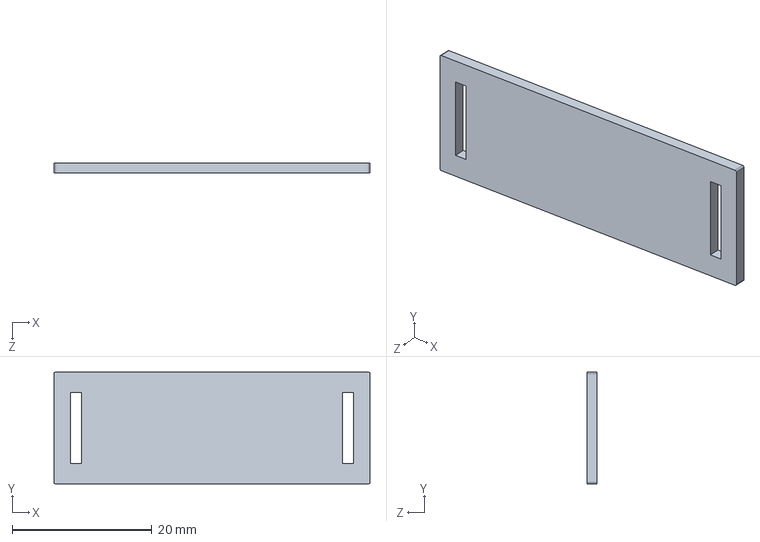
[picture p115: CAD file, 2024-04-19]
library parts/POS Solenoid Lock/top.SLDPRT
45.2 x 16.0 x 1.50 mm
