nasser1245/Imona-Stand-Charger/models/stand version-6mm/bottom surface.SLDPRT

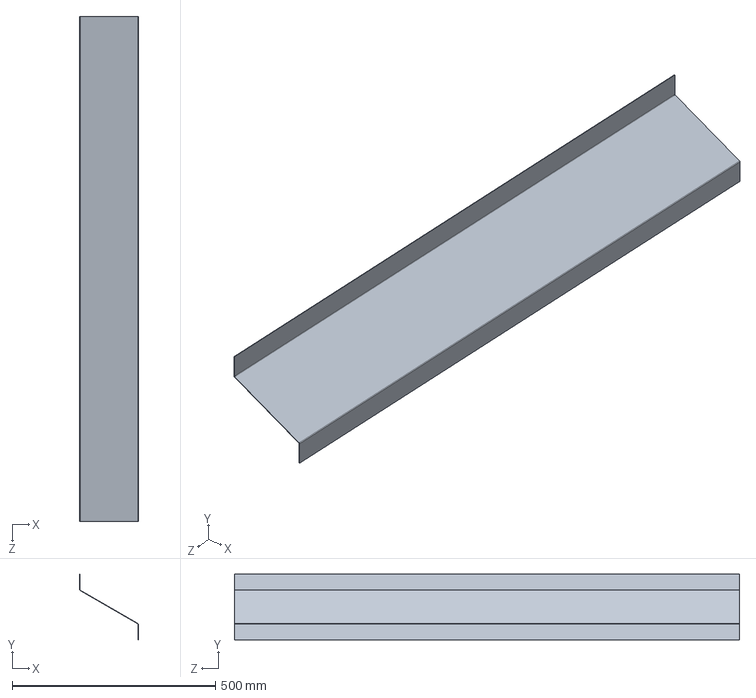
[picture p116: CAD file, 2024-04-19]
models/stand version-6mm/bottom surface.SLDPRT
144.3 x 162.3 x 1242.0 mm
