nasser1245/Imona-Stand-Charger/models/StandV2/edge side back.SLDPRT

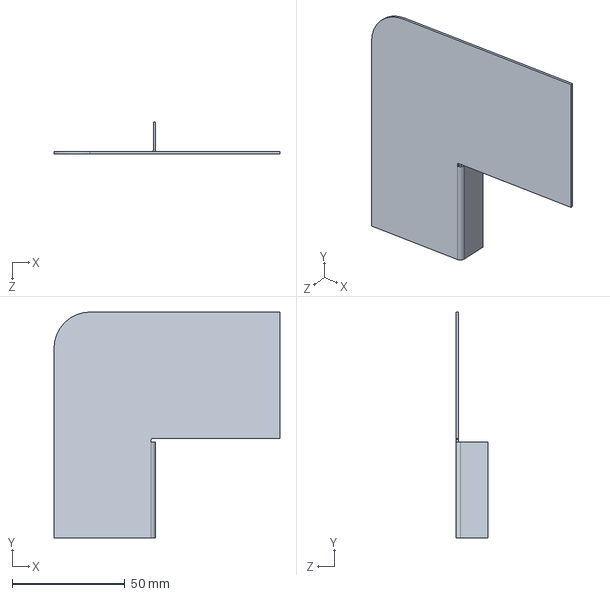
[picture p117: CAD file, 2024-04-19]
models/StandV2/edge side back.SLDPRT
100.0 x 100.0 x 14.0 mm
