nasser1245/Imona-Stand-Charger/models/table version/top surface back-T.SLDPRT

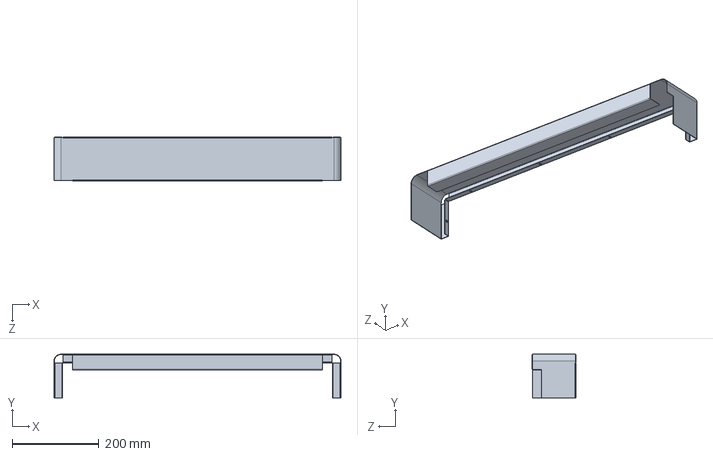
[picture p118: CAD file, 2024-04-19]
models/table version/top surface back-T.SLDPRT
663.4 x 101.0 x 101.0 mm
