nasser1245/Imona-Stand-Charger/models/wall version/lock holder.SLDPRT

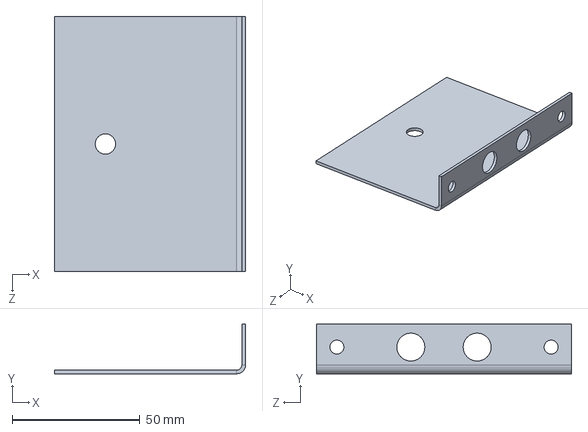
[picture p119: CAD file, 2024-04-19]
models/wall version/lock holder.SLDPRT
75.0 x 19.5 x 100.0 mm
