nasser1245/Imona-Stand-Charger/library parts/fingerprint mount.SLDPRT

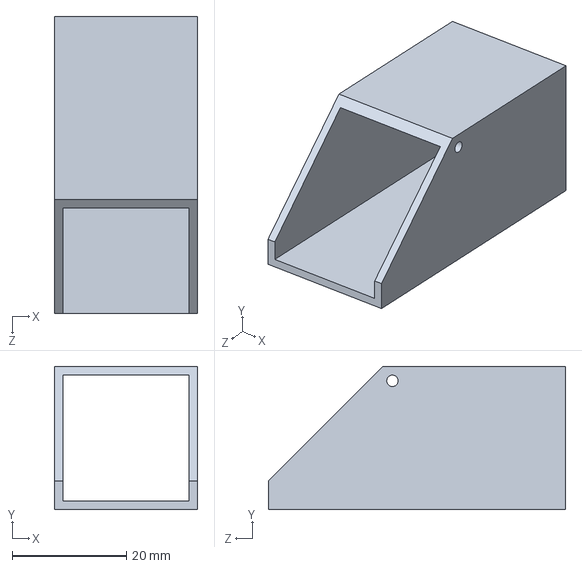
[picture p120: CAD file, 2024-04-19]
library parts/fingerprint mount.SLDPRT
25.0 x 25.0 x 52.0 mm
