nasser1245/Imona-Stand-Charger/library parts/POS Solenoid Lock/diy proximity sensor.SLDPRT

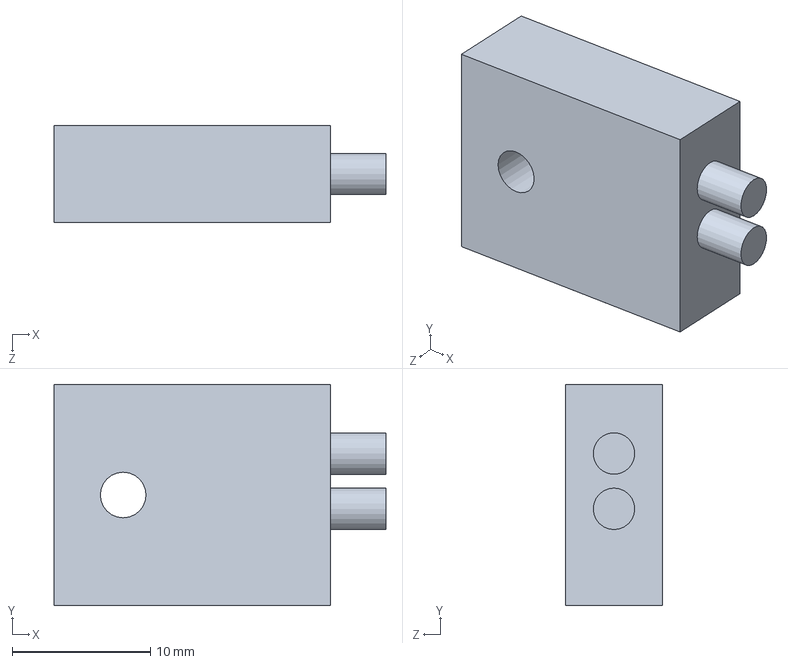
[picture p121: CAD file, 2024-04-19]
library parts/POS Solenoid Lock/diy proximity sensor.SLDPRT
24.0 x 16.0 x 7.00 mm
