nasser1245/Imona-Stand-Charger/models/stand version-6mm/front bottom surface.SLDPRT

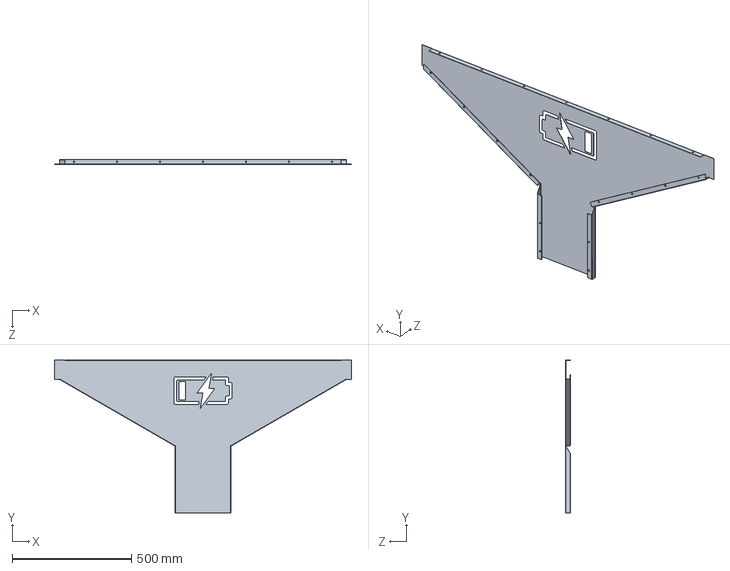
[picture p122: CAD file, 2024-04-19]
models/stand version-6mm/front bottom surface.SLDPRT
1244.0 x 640.0 x 19.0 mm
