nasser1245/Imona-Stand-Charger/models/stand version/side surface bottom.SLDPRT

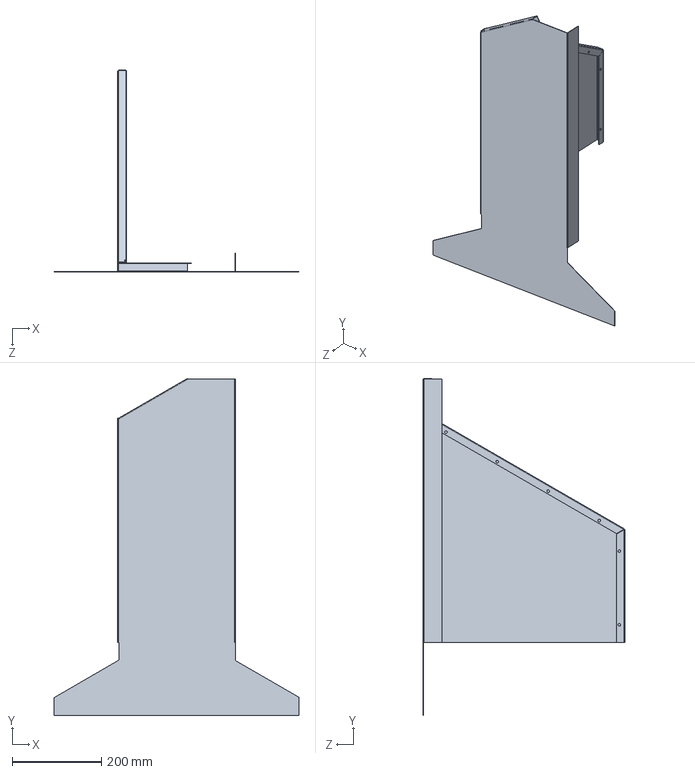
[picture p123: CAD file, 2024-04-19]
models/stand version/side surface bottom.SLDPRT
547.7 x 754.2 x 451.0 mm
