nasser1245/Imona-Stand-Charger/models/StandV2/aux bottom wrapper.SLDPRT

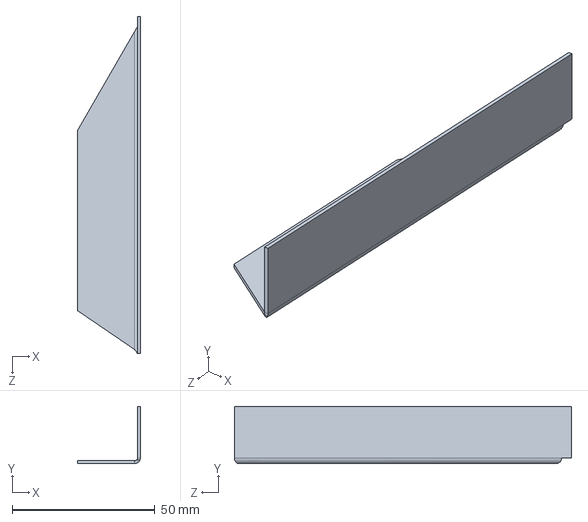
[picture p124: CAD file, 2024-04-19]
models/StandV2/aux bottom wrapper.SLDPRT
22.0 x 20.0 x 118.0 mm
