nasser1245/Imona-Stand-Charger/models/StandV2/profiles/width subR.SLDPRT

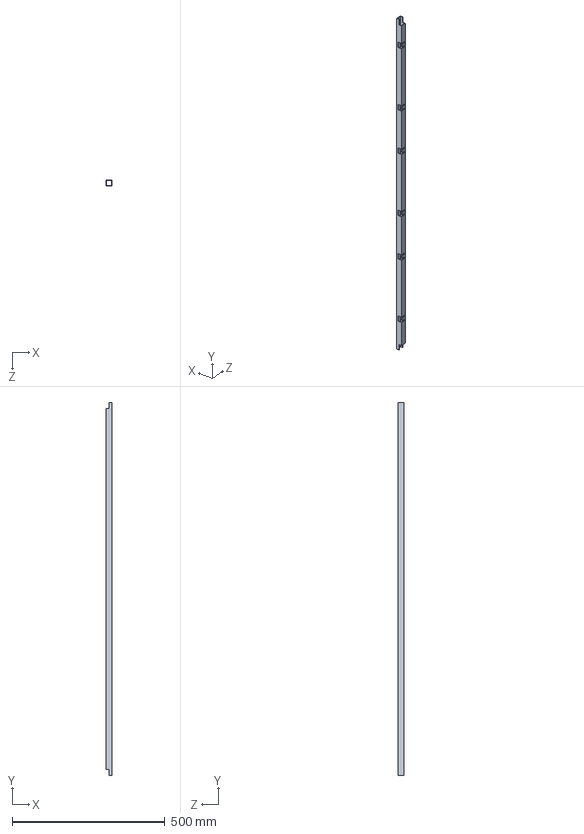
[picture p125: CAD file, 2024-04-19]
models/StandV2/profiles/width subR.SLDPRT
20.0 x 1220.0 x 20.0 mm
