nasser1245/Imona-Stand-Charger/models/table version/profile table.SLDPRT

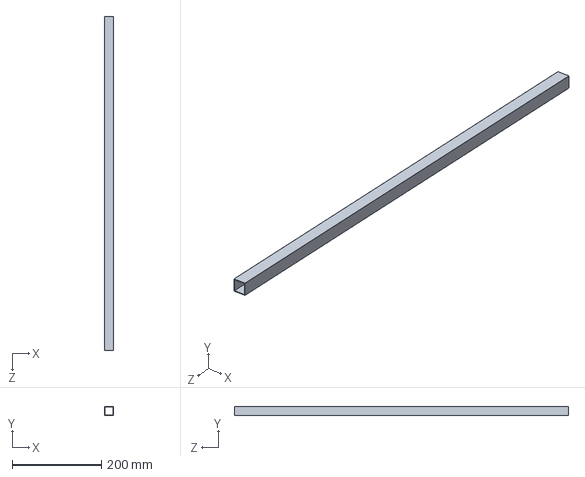
[picture p126: CAD file, 2024-04-19]
models/table version/profile table.SLDPRT
20.0 x 20.0 x 747.0 mm
