nasser1245/Imona-Stand-Charger/library parts/POS Solenoid Lock/catch bush.SLDPRT

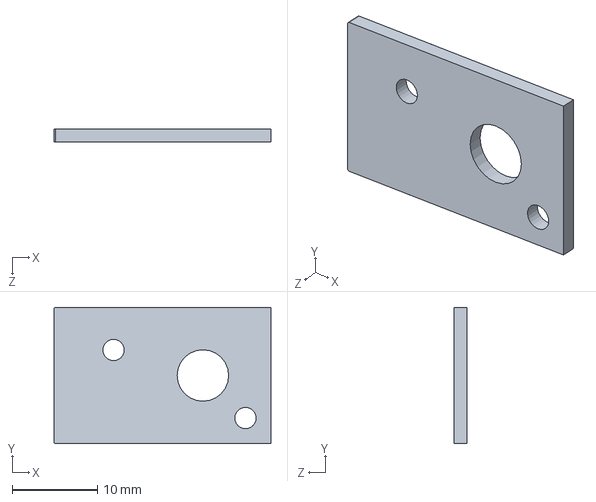
[picture p127: CAD file, 2024-04-19]
library parts/POS Solenoid Lock/catch bush.SLDPRT
25.5 x 16.0 x 1.50 mm
