nasser1245/Imona-Stand-Charger/library parts/pos.SLDPRT

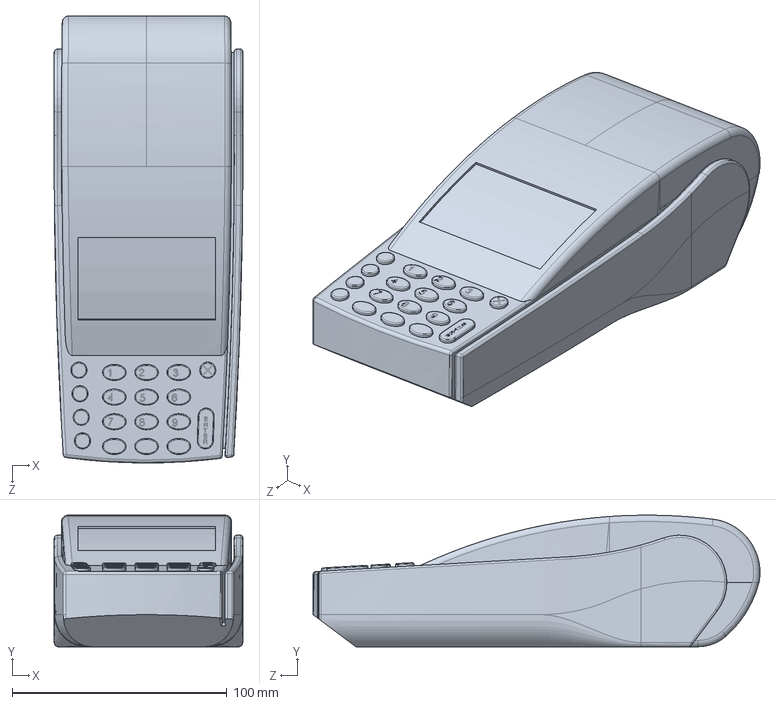
[picture p128: CAD file, 2024-04-19]
library parts/pos.SLDPRT
87.9 x 61.3 x 208.1 mm
