nasser1245/Imona-Stand-Charger/models/StandV2/front top surface-wrapper.SLDPRT

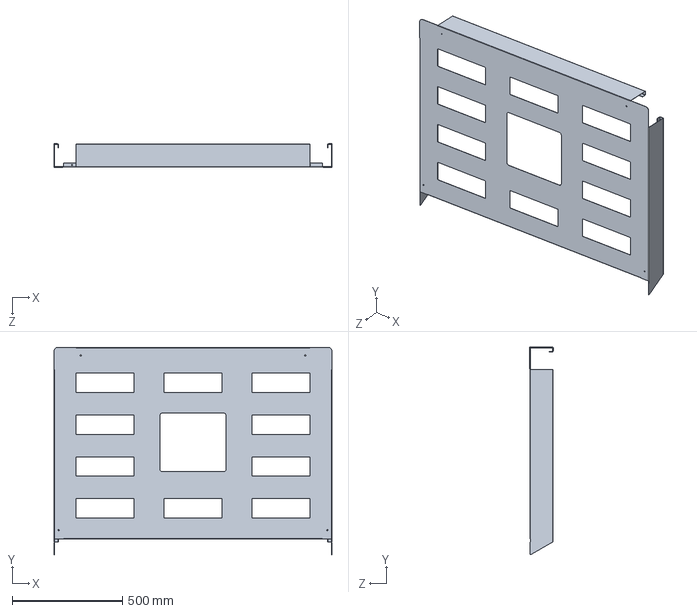
[picture p129: CAD file, 2024-04-19]
models/StandV2/front top surface-wrapper.SLDPRT
1263.0 x 940.7 x 106.0 mm
