nasser1245/Imona-Stand-Charger/models/StandV2/profiles/door width lock.SLDPRT

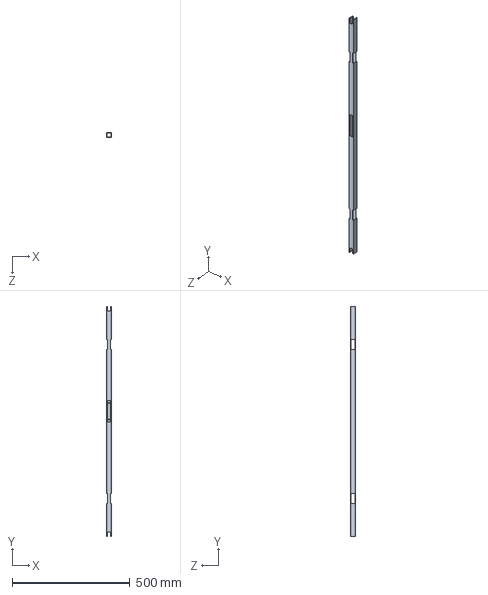
[picture p130: CAD file, 2024-04-19]
models/StandV2/profiles/door width lock.SLDPRT
20.0 x 977.0 x 20.0 mm
