nasser1245/Imona-Stand-Charger/library parts/big lcd32.SLDPRT

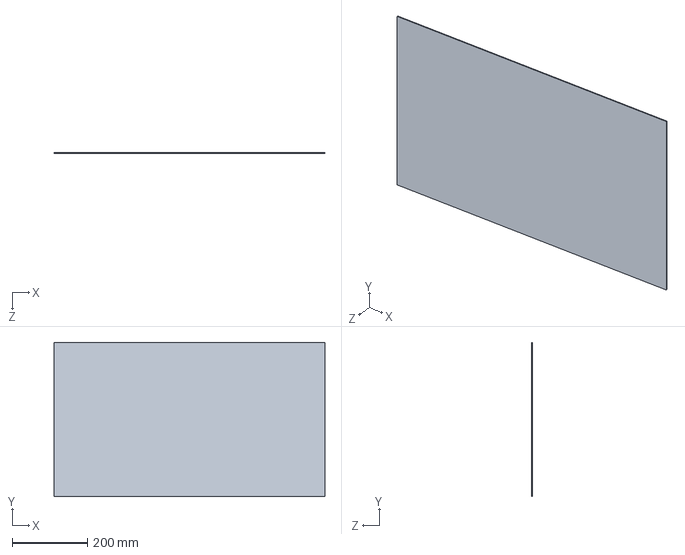
[picture p131: CAD file, 2024-04-19]
library parts/big lcd32.SLDPRT
720.0 x 410.0 x 2.00 mm
