nasser1245/Imona-Stand-Charger/library parts/POS Solenoid Lock/Body.SLDPRT

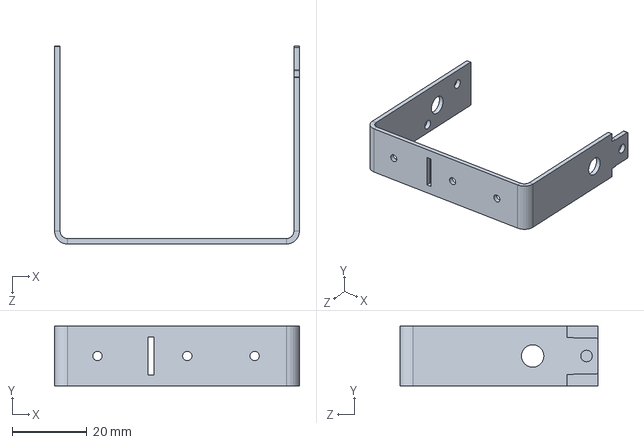
[picture p132: CAD file, 2024-04-19]
library parts/POS Solenoid Lock/Body.SLDPRT
65.5 x 16.0 x 53.0 mm
