nasser1245/Imona-Stand-Charger/models/stand version-6mm/below door cover.SLDPRT

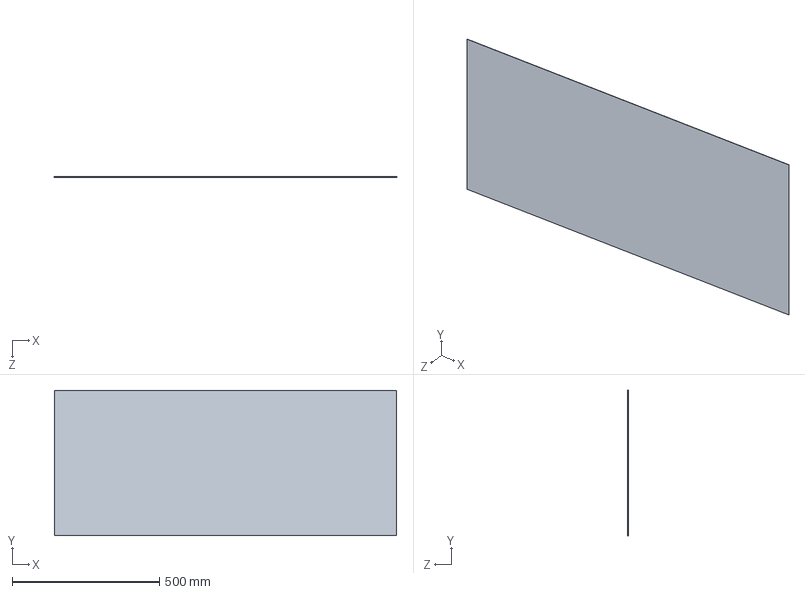
[picture p133: CAD file, 2024-04-19]
models/stand version-6mm/below door cover.SLDPRT
1160.0 x 492.0 x 1.00 mm
