nasser1245/Imona-Stand-Charger/models/stand version/side surface back.SLDPRT

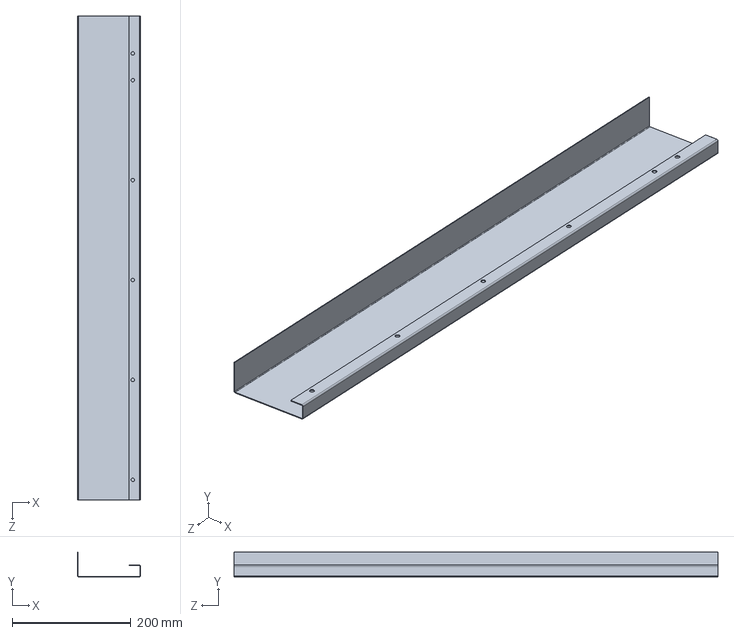
[picture p134: CAD file, 2024-04-19]
models/stand version/side surface back.SLDPRT
106.0 x 42.0 x 814.0 mm
