nasser1245/Imona-Stand-Charger/models/StandV2/edge bigR.SLDPRT

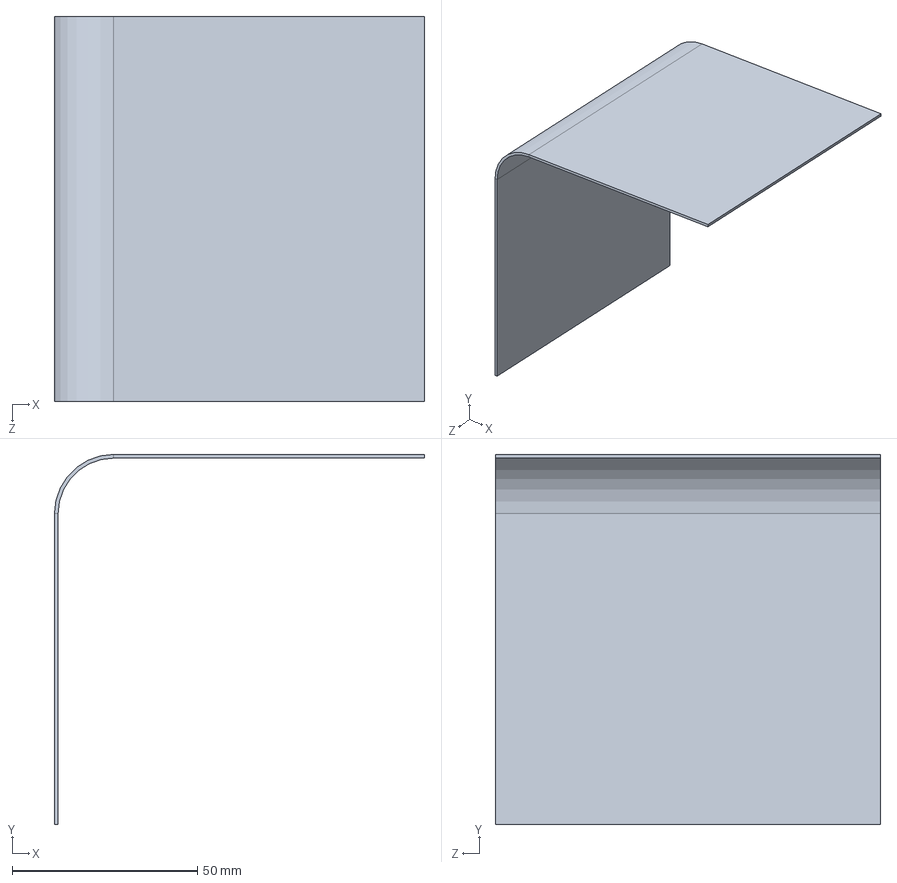
[picture p135: CAD file, 2024-04-19]
models/StandV2/edge bigR.SLDPRT
100.0 x 100.0 x 104.0 mm
