nasser1245/Imona-Stand-Charger/models/StandV2/profiles/Door height hinge.SLDPRT

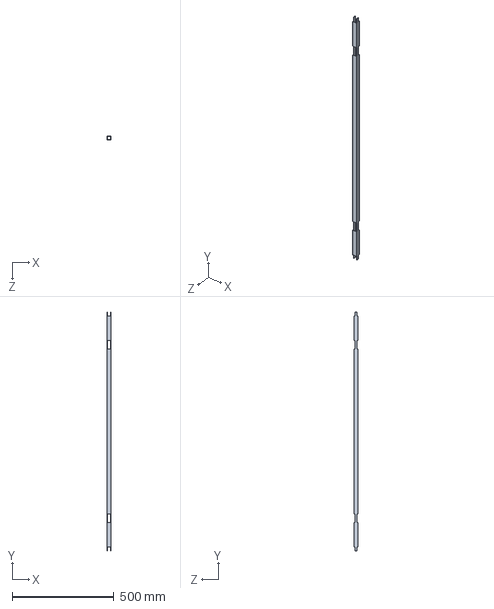
[picture p136: CAD file, 2024-04-19]
models/StandV2/profiles/Door height hinge.SLDPRT
20.0 x 1177.0 x 20.0 mm
