nasser1245/Imona-Stand-Charger/models/wall version/top cover big-w.SLDPRT

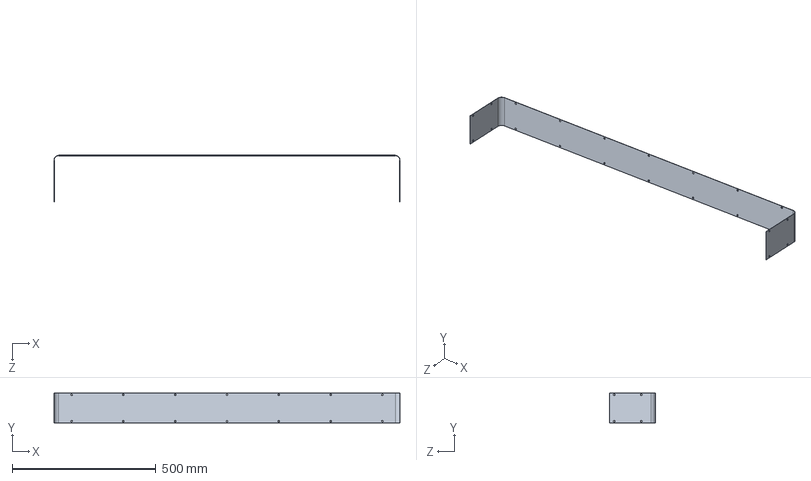
[picture p137: CAD file, 2024-04-19]
models/wall version/top cover big-w.SLDPRT
1202.0 x 104.0 x 160.0 mm
