nasser1245/Imona-Stand-Charger/library parts/camera holder.SLDPRT

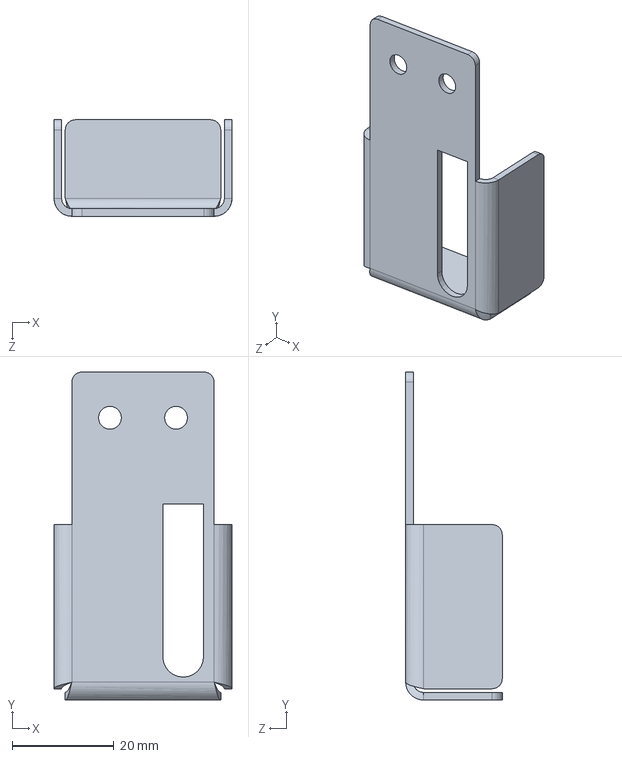
[picture p138: CAD file, 2024-04-19]
library parts/camera holder.SLDPRT
35.0 x 64.5 x 19.0 mm
