nasser1245/Imona-Stand-Charger/library parts/POS Solenoid Lock/ball wheel.SLDPRT

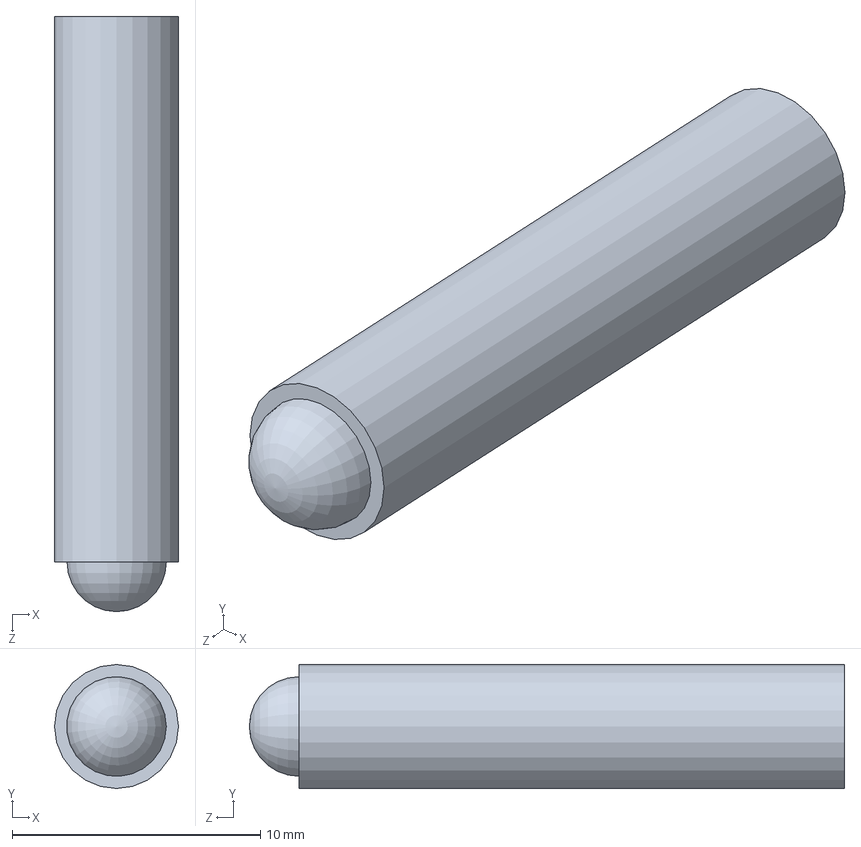
[picture p139: CAD file, 2024-04-19]
library parts/POS Solenoid Lock/ball wheel.SLDPRT
5.00 x 5.00 x 24.0 mm
