nasser1245/Imona-Stand-Charger/models/stand version-6mm/bottom floor.SLDPRT

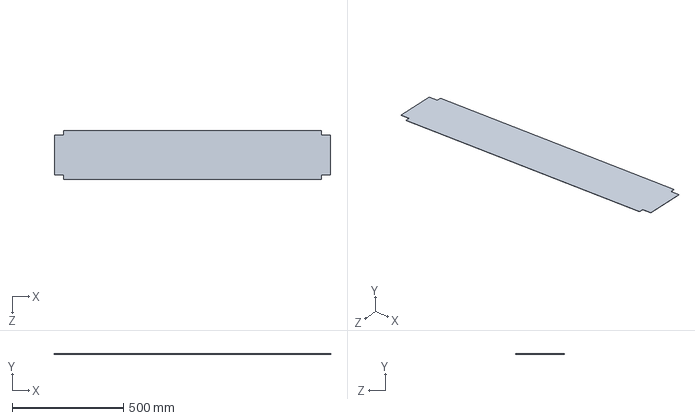
[picture p140: CAD file, 2024-04-19]
models/stand version-6mm/bottom floor.SLDPRT
1239.0 x 1.00 x 219.0 mm
