nasser1245/Imona-Stand-Charger/models/StandV2/side surface bottomRL.SLDPRT

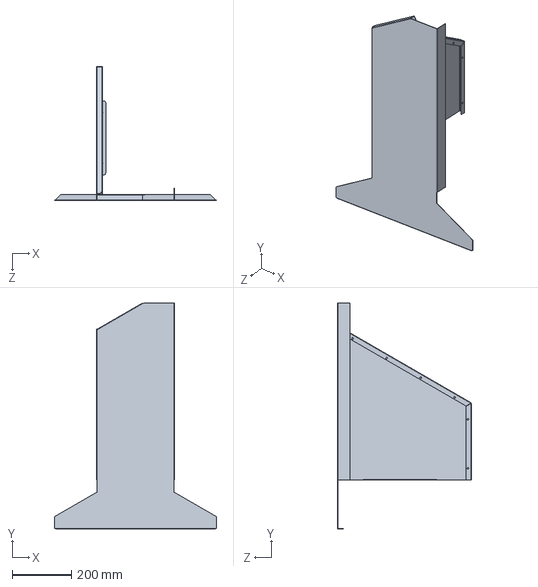
[picture p141: CAD file, 2024-04-19]
models/StandV2/side surface bottomRL.SLDPRT
546.6 x 760.3 x 451.0 mm
