nasser1245/Imona-Stand-Charger/models/table version/bottom cover-w.SLDPRT

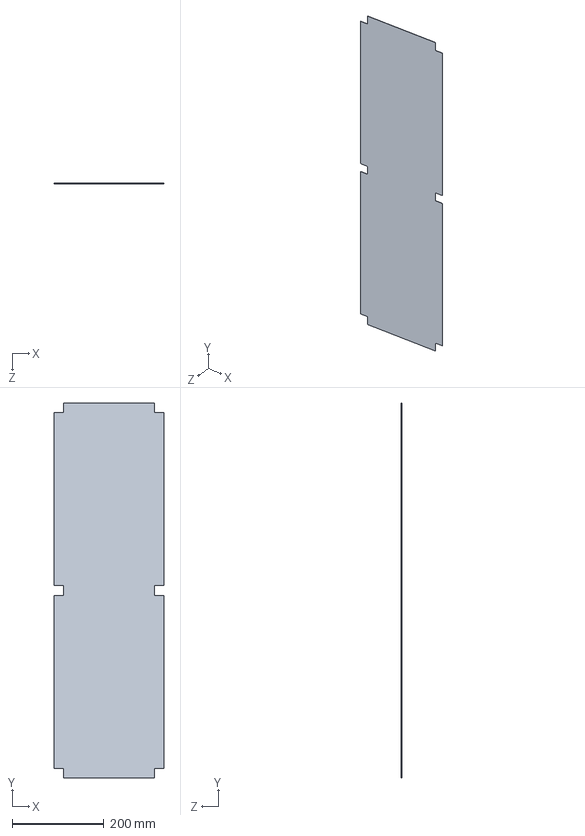
[picture p142: CAD file, 2024-04-19]
models/table version/bottom cover-w.SLDPRT
240.0 x 819.4 x 0.7 mm
