nasser1245/Imona-Stand-Charger/models/wall version/top surface front.SLDPRT

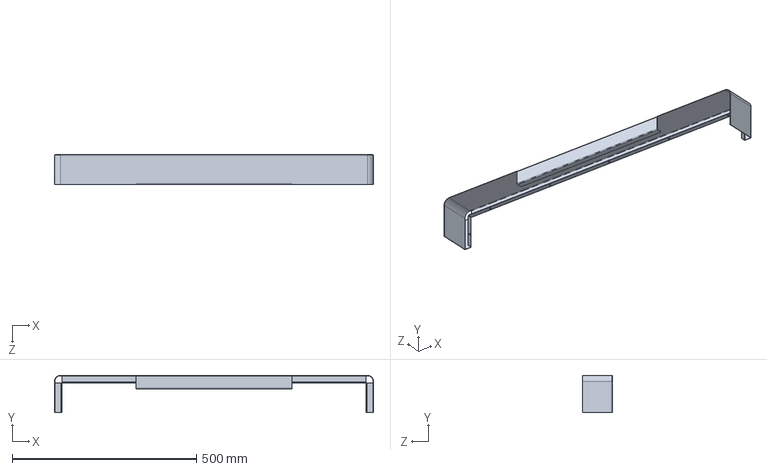
[picture p143: CAD file, 2024-04-19]
models/wall version/top surface front.SLDPRT
865.4 x 101.0 x 81.0 mm
