nasser1245/Imona-Stand-Charger/library parts/POS Solenoid Lock/catch.SLDPRT

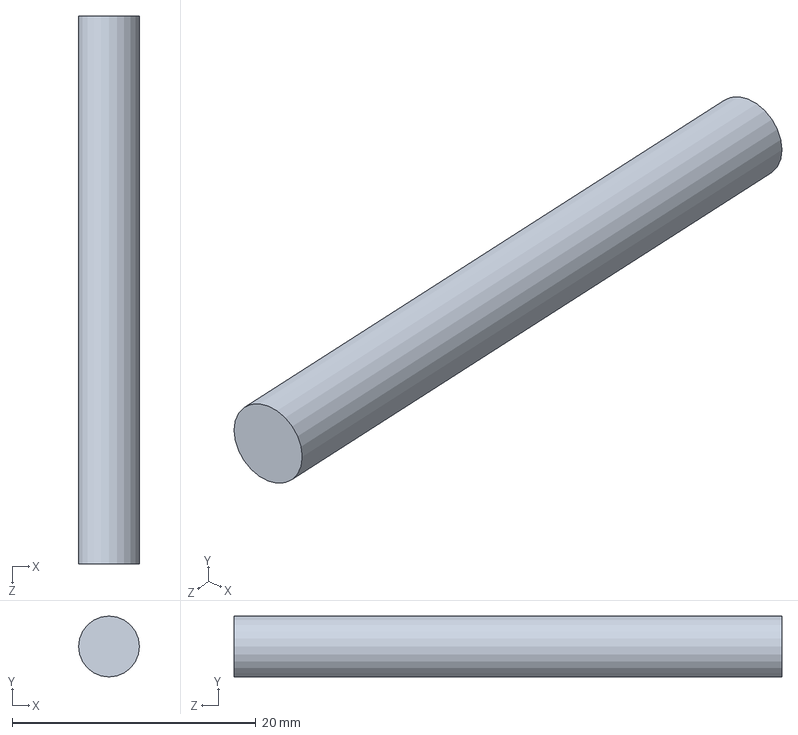
[picture p144: CAD file, 2024-04-19]
library parts/POS Solenoid Lock/catch.SLDPRT
5.00 x 5.00 x 45.0 mm
