nasser1245/Imona-Stand-Charger/library parts/Sensor, IR, Arduino Type, Flying Fish MH-B.SLDPRT

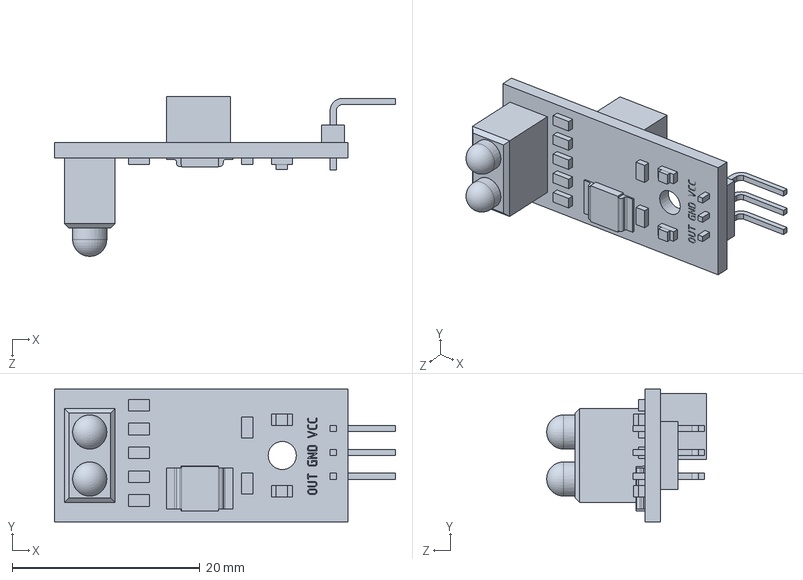
[picture p145: CAD file, 2024-04-19]
library parts/Sensor, IR, Arduino Type, Flying Fish MH-B.SLDPRT
36.3 x 14.2 x 17.0 mm
