nasser1245/Imona-Stand-Charger/models/StandV2/side long cover.SLDPRT

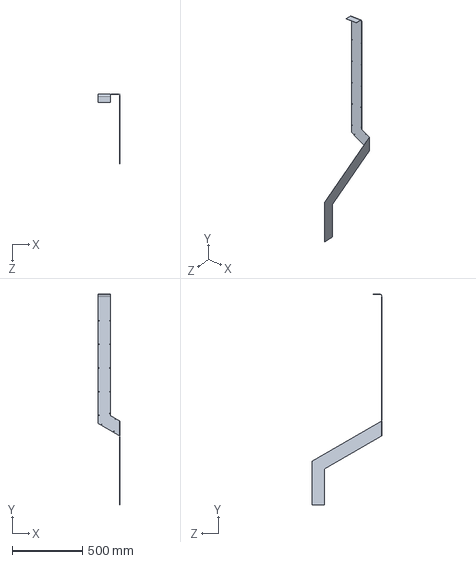
[picture p146: CAD file, 2024-04-19]
models/StandV2/side long cover.SLDPRT
155.0 x 1497.9 x 495.8 mm
