nasser1245/Imona-Stand-Charger/models/wall version/top surface LCD.SLDPRT

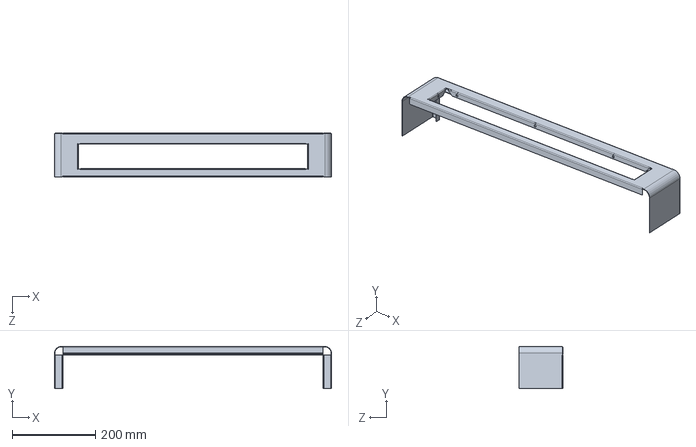
[picture p147: CAD file, 2024-04-19]
models/wall version/top surface LCD.SLDPRT
665.4 x 101.0 x 105.0 mm
