nasser1245/Imona-Stand-Charger/library parts/side proximity sensor.SLDPRT

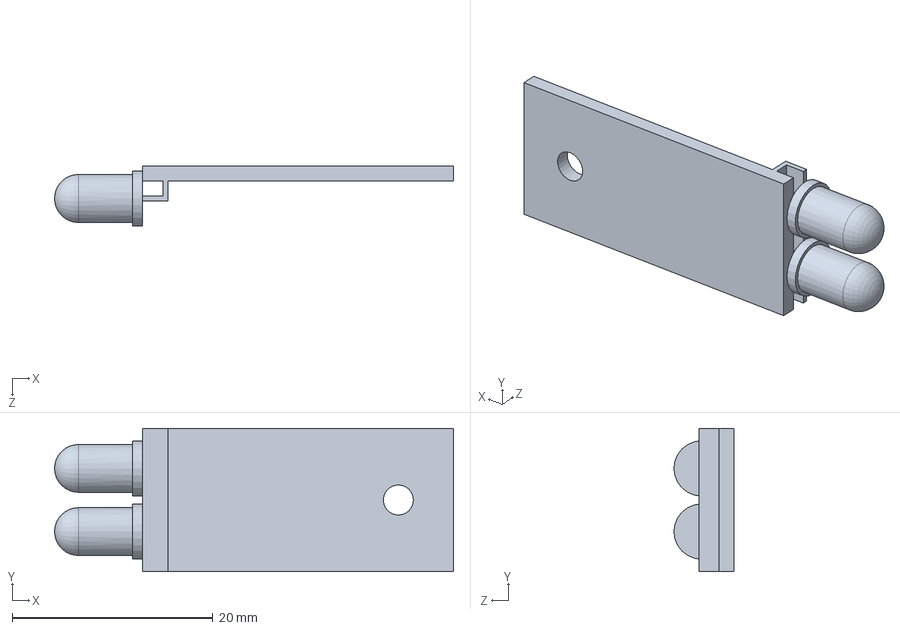
[picture p148: CAD file, 2024-04-19]
library parts/side proximity sensor.SLDPRT
39.8 x 14.3 x 6.00 mm
