nasser1245/Imona-Stand-Charger/models/stand version/below door cover.SLDPRT

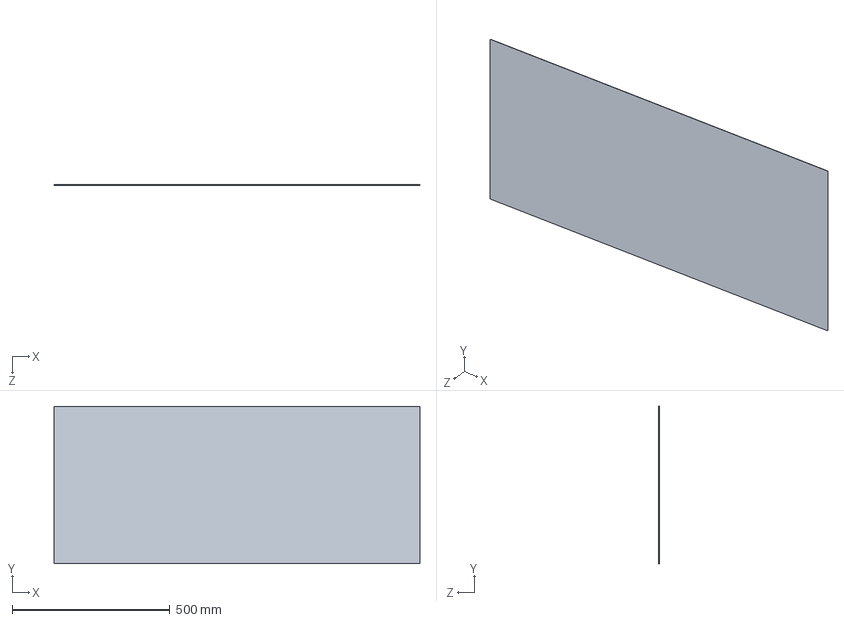
[picture p149: CAD file, 2024-04-19]
models/stand version/below door cover.SLDPRT
1160.0 x 499.0 x 1.00 mm
