nasser1245/Imona-Stand-Charger/models/StandV2/top surface backside.SLDPRT

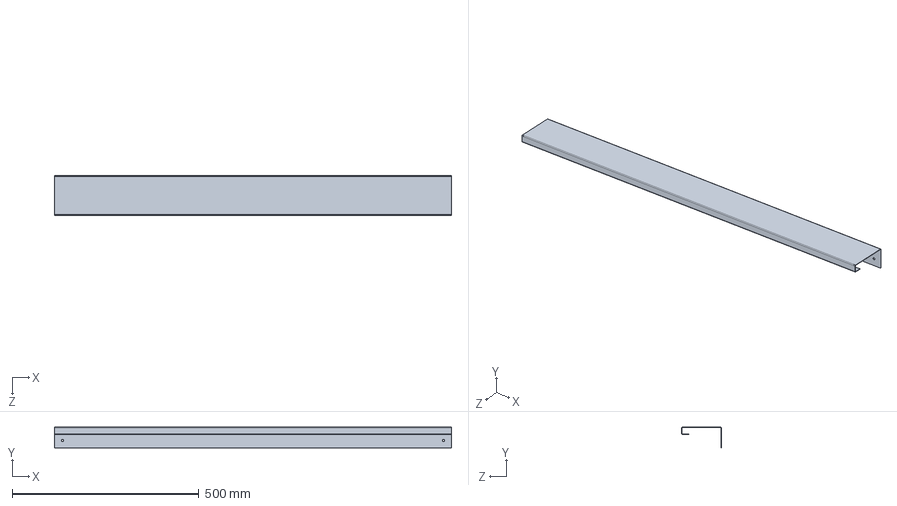
[picture p150: CAD file, 2024-04-19]
models/StandV2/top surface backside.SLDPRT
1063.0 x 56.0 x 106.0 mm
