nasser1245/Imona-Stand-Charger/library parts/7inch HDMI display 1204x600.SLDPRT

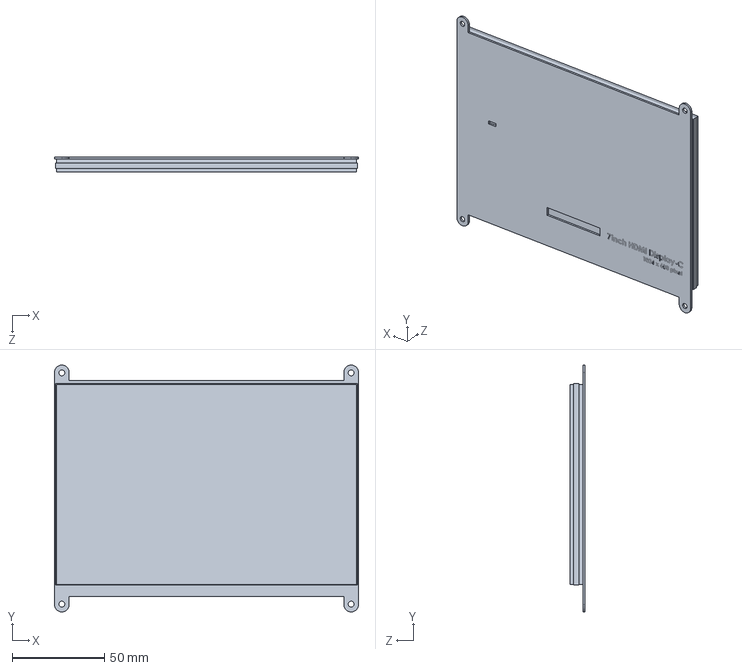
[picture p151: CAD file, 2024-04-19]
library parts/7inch HDMI display 1204x600.SLDPRT
165.0 x 134.0 x 8.20 mm
