nasser1245/Imona-Stand-Charger/models/stand version/top surface LCD.SLDPRT

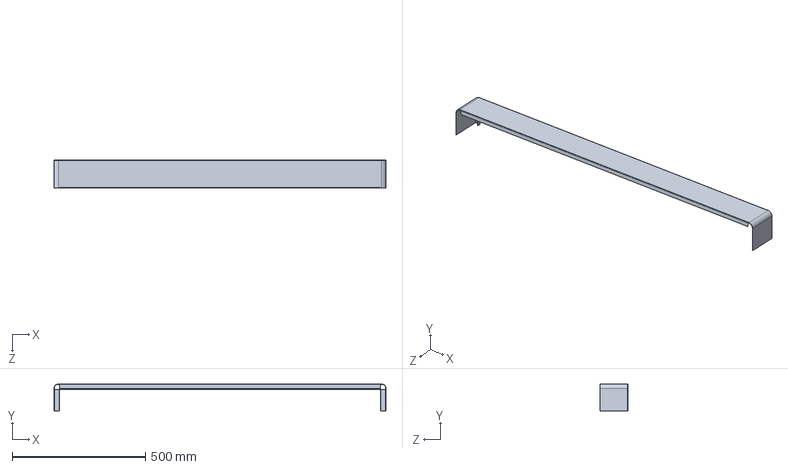
[picture p152: CAD file, 2024-04-19]
models/stand version/top surface LCD.SLDPRT
1244.0 x 101.0 x 105.0 mm
