nasser1245/Imona-Stand-Charger/models/StandV2/profiles/Bottom depth.SLDPRT

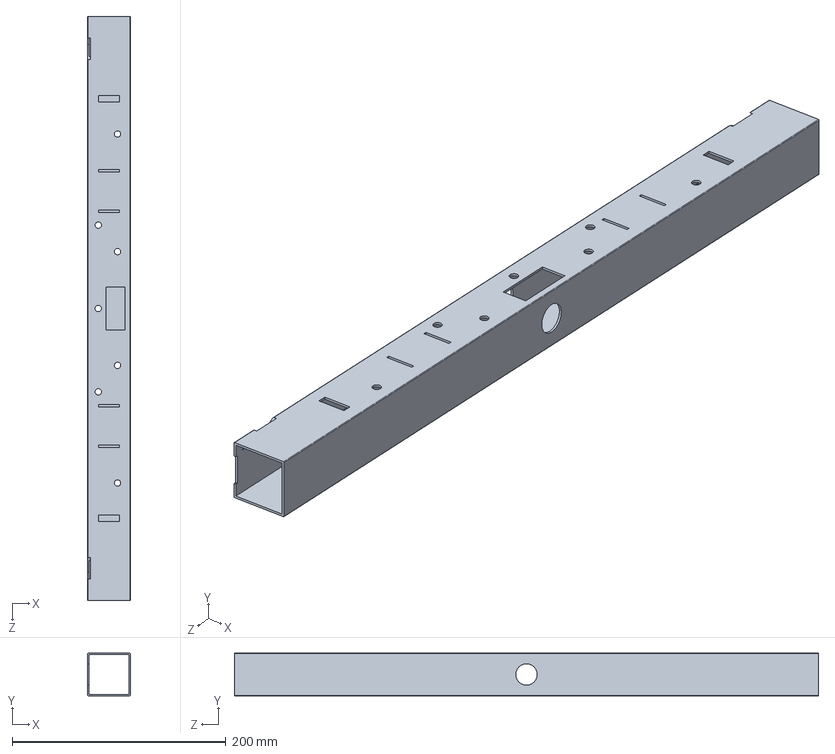
[picture p153: CAD file, 2024-04-19]
models/StandV2/profiles/Bottom depth.SLDPRT
40.0 x 40.0 x 546.5 mm
