nasser1245/Imona-Stand-Charger/models/StandV2/wheel mount.SLDPRT

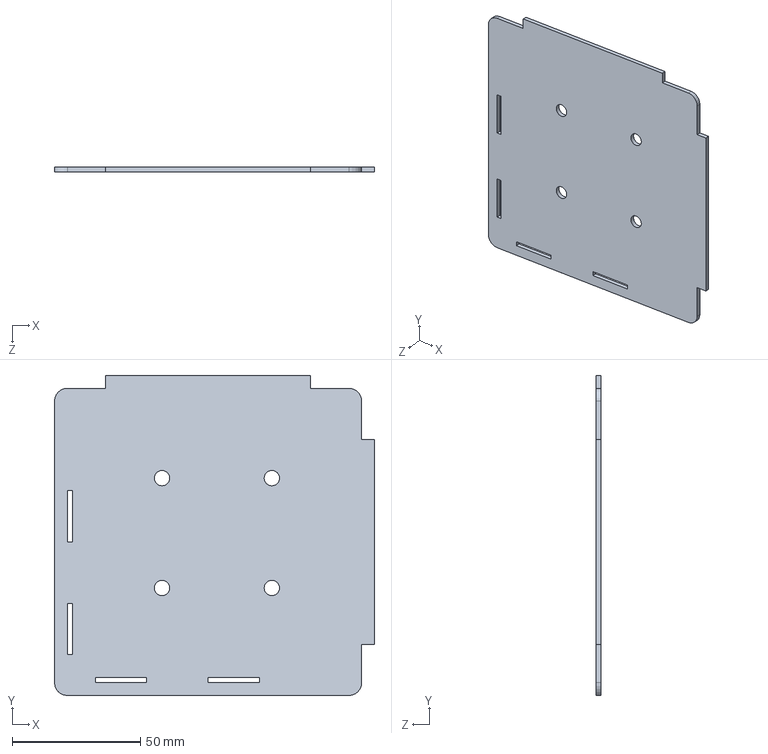
[picture p154: CAD file, 2024-04-19]
models/StandV2/wheel mount.SLDPRT
125.0 x 125.0 x 2.00 mm
