nasser1245/Imona-Stand-Charger/models/table version/front top surface-T- Card.SLDPRT

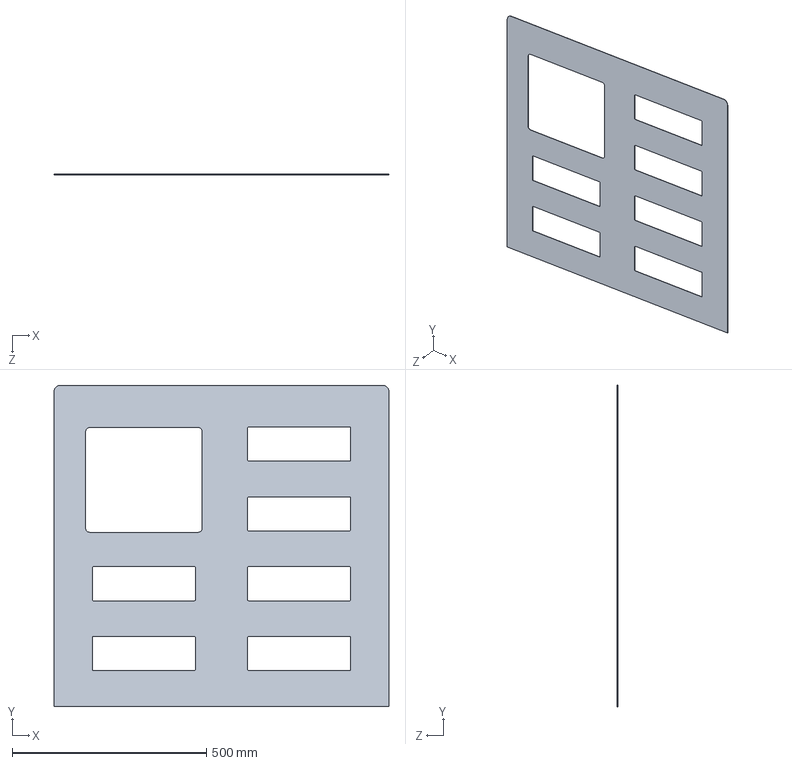
[picture p155: CAD file, 2024-04-19]
models/table version/front top surface-T- Card.SLDPRT
863.4 x 827.7 x 1.00 mm
