nasser1245/Imona-Stand-Charger/models/wall version/bottom cover-w.SLDPRT

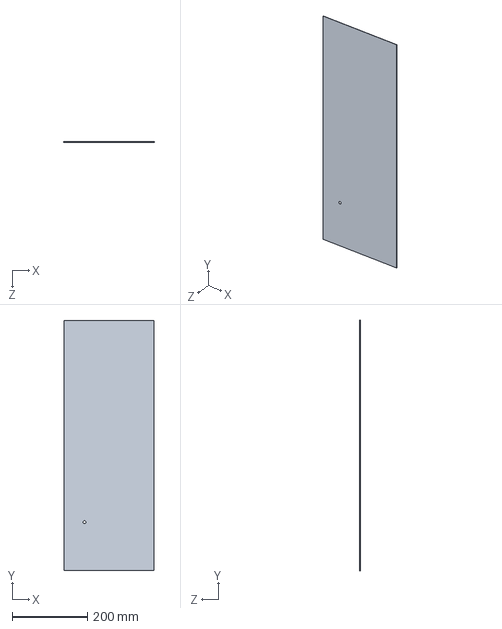
[picture p156: CAD file, 2024-04-19]
models/wall version/bottom cover-w.SLDPRT
240.0 x 663.4 x 0.7 mm
