nasser1245/Imona-Stand-Charger/library parts/POS shield pile.SLDPRT

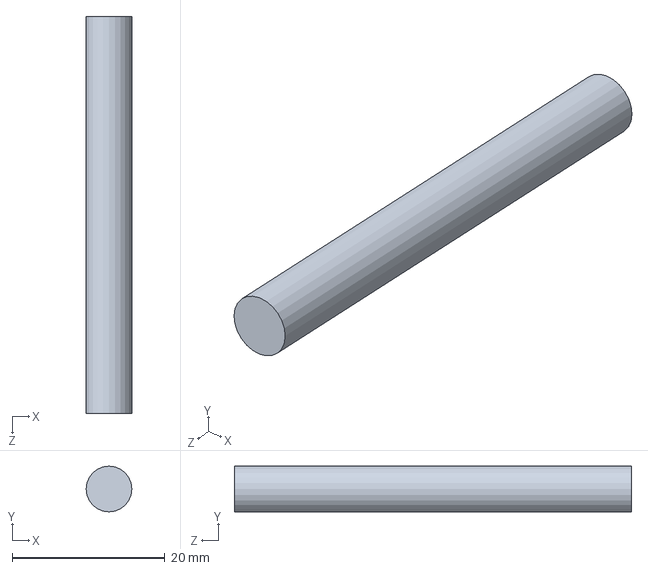
[picture p157: CAD file, 2024-04-19]
library parts/POS shield pile.SLDPRT
6.00 x 6.00 x 52.0 mm
