nasser1245/Imona-Stand-Charger/models/stand version-6mm/arm back plexi.SLDPRT

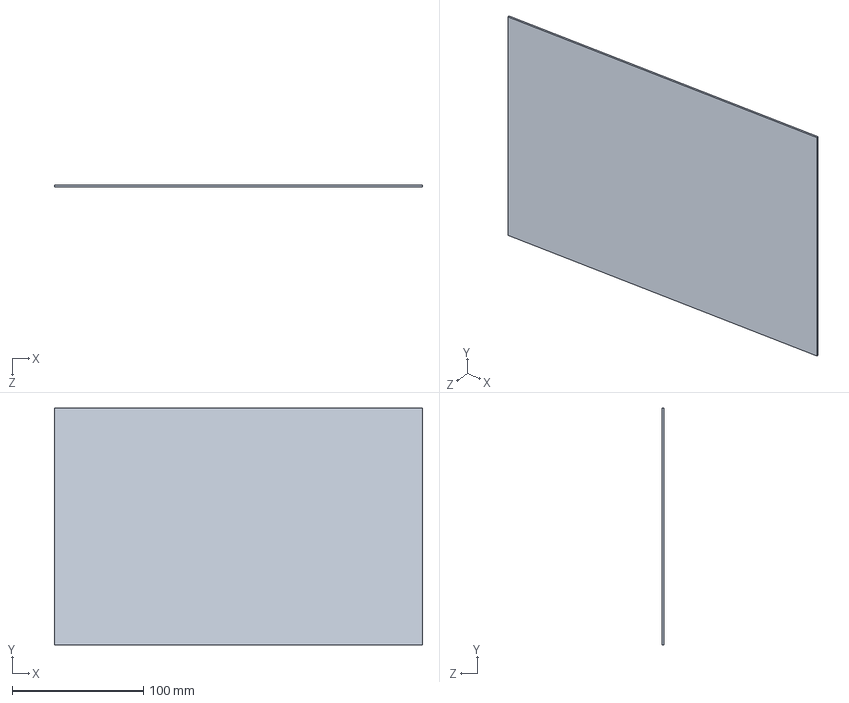
[picture p158: CAD file, 2024-04-19]
models/stand version-6mm/arm back plexi.SLDPRT
280.0 x 180.0 x 1.50 mm
