nasser1245/Imona-Stand-Charger/models/StandV2/floor surface.SLDPRT

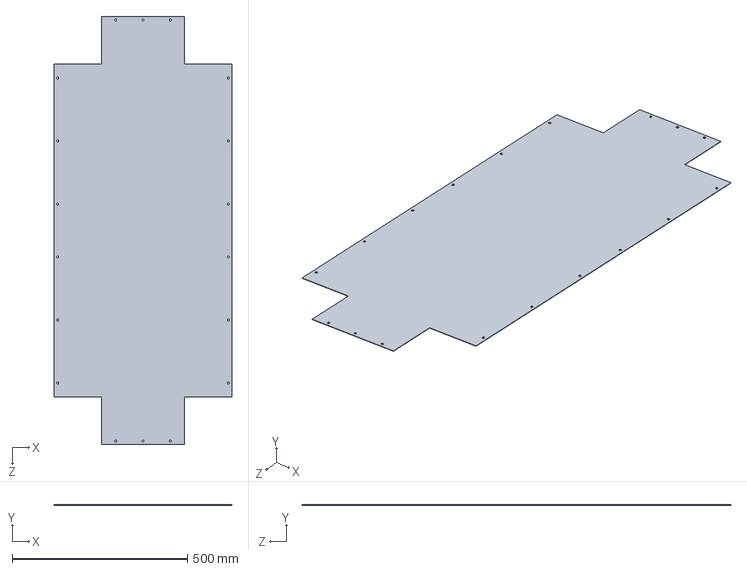
[picture p159: CAD file, 2024-04-19]
models/StandV2/floor surface.SLDPRT
506.5 x 1.00 x 1220.0 mm
