nasser1245/Imona-Stand-Charger/(list of files, cad)

Other CAD files:
models/stand version-6mm/stand version- chassis.SLDASM
models/StandV2/profiles/Height main thick front bottomR.SLDPRT
models/StandV2/profiles/Height main thick front bottom.SLDPRT
models/stand version-6mm/dwg/1mm-n1-top surface.DWG
models/stand version/dwg/1mm-n4-edge wrapper.DWG
models/stand version-6mm/dwg/4mm-n1-lcd frame.DWG
models/stand version/dwg/1mm-n1-bottom floor.DWG
models/stand version-6mm/dwg/1mm-n1-back cover.DWG
models/stand version/dwg/1.5mm-n2-infrastructure surface simple.DWG
models/stand version/Mirrorside surface bottom.SLDPRT
models/stand version-6mm/dwg/1mm-n2-back belt.DWG
models/stand version/dwg/1mm-n2-side surface back.DWG
models/stand version-6mm/dwg/1mm-n6-edge wrapper.DWG
models/stand version/dwg/1mm-N2-bottom surface.DWG
models/table version/side surface front-T.SLDPRT
models/wall version/side cover-w.SLDPRT
models/stand version-6mm/dwg/1mm-n1-bottom floor.DWG
models/stand version/dwg/1mm-n2-side surface.DWG
models/stand version-6mm/dwg/1mm-n2-side surface.DWG
models/stand version/dwg/1mm-n2-side cover.DWG
models/stand version-6mm/dwg/1mm-n2-side surface bottom.DWG
models/stand version/dwg/1mm-n1-bottom cover.DWG
models/wall version/top surface back-w.SLDPRT
models/stand version-6mm/dwg/1mm-n1-front top surface.DWG
models/stand version/bottom surface.SLDPRT
models/stand version/dwg/4mm-n1-lcd frame.DWG
models/table version/side surface back-T.SLDPRT
models/wall version/edge wrapper-w.SLDPRT
models/stand version-6mm/dwg/1mm-N2-bottom surface.DWG
models/stand version/dwg/1mm-n6-edge wrapper.DWG
models/table version/side surface front-T-v2.SLDPRT
models/stand version-6mm/dwg/1mm-n1-front bottom surface.DWG
models/stand version/dwg/1mm-n1-top cover big R.DWG
models/stand version/Mirrorside surface.SLDPRT
models/stand version-6mm/dwg/1mm-n2-side cover.DWG
models/stand version-6mm/profile.SLDPRT
models/stand version/dwg/1mm-n1-top surface back.DWG
models/stand version/side cover.SLDPRT
models/StandV2/profiles/center front.SLDPRT
models/table version/back cover.SLDPRT
models/stand version-6mm/dwg/1mm-N1-below door cover.DWG
models/stand version-6mm/Mirrorside surface bottom.SLDPRT
models/stand version/dwg/1mm-n2-front cover.DWG
models/table version/top surface front.SLDPRT
models/stand version-6mm/dwg/1mm-n2-side surface back.DWG
models/stand version-6mm/front top surface-card.SLDPRT
models/stand version/dwg/1mm-n1-back cover.DWG
models/stand version-6mm/dwg/1.5mm-n2-infrastructure surface simple.DWG
models/stand version/dwg/1mm-N1-below door cover.DWG
Documents/chasis holed drawing profiles/drill-depth main holed.SLDDRW
Documents/chasis holed drawing profiles/drill-depth small holed.SLDDRW
Documents/chasis holed drawing profiles/drill-height main locker mount.SLDDRW
Documents/chasis holed drawing profiles/drill-shelf depth.SLDDRW
Documents/chasis holed drawing profiles/drill-shelf width.SLDDRW
Documents/chasis holed drawing profiles/drillMill-door height lock.SLDDRW
Documents/chasis holed drawing profiles/mill-door height hinge.SLDDRW
Documents/chasis holed drawing profiles/mill-height main hinge.SLDDRW
Documents/chasis holed drawing profiles/skew-bottom skewed1.SLDDRW
Documents/chasis holed drawing profiles/skew-bottom skewed2.SLDDRW
Documents/chasis holed drawing profiles/skew-center front.SLDDRW
Documents/chasis holed drawing profiles/skew-skewed depth.SLDDRW
library parts/POS Solenoid Lock/M5 nut.SLDPRT
library parts/POS Solenoid Lock/lock holder nut.SLDPRT
library parts/POS Solenoid Lock/lock holder.SLDPRT
library parts/POS Solenoid Lock/plastic washer.SLDPRT
library parts/POS Solenoid Lock/selenoid spring lock.SLDPRT
library parts/rivet nut.SLDPRT
models/StandV2/backBottomSurface.SLDPRT
models/StandV2/front top surface-card.SLDPRT
models/StandV2/profiles/4040Sketch.SLDPRT
models/StandV2/profiles/Bottom width.SLDPRT
models/StandV2/profiles/Skewed depth right.SLDPRT
models/StandV2/profiles/Skewed depth.SLDPRT
models/StandV2/profiles/bottom Skewed1.SLDPRT
models/StandV2/profiles/bottom center down height.SLDPRT
models/StandV2/profiles/bottom center height right.SLDPRT
models/StandV2/profiles/bottom center height.SLDPRT
models/StandV2/profiles/bottom skewed2.SLDPRT
models/StandV2/profiles/door trig.SLDPRT
models/StandV2/profiles/door width.SLDPRT
models/StandV2/profiles/height sub.SLDPRT
models/StandV2/profiles/hinge holder.SLDPRT
models/StandV2/profiles/midJoint.SLDPRT
models/StandV2/profiles/middle sub back.SLDPRT
models/StandV2/profiles/middle sub backR.SLDPRT
models/StandV2/profiles/middle width subR.SLDPRT
models/StandV2/profiles/shelf depth.SLDPRT
models/StandV2/profiles/width sub.SLDPRT
models/stand version-6mm/Mirrorside surface.SLDPRT
models/stand version-6mm/dwg/1mm-n1-bottom cover.DWG
models/stand version-6mm/dwg/1mm-n1-top cover big R.DWG
models/stand version-6mm/dwg/1mm-n1-top surface back.DWG
models/stand version-6mm/dwg/1mm-n2-front cover.DWG
models/stand version-6mm/dwg/1mm-n4-edge wrapper.DWG
models/stand version-6mm/dwg/bottom surface.SLDDRW
models/stand version-6mm/dwg/front bottom surface.SLDDRW
models/stand version-6mm/dwg/front top surface.SLDDRW
models/stand version-6mm/dwg/infrastructure surface simple.SLDDRW
models/stand version-6mm/dwg/side surface back.SLDDRW
models/stand version-6mm/dwg/side surface bottom.SLDDRW
models/stand version-6mm/dwg/side surface.SLDDRW
models/stand version-6mm/dwg/top cover big R.SLDDRW
models/stand version-6mm/dwg/top surface back.SLDDRW
models/stand version-6mm/dwg/top surface.SLDDRW
models/stand version-6mm/edge wrapper.SLDPRT
models/stand version-6mm/front cover.SLDPRT
models/stand version-6mm/front top surface.SLDPRT
models/stand version-6mm/side surface back.SLDPRT
models/stand version-6mm/side surface.SLDPRT
models/stand version-6mm/temp front.DWG
models/stand version-6mm/temp front.SLDPRT
models/stand version-6mm/top cover big R.SLDPRT
models/stand version-6mm/top surface LCD.SLDPRT
models/stand version-6mm/top surface back.SLDPRT
models/stand version/caster wheel.step.SLDPRT
models/stand version/dwg/1mm-n1-front bottom surface.DWG
models/stand version/dwg/1mm-n1-front top surface.DWG
models/stand version/dwg/1mm-n1-top surface.DWG
models/stand version/dwg/1mm-n2-back belt.DWG
models/stand version/dwg/1mm-n2-side surface bottom.DWG
models/stand version/dwg/bottom surface.SLDDRW
models/stand version/dwg/front bottom surface.SLDDRW
models/stand version/dwg/front top surface.SLDDRW
models/stand version/dwg/infrastructure surface simple.SLDDRW
models/stand version/dwg/side surface back.SLDDRW
models/stand version/dwg/side surface bottom.SLDDRW
models/stand version/dwg/side surface.SLDDRW
models/stand version/dwg/top cover big R.SLDDRW
models/stand version/dwg/top surface back.SLDDRW
models/stand version/dwg/top surface.SLDDRW
models/stand version/edge wrapper.SLDPRT
models/stand version/front bottom surface.SLDPRT
models/stand version/front top surface-card.SLDPRT
models/stand version/top cover big R.SLDPRT
models/stand version/top surface back.SLDPRT
models/table version/top cover big-T.SLDPRT
models/wall version/front top surface-w.SLDPRT
models/wall version/profile wall.SLDPRT
models/wall version/side surface back-W-v2.SLDPRT
models/wall version/side surface back-W.SLDPRT
