nasser1245/Imona-Stand-Charger/Documents/stand version bends/all-merged.pdf

B B

# UP 90° R 1

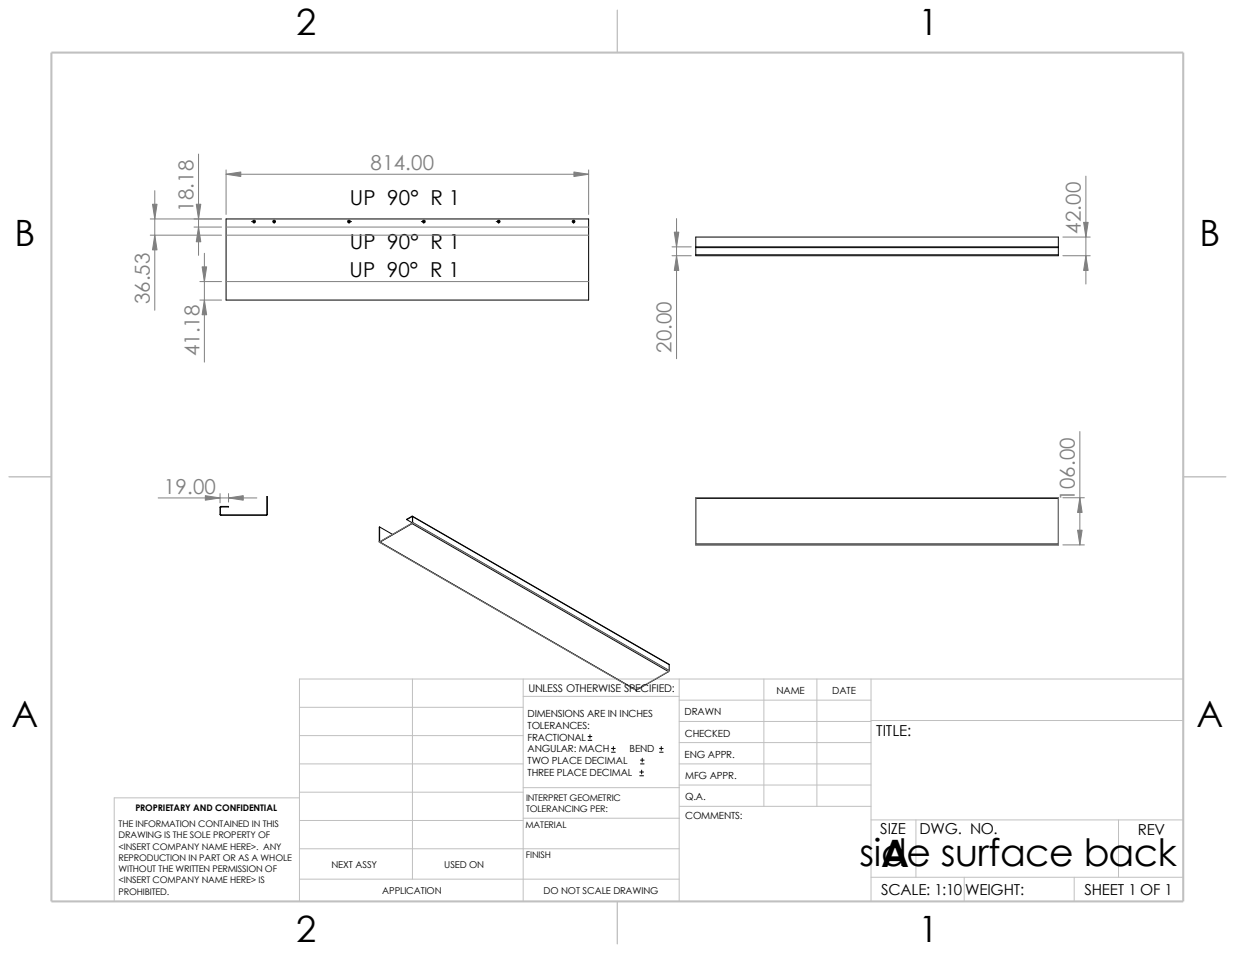
[picture p179: page 1]
COMMENTS:; INTERPRET GEOMETRIC; PROPRIETARY AND CONFIDENTIAL; TOLERANCING PER:

UNLESS OTHERWISE SPECIFIED: | | NAME | DATE

DIMENSIONS ARE IN INCHES TOLERANCES: FRACTIONAL ANGULAR: MACH BEND TWO PLACE DECIMAL THREE PLACE DECIMAL | DRAWN

CHECKED | | | TITLE:

ENG APPR.
MFG APPR.

THE INFORMATION CONTAINED IN THIS
DRAWING IS THE SOLE PROPERTY OF
<INSERT COMPANY NAME HERE>. ANY
REPRODUCTION IN PART OR AS A WHOLE
WITHOUT THE WRITTEN PERMISSION OF
<INSERT COMPANY NAME HERE> IS
PROHIBITED.

MATERIAL | side surface back | SIZE A | DWG. NO. | REV

NEXT ASSY | USED ON | FINISH

APPLICATION | DO NOT SCALE DRAWING | | SCALE: 1:10 WEIGHT: | | SHEET 1 OF 1

B B

451.00 754.23

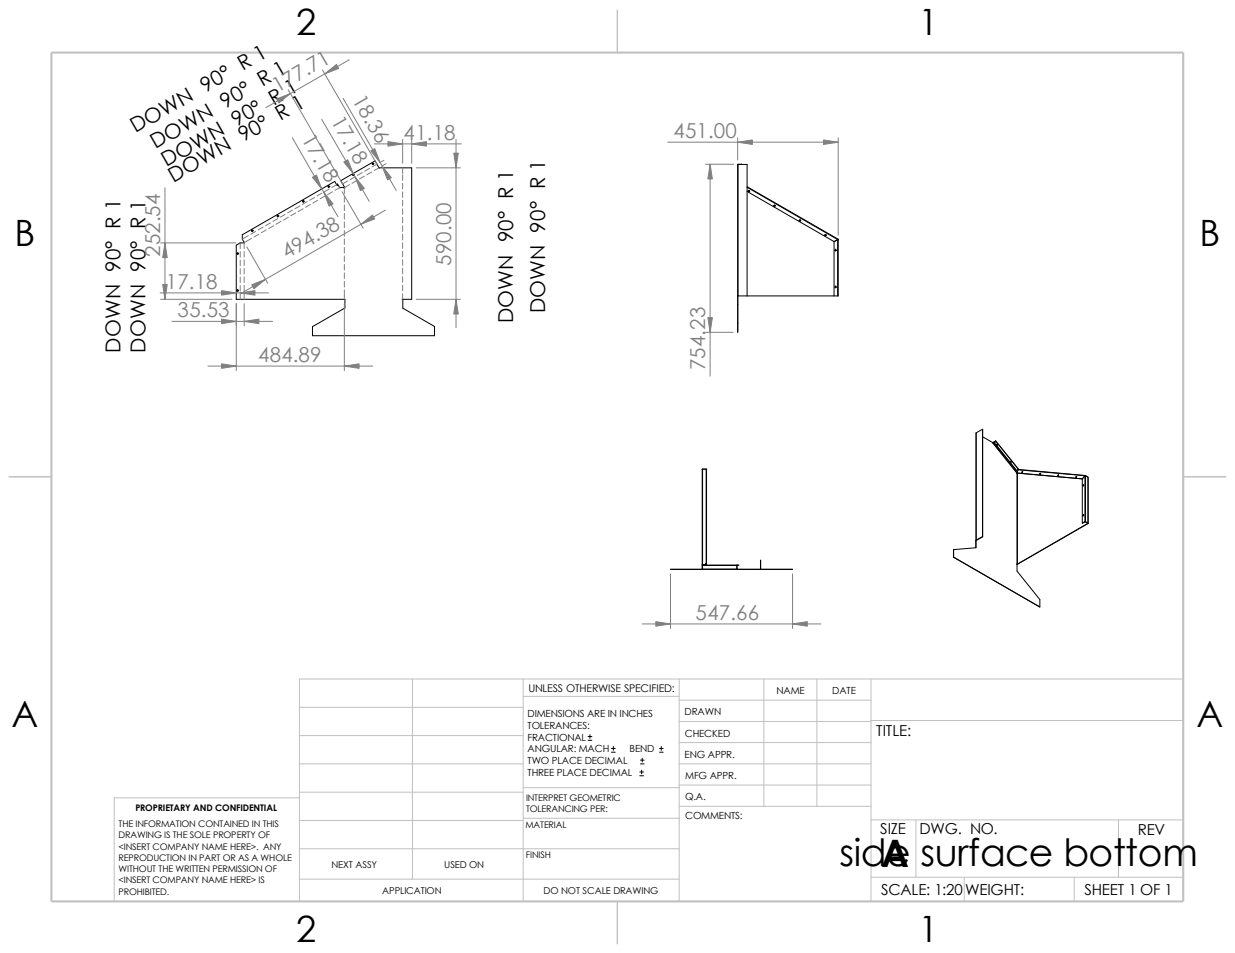
[picture p180: page 2]
COMMENTS:; INTERPRET GEOMETRIC; PROPRIETARY AND CONFIDENTIAL; TOLERANCING PER:; DOWN 90° R 1 DOWN 90° R 1; 35.53 ²⁵².54

DOWN 90° R 1 DOWN 90° R 1 DOWN 90° R 1

UNLESS OTHERWISE SPECIFIED: | | NAME | DATE

DIMENSIONS ARE IN INCHES TOLERANCES: FRACTIONAL ANGULAR: MACH BEND TWO PLACE DECIMAL THREE PLACE DECIMAL | DRAWN

CHECKED | | | TITLE:

ENG APPR.
MFG APPR.

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

MATERIAL | | SIZE A | DWG. NO. | REV

side surface bottom

NEXT ASSY | USED ON | FINISH

SCALE: 1:20WEIGHT:

B B

# UP 90° R 1

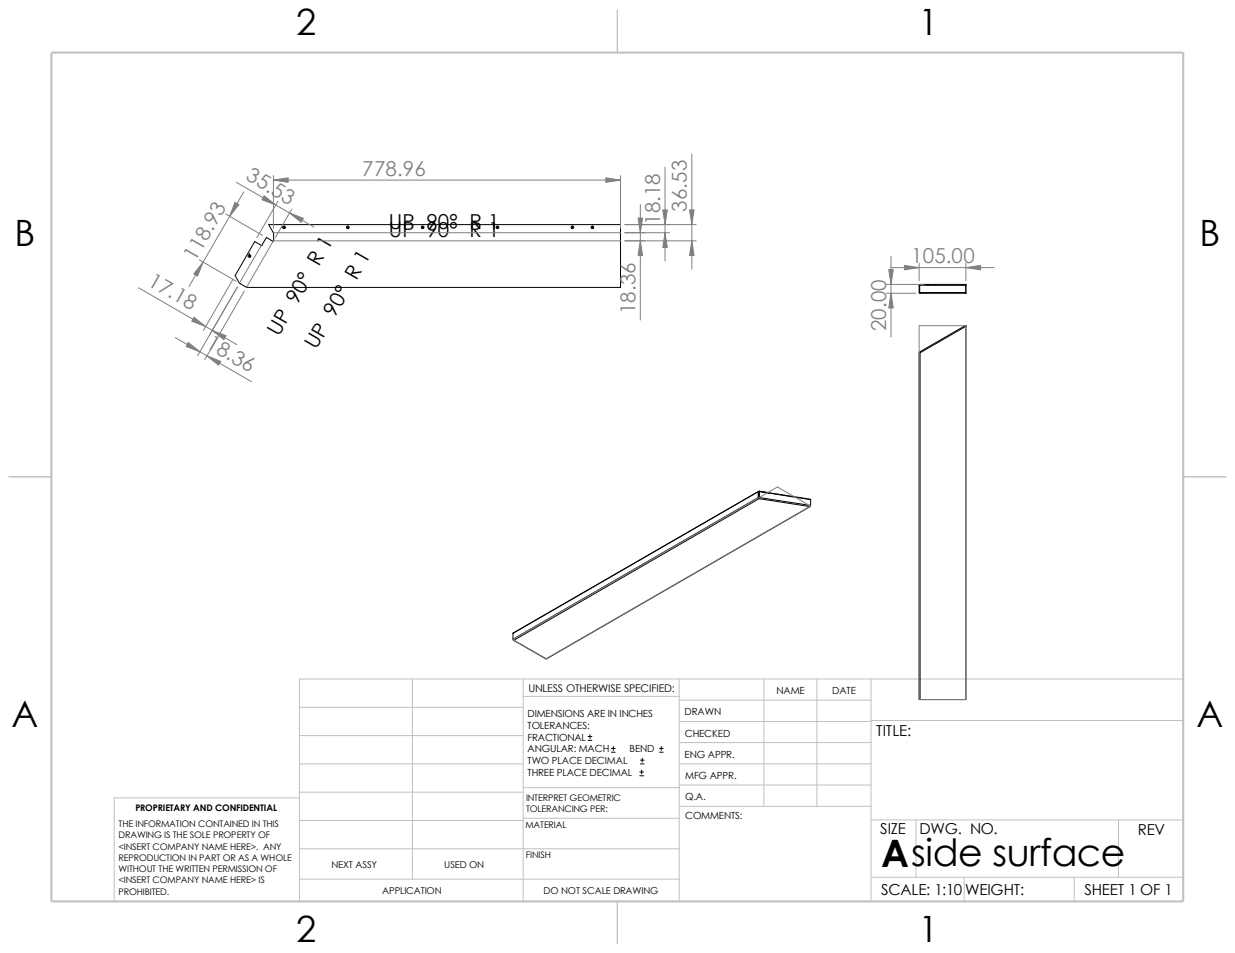
[picture p181: page 3]
COMMENTS:; INTERPRET GEOMETRIC; PROPRIETARY AND CONFIDENTIAL; TOLERANCING PER:

UNLESS OTHERWISE SPECIFIED: | | NAME | DATE

DIMENSIONS ARE IN INCHES TOLERANCES: FRACTIONAL ANGULAR: MACH BEND TWO PLACE DECIMAL THREE PLACE DECIMAL | DRAWN

CHECKED | | | TITLE:

ENG APPR.
MFG APPR.

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

MATERIAL | | SIZE A side surface | DWG. NO. | REV

NEXT ASSY | USED ON | FINISH

B B

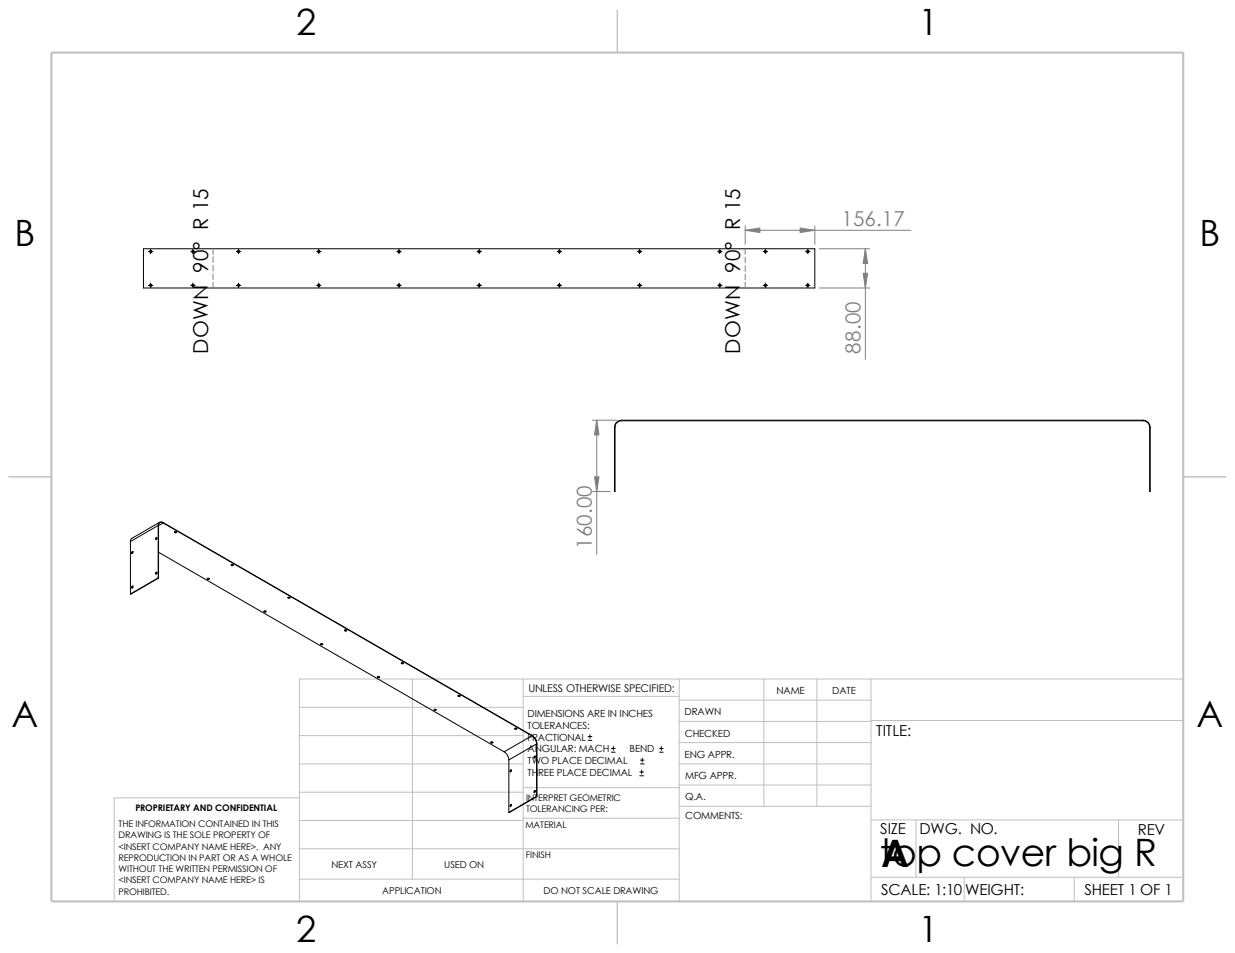
[picture p182: page 4]
COMMENTS:; BEND; INTERPRET GEOMETRIC; PROPRIETARY AND CONFIDENTIAL; TOLERANCING PER:; PROHIBITED.; DOWN ⁹⁰° R 15

UNLESS OTHERWISE SPECIFIED: | | NAME | DATE

DIMENSIONS ARE IN INCHES TOLERANCES: FRACTIONAL ANGULAR: MACH TWO PLACE DECIMAL THREE PLACE DECIMAL | DRAWN

CHECKED | | | TITLE:

ENG APPR.
MFG APPR.

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

MATERIAL | | SIZE top cover big R A | DWG. NO. | REV

NEXT ASSY | USED ON | FINISH

B B

UP 90° R 1 | UP 90° R 15 UP 90° | R 1 | UP 90° | R 1 UP 90° R 1

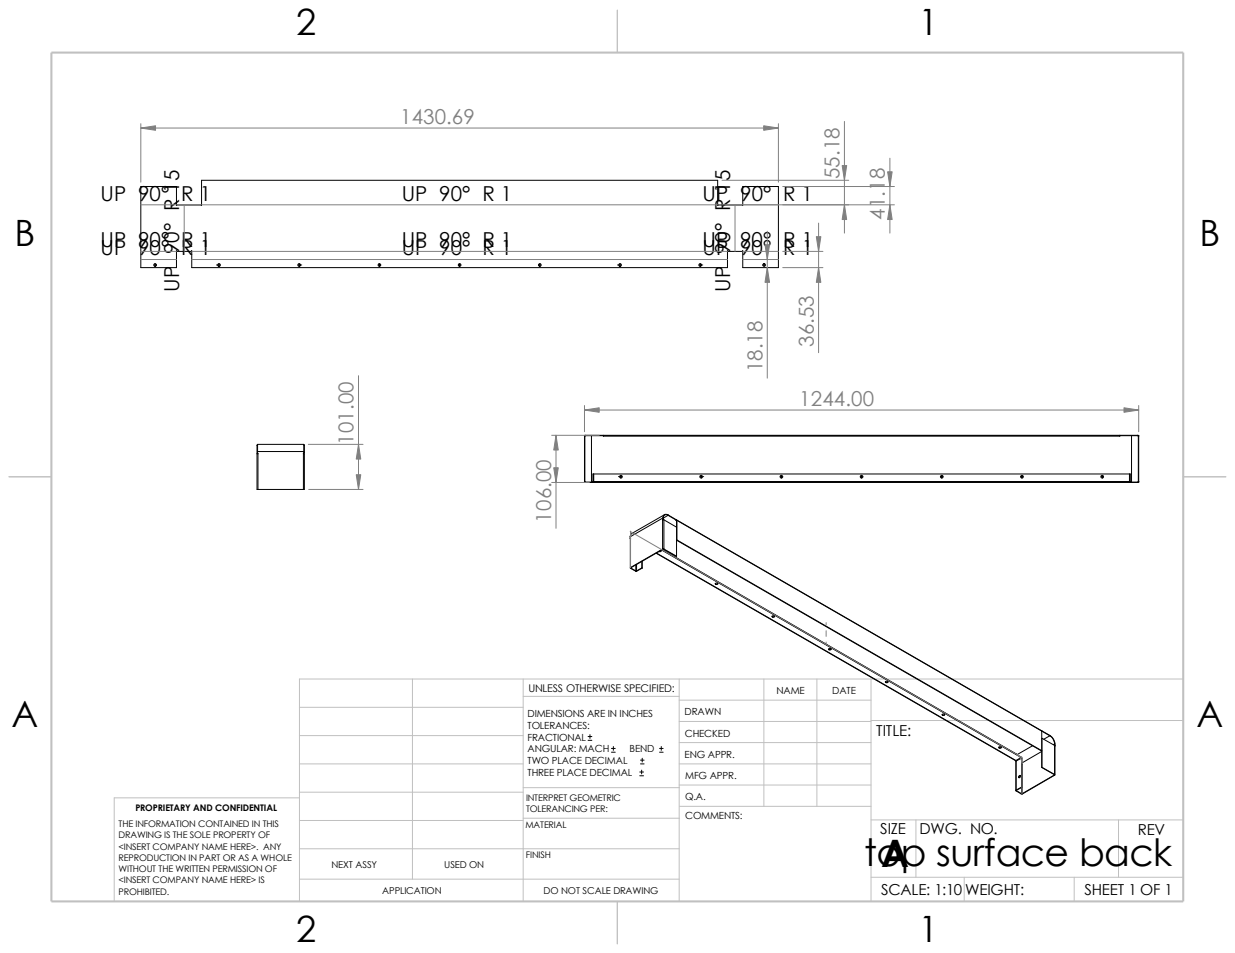
[picture p183: page 5]
TITLE:; COMMENTS:; INTERPRET GEOMETRIC; PROPRIETARY AND CONFIDENTIAL; TOLERANCING PER:

UNLESS OTHERWISE SPECIFIED: | | NAME | DATE

DIMENSIONS ARE IN INCHES TOLERANCES: FRACTIONAL ANGULAR: MACH BEND TWO PLACE DECIMAL THREE PLACE DECIMAL | DRAWN

CHECKED
ENG APPR.
MFG APPR.

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

MATERIAL | top surface back | SIZE A | DWG. NO. | REV

NEXT ASSY | USED ON | FINISH

B B

# 1244.00 20.00 20.00 UP 90° R 1

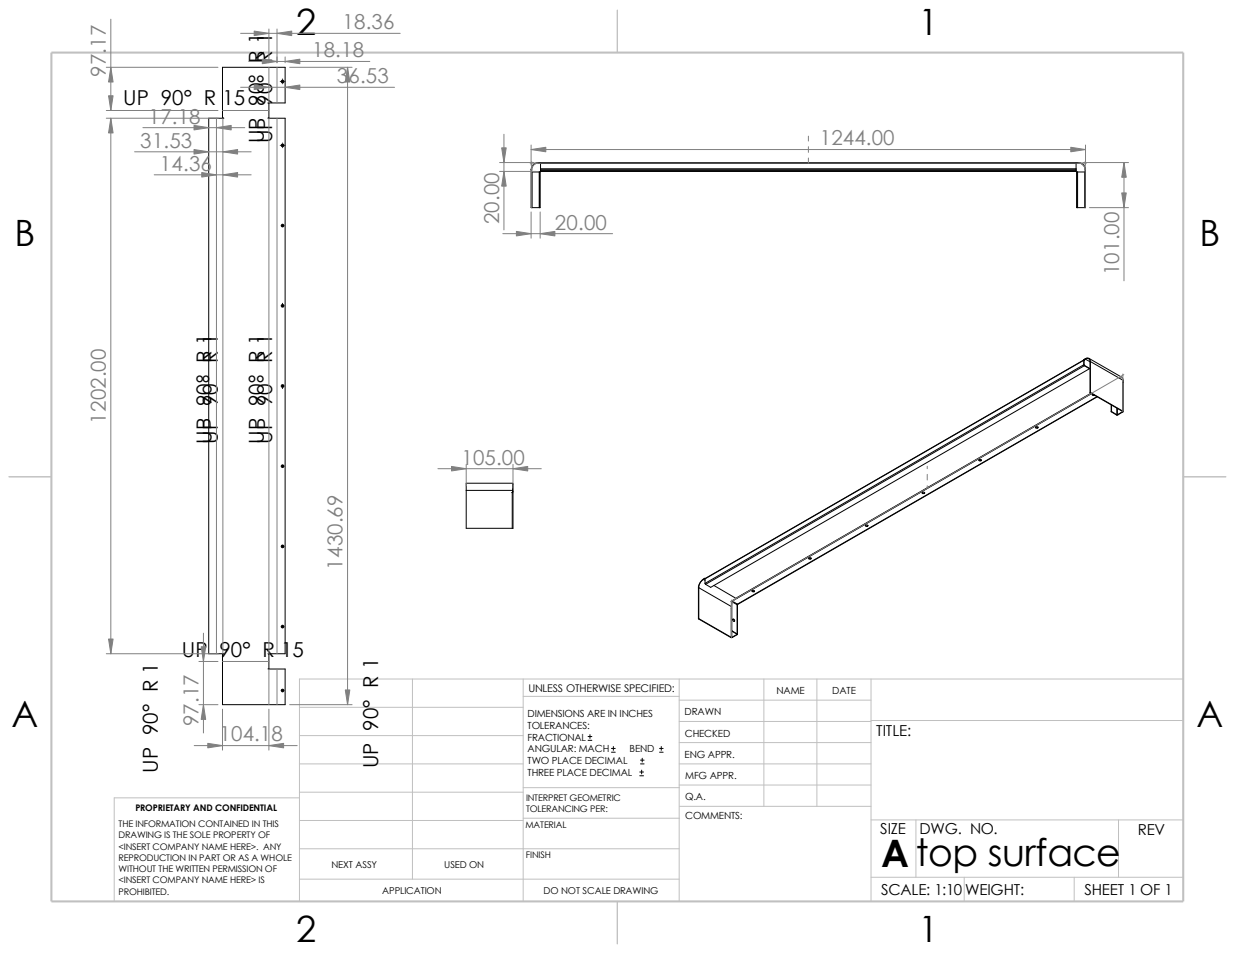
[picture p184: page 6]
COMMENTS:; INTERPRET GEOMETRIC; PROPRIETARY AND CONFIDENTIAL; TOLERANCING PER:; PROHIBITED.

UNLESS OTHERWISE SPECIFIED: | | NAME | DATE

DIMENSIONS ARE IN INCHES TOLERANCES: FRACTIONAL ANGULAR: MACH BEND TWO PLACE DECIMAL THREE PLACE DECIMAL | DRAWN

CHECKED | | | TITLE:

ENG APPR.
MFG APPR.

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

MATERIAL | | SIZE A | DWG. NO. top surface | REV

NEXT ASSY | USED ON | FINISH

DO NOT SCALE DRAWING | | SCALE: 1:10 | WEIGHT: | SHEET 1 OF 1

B B

39.71 39.66 | 162.28

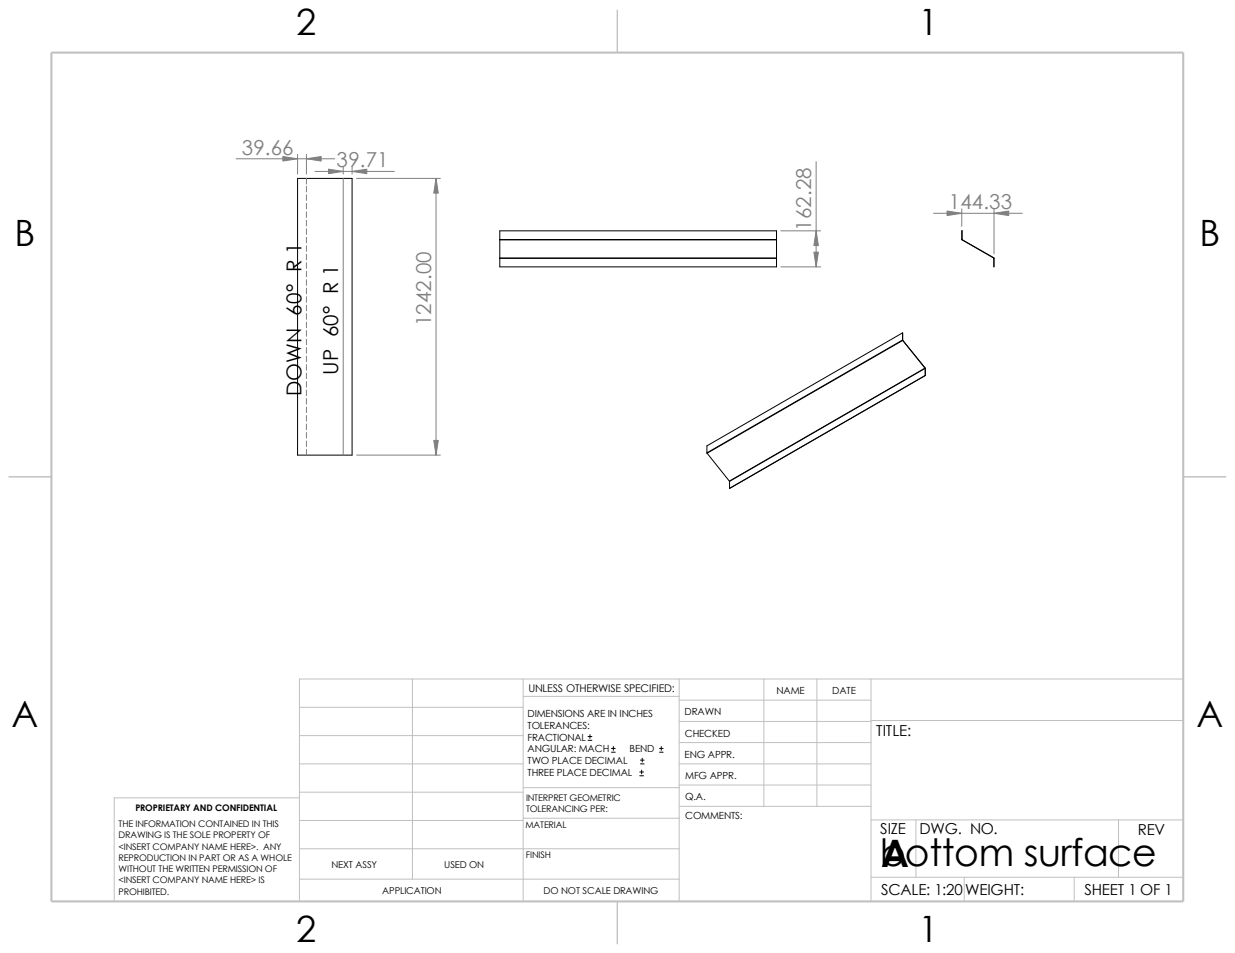
[picture p185: page 7]
COMMENTS:; INTERPRET GEOMETRIC; PROPRIETARY AND CONFIDENTIAL; TOLERANCING PER:; 144.33 UP 60° R 1 DOWN ⁶⁰° R 1

UNLESS OTHERWISE SPECIFIED: | | NAME | DATE

DIMENSIONS ARE IN INCHES TOLERANCES: FRACTIONAL ANGULAR: MACH BEND TWO PLACE DECIMAL THREE PLACE DECIMAL | DRAWN

CHECKED | | | TITLE:

ENG APPR.
MFG APPR.

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

MATERIAL | | SIZE bottom surface A | DWG. NO. | REV

NEXT ASSY | USED ON | FINISH

SCALE: 1:20WEIGHT:

B B

# 234.00 ⁶⁴⁶.00 DOWN ⁹⁰° R 1

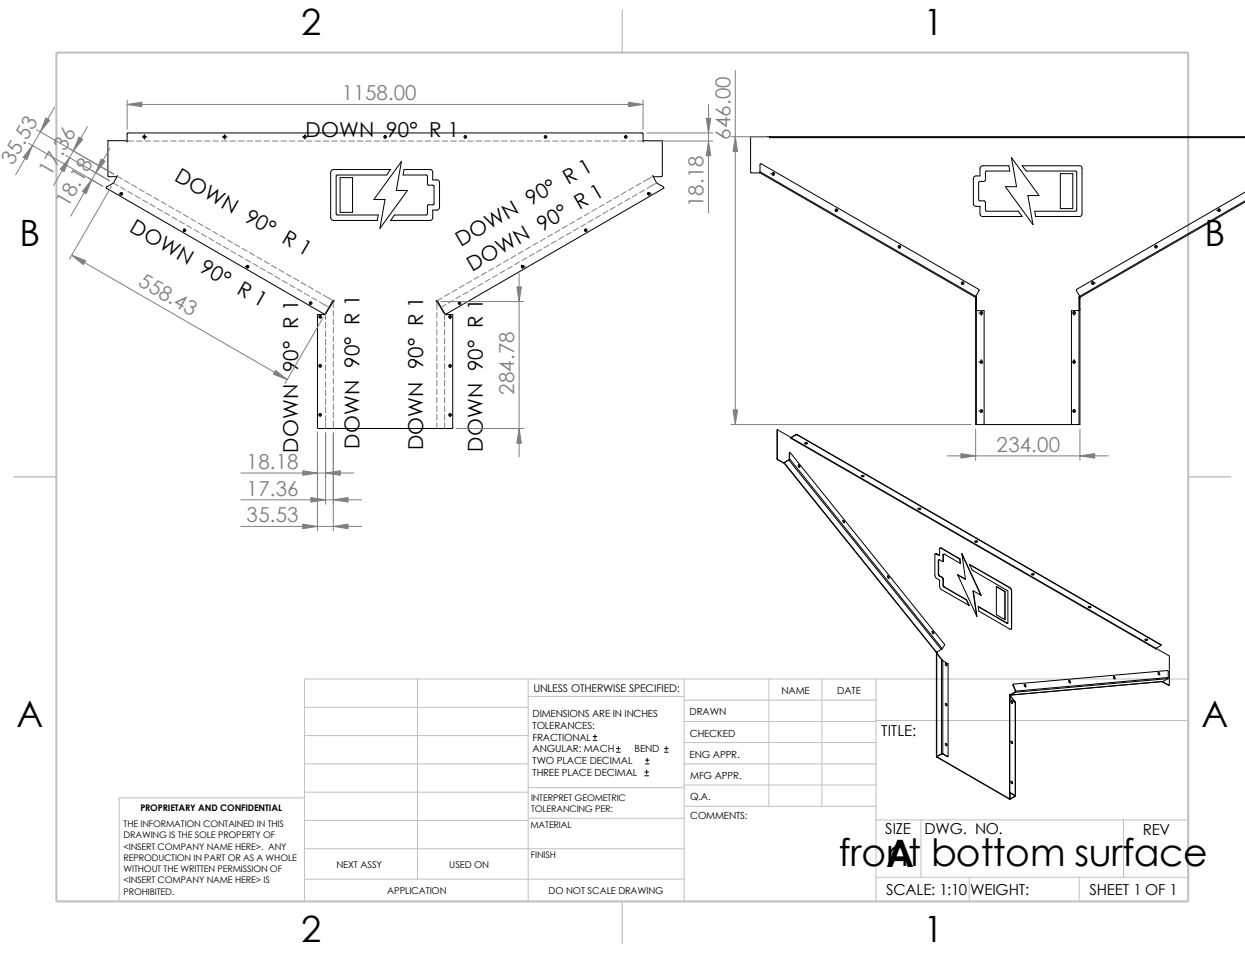
[picture p186: page 8]
TITLE:; COMMENTS:; INTERPRET GEOMETRIC; PROPRIETARY AND CONFIDENTIAL; TOLERANCING PER:; DOWN 90° R 1 DOWN 90° R 1; DOWN 90°; R 1 DOWN 90° R 1; DOWN 90° R 1; DOWN 90° R 1 17.36

UNLESS OTHERWISE SPECIFIED: | | NAME | DATE

DIMENSIONS ARE IN INCHES TOLERANCES: FRACTIONAL ANGULAR: MACH BEND TWO PLACE DECIMAL THREE PLACE DECIMAL | DRAWN

CHECKED
ENG APPR.
MFG APPR.

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

MATERIAL | | SIZE A | DWG. NO. | REV

front bottom surface

NEXT ASSY | USED ON | FINISH

B B

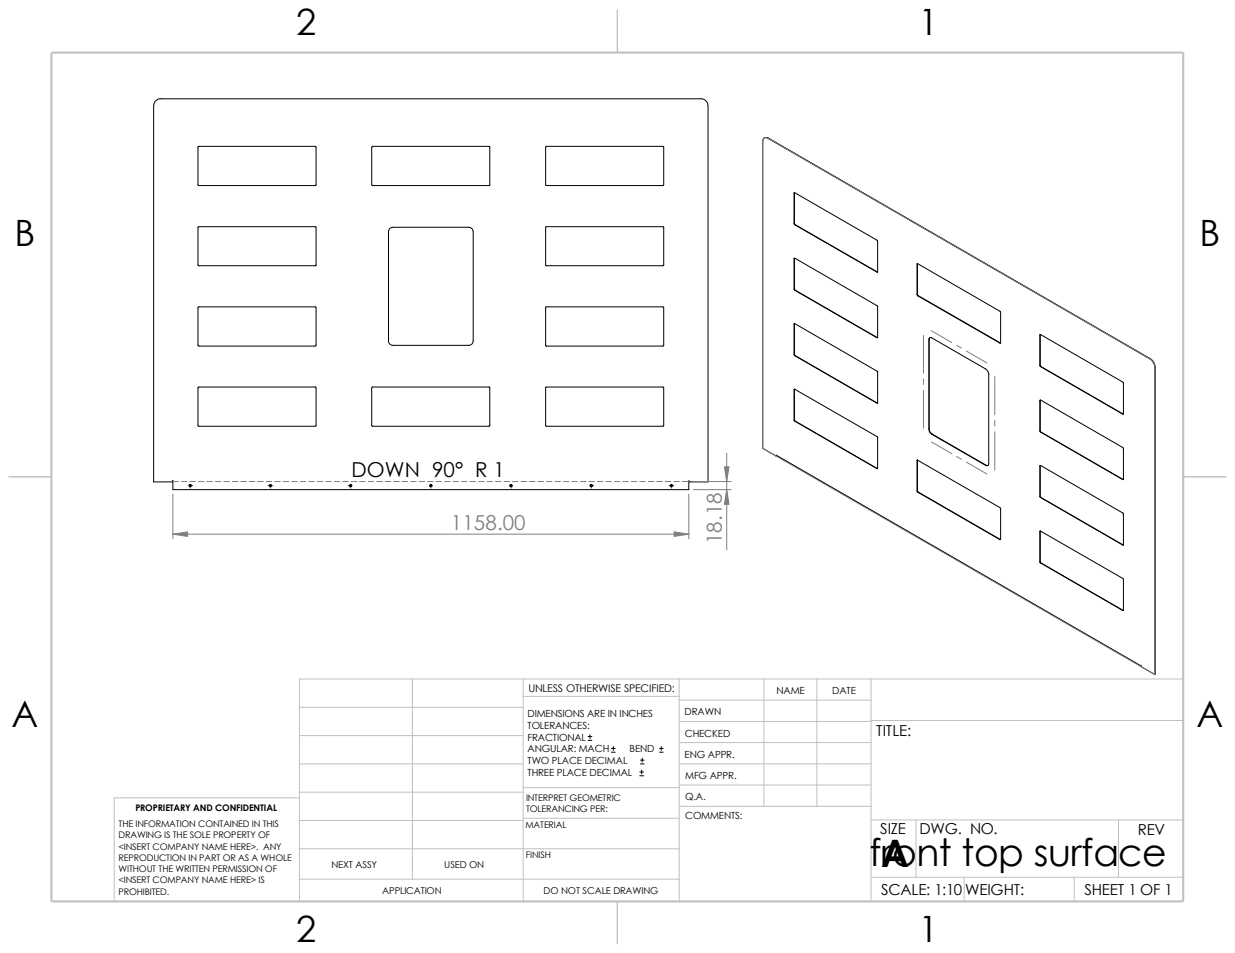
[picture p187: page 9]
COMMENTS:; INTERPRET GEOMETRIC; PROPRIETARY AND CONFIDENTIAL; TOLERANCING PER:; DOWN 90° R 1

UNLESS OTHERWISE SPECIFIED: | | NAME | DATE

DIMENSIONS ARE IN INCHES TOLERANCES: FRACTIONAL ANGULAR: MACH BEND TWO PLACE DECIMAL THREE PLACE DECIMAL | DRAWN

CHECKED | | | TITLE:

ENG APPR.
MFG APPR.

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

MATERIAL | | SIZE front top surface A | DWG. NO. | REV

NEXT ASSY | USED ON | FINISH

B B

# UP 90° R 2

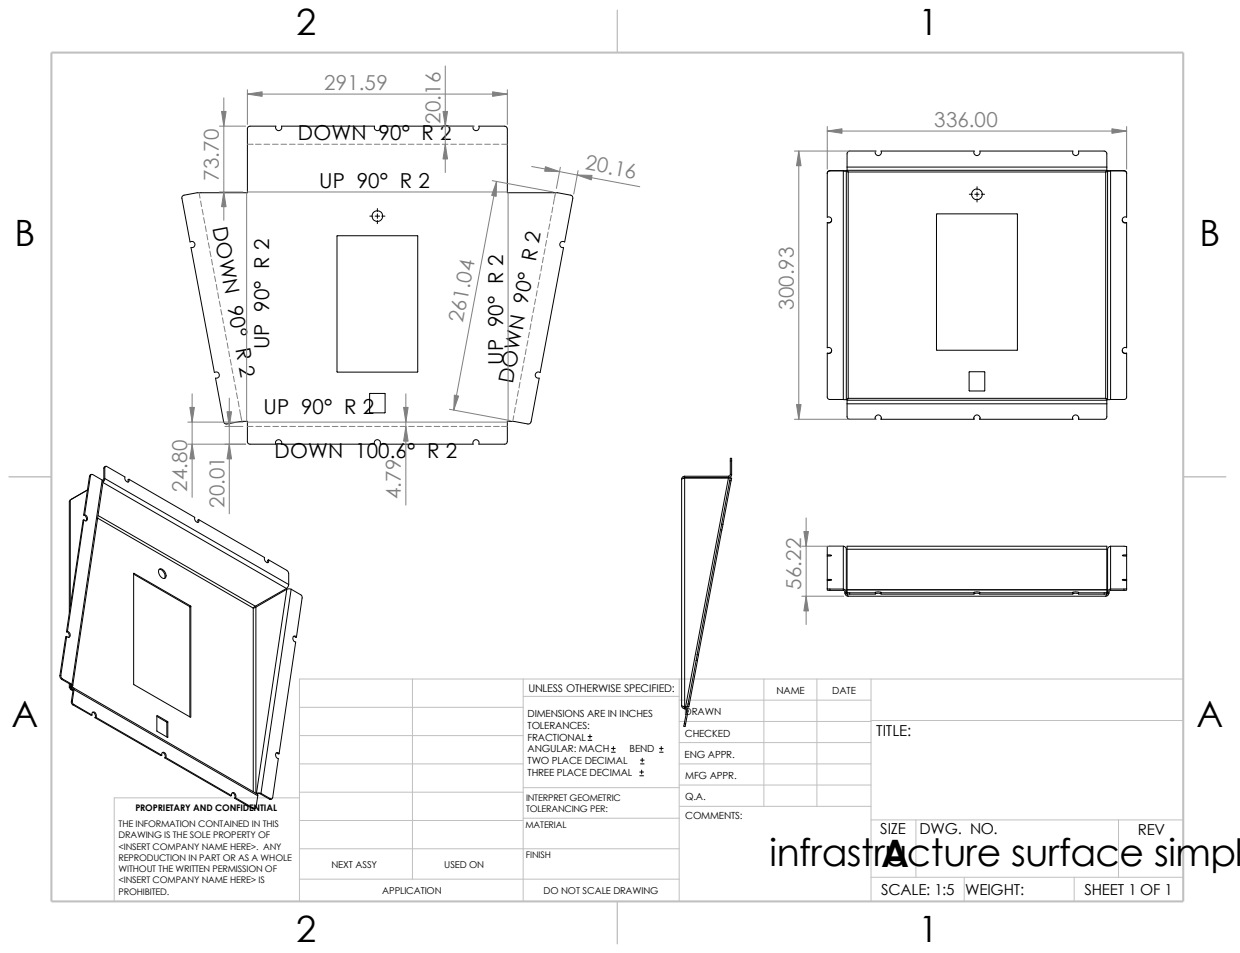
[picture p188: page 10]
336.00 300.93 56.22 UP 90° R 2 DOW; DOWN 100.6° R 2; DOW; DOWN 90° R 2

UNLESS OTHERWISE SPECIFIED: | | NAME | DATE

DIMENSIONS ARE IN INCHES TOLERANCES: FRACTIONAL ANGULAR: MACH BEND TWO PLACE DECIMAL THREE PLACE DECIMAL | DRAWN

CHECKED | | | TITLE:

ENG APPR.
MFG APPR.

INTERPRET GEOMETRIC TOLERANCING PER: | Q.A.
MATERIAL | | SIZE A | DWG. NO. | REV

PROPRIETARY AND CONFIDENTIAL
THE INFORMATION CONTAINED IN THIS
DRAWING IS THE SOLE PROPERTY OF
<INSERT COMPANY NAME HERE>. ANY
REPRODUCTION IN PART OR AS A WHOLE
WITHOUT THE WRITTEN PERMISSION OF

COMMENTS:
infrastructure surface simple

NEXT ASSY | USED ON | FINISH

SCALE: 1:5 | WEIGHT:
