nasser1245/Imona-Stand-Charger/Documents/chasis holed drawing profiles/pdf/drill-1-height main locker mount.pdf

B B

2

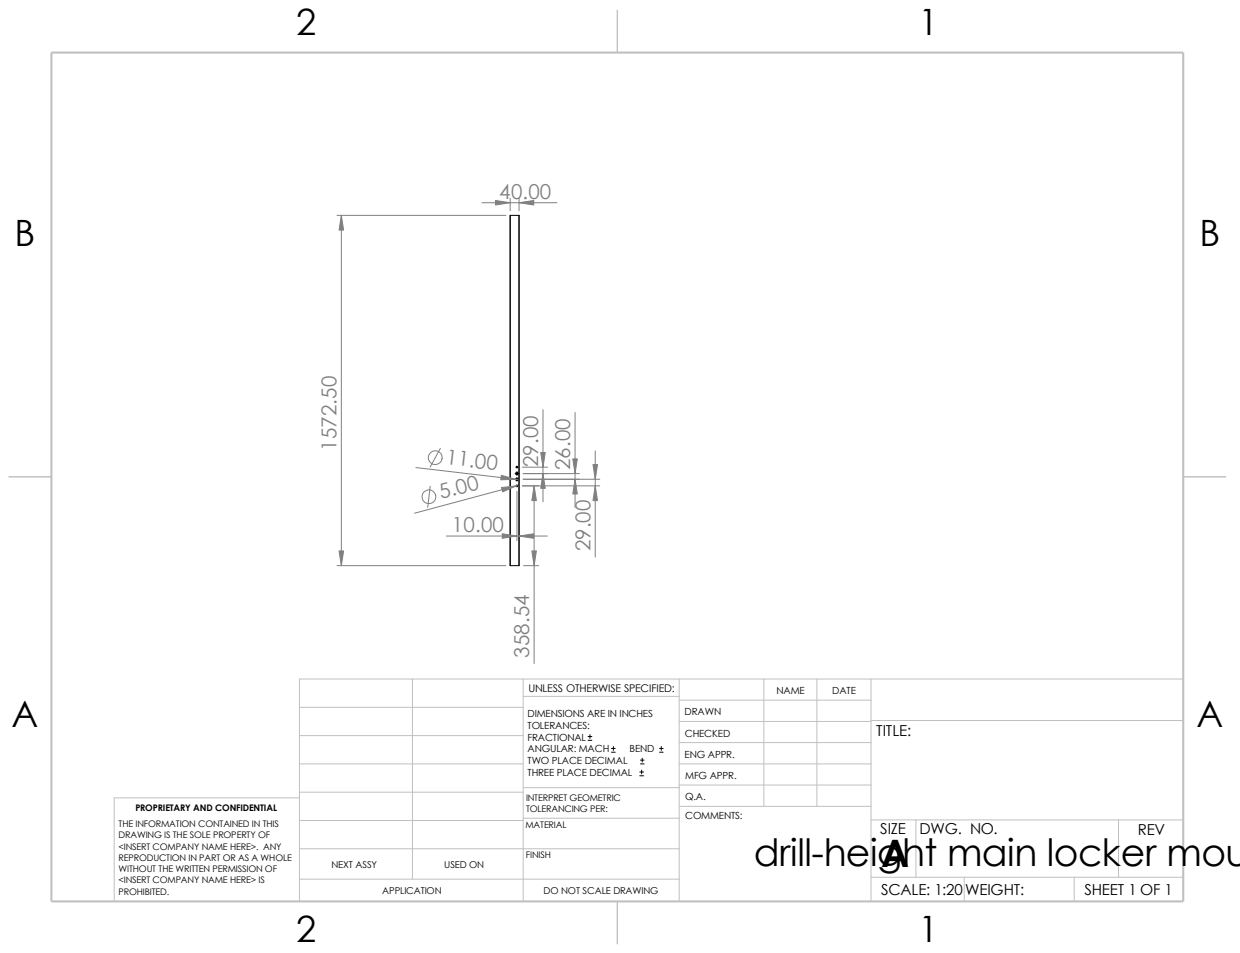
[picture p189: page 1]
INTERPRET GEOMETRIC; PROPRIETARY AND CONFIDENTIAL; TOLERANCING PER:; PROHIBITED.; 10.00 ¹⁵⁷².50

UNLESS OTHERWISE SPECIFIED: | | NAME | DATE

DIMENSIONS ARE IN INCHES TOLERANCES: FRACTIONAL ANGULAR: MACH BEND TWO PLACE DECIMAL THREE PLACE DECIMAL | DRAWN

CHECKED | | | TITLE:

ENG APPR.
MFG APPR.

COMMENTS:
drill-height main locker mount

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

MATERIAL | | SIZE A | DWG. NO. | REV

NEXT ASSY | USED ON | FINISH

APPLICATION | DO NOT SCALE DRAWING | | SCALE: 1:20WEIGHT: | | SHEET 1 OF 1
