nasser1245/Imona-Stand-Charger/electroparts/fast charger/bottom layer backup.pdf

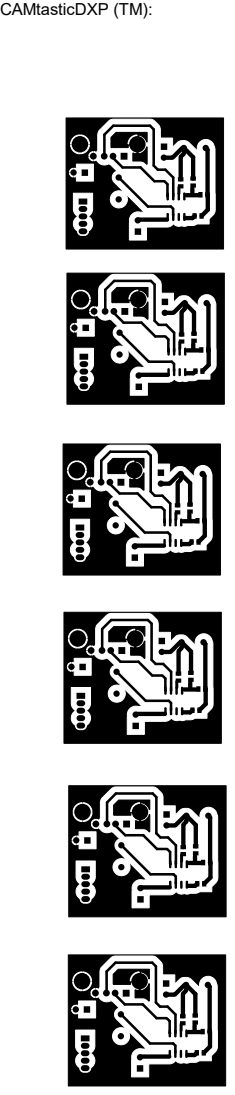
[picture p190: page 1]
CAMtasticDXP (TM):
