nasser1245/Imona-Stand-Charger/electroparts/fast charger/bottom layer.pdf

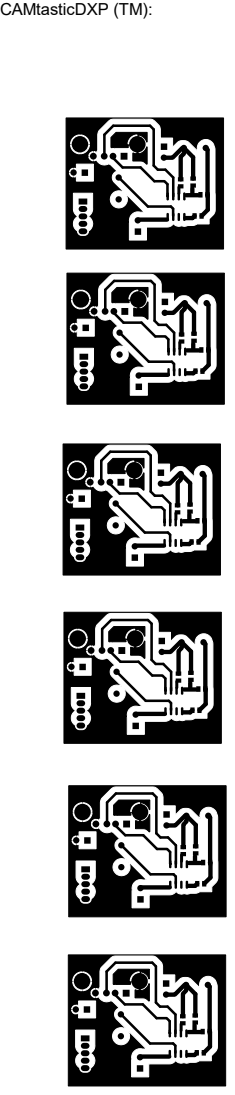
[picture p191: page 1]
CAMtasticDXP (TM):
