nasser1245/Imona-Stand-Charger/electroparts/fast charger/top and bottom layers.pdf

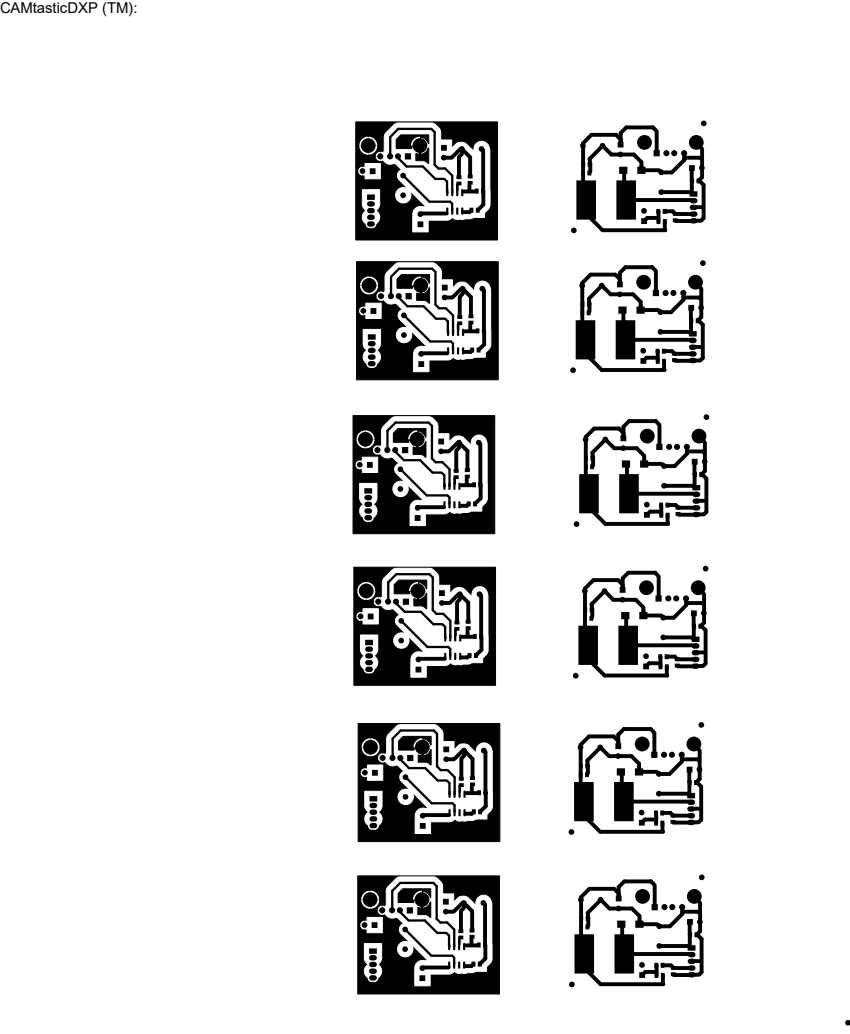
[picture p192: page 1]
CAMtasticDXP (TM):
