nasser1245/Imona-Stand-Charger/electroparts/fast charger/top layer reversed.pdf

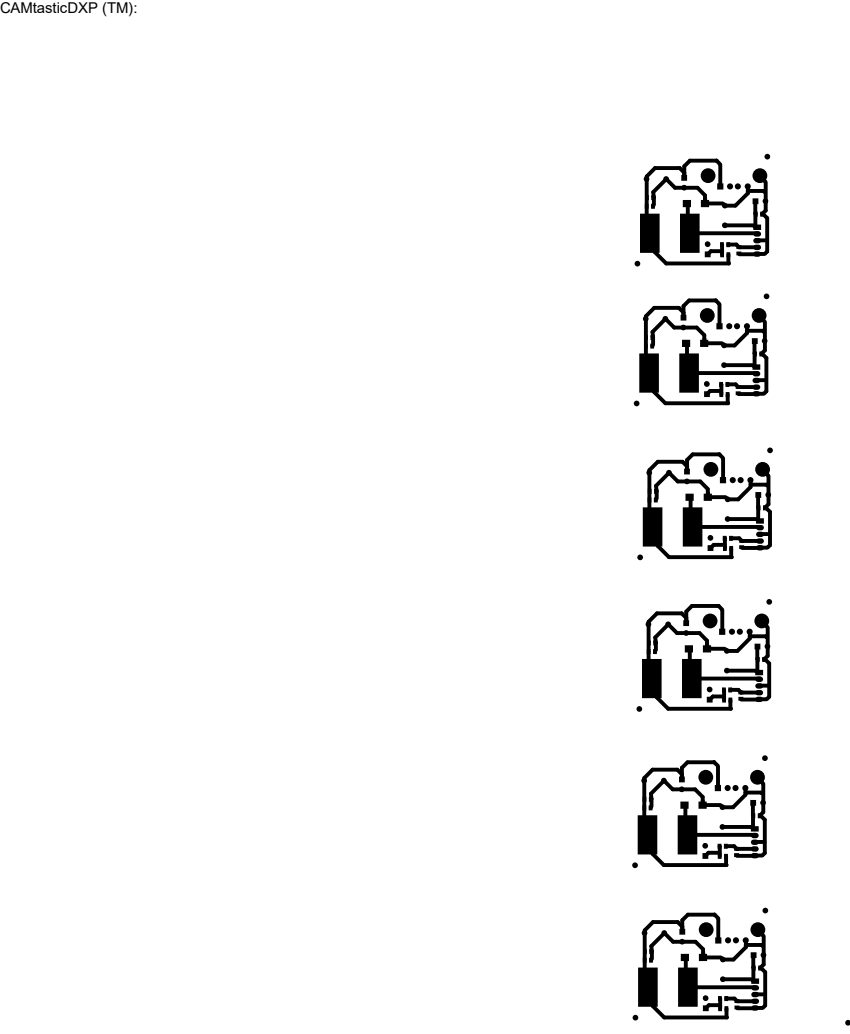
[picture p193: page 1]
CAMtasticDXP (TM):
