nasser1245/Imona-Stand-Charger/electroparts/optoEncoder/optoEncoder.pdf

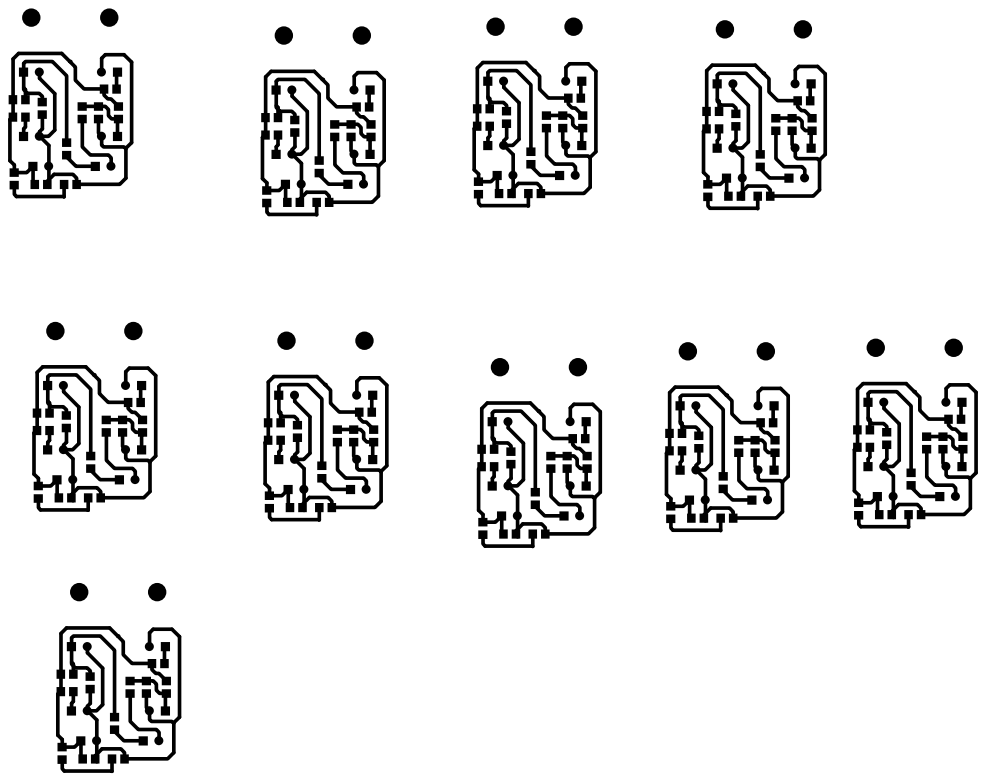
[picture p194: page 1]
