nasser1245/Imona-Stand-Charger/electroparts/SchmitOpto/1.pdf

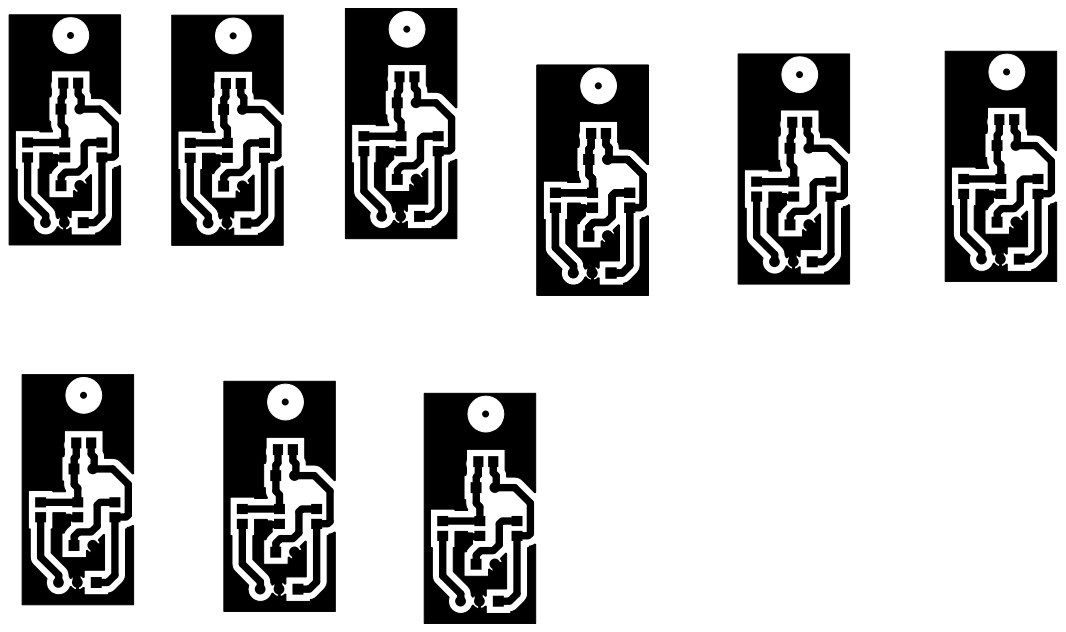
[picture p195: page 1]
