nasser1245/Imona-Stand-Charger/electroparts/shelfControl/Project Outputs for shelfControl/11.pdf

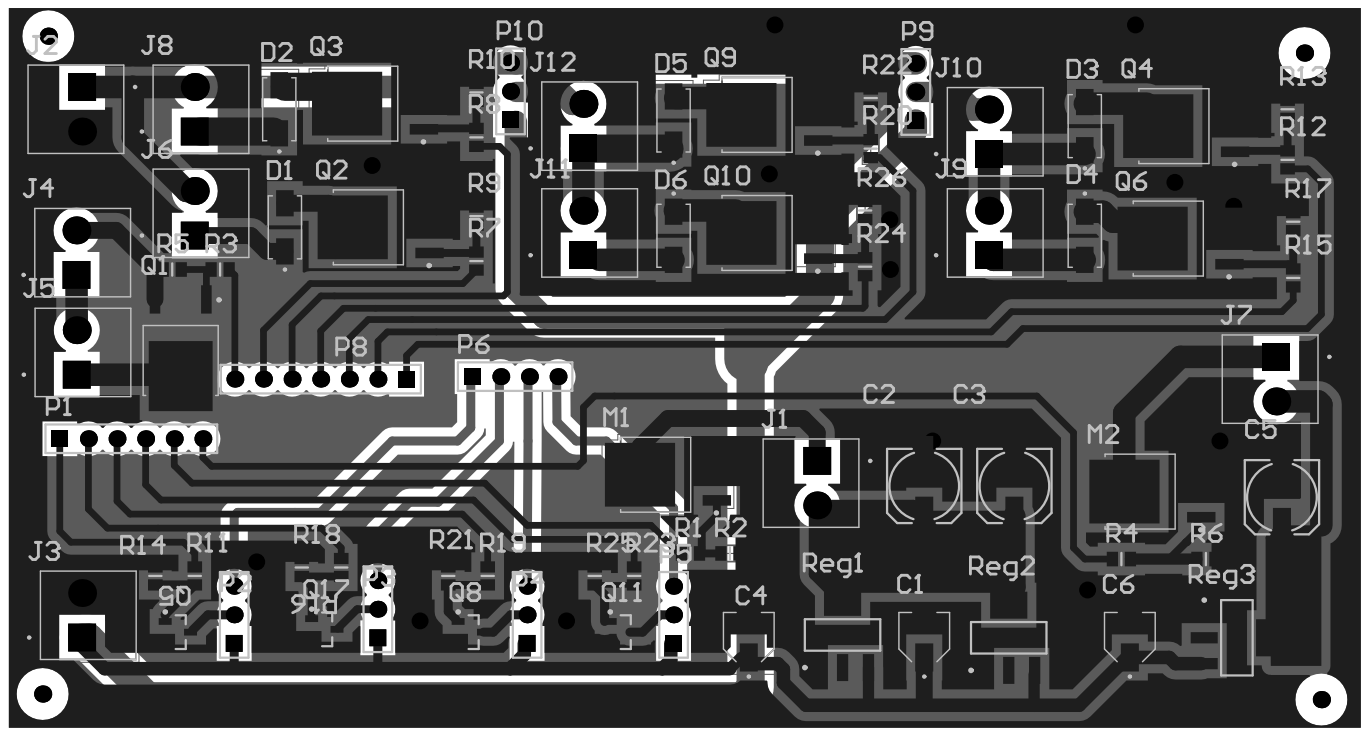
[picture p196: page 1]
