nasser1245/Imona-Stand-Charger/electroparts/shelfControl/Project Outputs for shelfControl/12.pdf

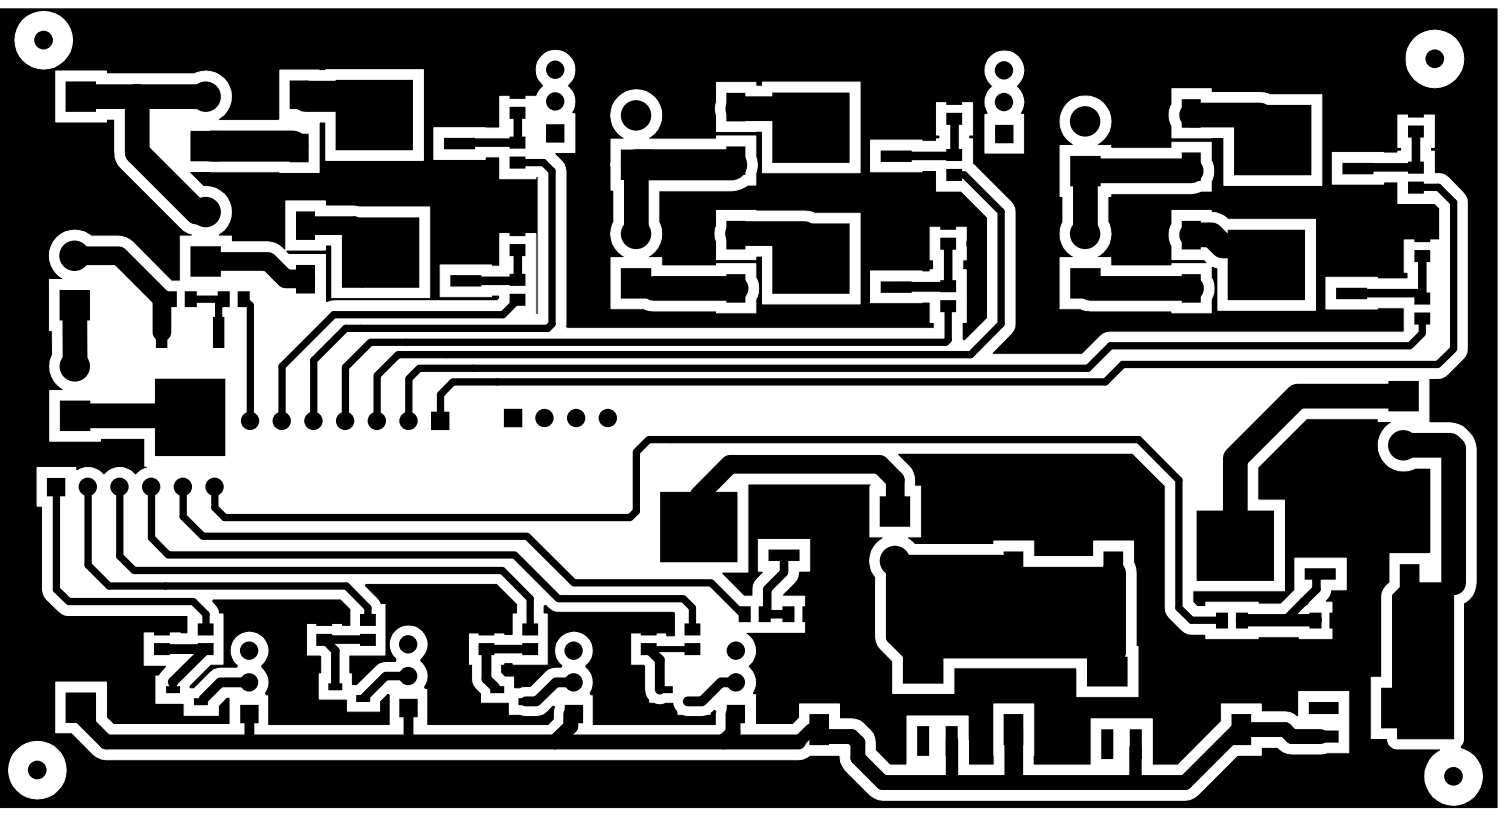
[picture p197: page 1]
