nasser1245/Imona-Stand-Charger/(list of files, drawings)

Other design files:
electroparts/chargerLib.PcbLib
electroparts/divisor/divisor-new.PcbDoc
electroparts/divisor/divisor.PcbDoc
electroparts/divisor/divisor.PrjPCB
electroparts/divisor/divisor.SchDoc
electroparts/divisor/Imported S1M.lia/S1M.PcbLib
electroparts/divisor/Imported S1M.lia/S1M.SchLib
electroparts/fast charger/FastCharge1.PcbDoc
electroparts/fast charger/FASTCHARGE.PcbDoc
electroparts/fast charger/FastCharge.PrjPcb
electroparts/fast charger/FastCharge.SchDoc
electroparts/fast charger/old/charger.PrjPCB
electroparts/fast charger/old/charger.SchDoc
electroparts/fast charger/old/chargerNewD.PcbDoc
electroparts/fast charger/old/Schlib.SchLib
electroparts/fast charger/Schlib.SchLib
electroparts/Imported 1-292303-1.lia/1-292303-1.PcbLib
electroparts/Imported 1-292303-1.lia/1-292303-1.SchLib
electroparts/Imported 6-1123723-2.lia/6-1123723-2.PcbLib
electroparts/Imported 6-1123723-2.lia/6-1123723-2.SchLib
electroparts/Imported 16SVPC100M.lia/16SVPC100M.PcbLib
electroparts/Imported 16SVPC100M.lia/16SVPC100M.SchLib
electroparts/Imported (1) 16SVPC100M.lia/16SVPC100M.PcbLib
electroparts/Imported (1) 16SVPC100M.lia/16SVPC100M.SchLib
electroparts/Imported (1) CAPAE660X800N.lia/CAPAE660X800N.PcbLib
electroparts/Imported CAPAE660X800N.lia/CAPAE660X800N.PcbLib
electroparts/Imported CAPAE830X1050N.lia/CAPAE830X1050N.PcbLib
electroparts/Imported DIOM5436X245N.lia/DIOM5436X245N.PcbLib
electroparts/Imported EEEHA1H101UP.lia/EEEHA1H101UP.PcbLib
electroparts/Imported EEEHA1H101UP.lia/EEEHA1H101UP.SchLib
electroparts/Imported IPD50P04P4L-11.lia/IPD50P04P4L-11.PcbLib
electroparts/Imported IPD50P04P4L-11.lia/IPD50P04P4L-11.SchLib
electroparts/Imported OSTTA020161.lia/OSTTA020161.PcbLib
electroparts/Imported OSTTA020161.lia/OSTTA020161.SchLib
electroparts/Imported S1M.lia/S1M.PcbLib
electroparts/Imported S1M.lia/S1M.SchLib
electroparts/Imported STPS2L60A.lia/STPS2L60A.PcbLib
electroparts/Imported STPS2L60A.lia/STPS2L60A.SchLib
electroparts/Imported UCL1E681MNL1GS.lia/UCL1E681MNL1GS.PcbLib
electroparts/Imported UCL1E681MNL1GS.lia/UCL1E681MNL1GS.SchLib
electroparts/IntegratedControl/ChargerControl.SchDoc
electroparts/IntegratedControl/ChargersControl.SchDoc
electroparts/IntegratedControl/IntegratedControl.PrjPCB
electroparts/IntegratedShelfControl/2_5Reg.SchDoc
electroparts/IntegratedShelfControl/2Reg.SchDoc
electroparts/IntegratedShelfControl/3_3Reg.SchDoc
electroparts/IntegratedShelfControl/ChargerControl.SchDoc
electroparts/IntegratedShelfControl/Control.SchDoc
electroparts/IntegratedShelfControl/HighCurrentFetGND.SchDoc
electroparts/IntegratedShelfControl/HighCurrentFetVcc.SchDoc
electroparts/IntegratedShelfControl/IntegratedShelfControl-main.SchDoc
electroparts/IntegratedShelfControl/IntegratedShelfControl.PrjPCB
electroparts/IntegratedShelfControl/IntegratedShelfControl.SchDoc
electroparts/IntegratedShelfControl/InvidualShelfSR.SchDoc
electroparts/IntegratedShelfControl/ISC.PcbDoc
electroparts/IntegratedShelfControl/ISC.SchDoc
electroparts/IntegratedShelfControl/MotorControl.SchDoc
electroparts/IntegratedShelfControl/MotorMosfet.SchDoc
electroparts/IntegratedShelfControl/SenLEDFet.SchDoc
electroparts/IntegratedShelfControl/SensorIn.SchDoc
electroparts/IntegratedShelfControl/ShiftRegister.SchDoc
electroparts/IntegratedShelfControl/ShiftRegs.SchDoc
electroparts/ir sensor with led/irsensorLED.PcbDoc
electroparts/ir sensor with led/irsensorLED.SchDoc
electroparts/MicroSwitch/MicroSwitch.PcbDoc
electroparts/MicroSwitch/MicroSwitch.PrjPCB
electroparts/MicroSwitch/MicroSwitch.SchDoc
electroparts/optoEncoder/optoEncoder.PrjPCB
electroparts/optoEncoder/optoEncoder.SchDoc
electroparts/optoEncoder/optoPCB.PcbDoc
electroparts/PhonePresent/PhonePresent-oldversion.PcbDoc
electroparts/PhonePresent/PhonePresent.PcbDoc
electroparts/PhonePresent/PhonePresent.PrjPCB
electroparts/PhonePresent/PhonePresent.SchDoc
electroparts/regularCharger/Imported EEEHA1H101UP.lia/EEEHA1H101UP.PcbLib
electroparts/regularCharger/Imported EEEHA1H101UP.lia/EEEHA1H101UP.SchLib
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
