nasser1245/Imona-Stand-Charger/(commit log)

2024-04-19 First Release
    [1-292303-1.PcbLib, 1-292303-1.SchLib, 1.5mm-n2-infrastructure surface simple.DWG, 16SVPC100M.PcbLib, 16SVPC100M.SchLib, 1mm-N1-below door cover.DWG, 1mm-N2-bottom surface.DWG, 1mm-n1-back cover.DWG]
2024-04-19 Add a sample render to readme.md
